jfri2/Purdue_MLEC/Hardware/KiCAD/MLEC_Doc/Images/MLEC_Front.PNG

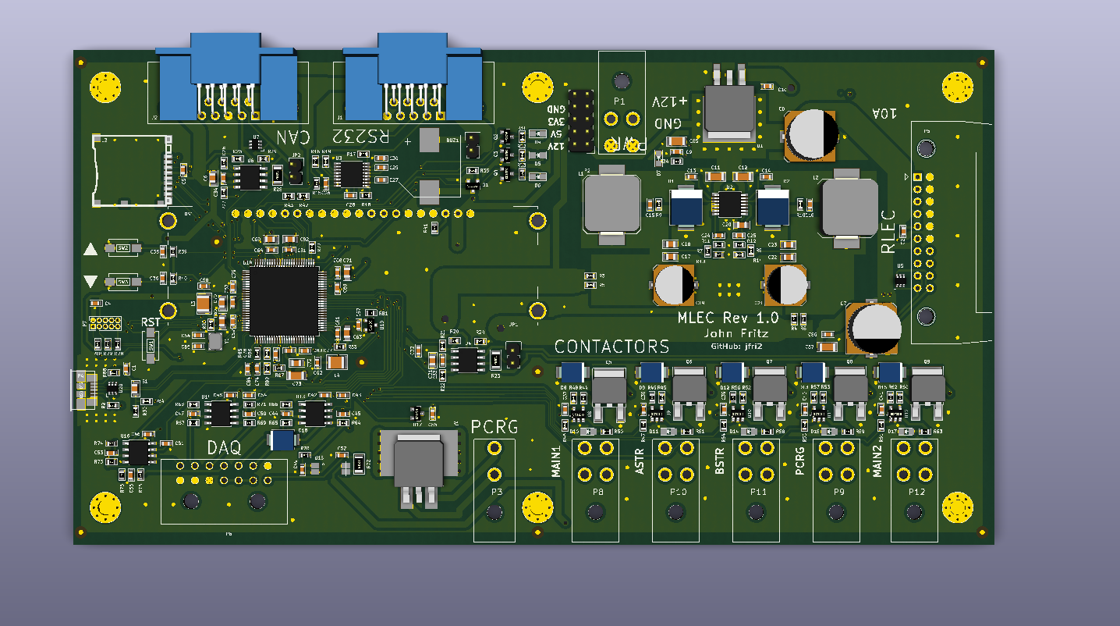
Hardware/KiCAD/MLEC_Doc/Images/MLEC_Front.PNG
