jfri2/Purdue_MLEC/Software/CANBusMonitor/CANBusMonitor/CANBusMonitor/Documentation/latex/md_README.tex

C\+A\+N\+Bus\+Monitor Ind. Study Project Purdue University

Author\+: John Fritz Created\+: 06 Mar 2016 Updated\+: 06 Mar 2016

Notes\+: S\+U\+T\+\_\+\+C\+K\+S\+EL fuse needs to be changed to E\+X\+T\+X\+O\+S\+C\+\_\+8\+M\+H\+Z\+\_\+\+X\+X\+\_\+16\+K\+C\+K\+\_\+14\+C\+K\+\_\+4\+M\+S1
