jfri2/Purdue_MLEC/Hardware/KiCAD/ATSAM_Based_Battery_Management_System.html

# MLEC BOM Rev 0.0

Date

# 2016-04-12

Company

# Purdue University

Comment 1

# John Fritz

Comment 2

Comment 3

Comment 4

Total Parts

# 272 (Unique 90)

Ref

Qty

Value

Footprint

Mfg#

Tolerance

Type

mfg#

[B] -

B1

1

Ferrite Bead

FritzLib:C_0805_OUTLINE

[BUZ] -

BUZ1

1

BUZZER

FritzLib:SMI-1324-TW-3V-R

[C] -

C2 C4 C5 C10 C9 C86 C26 C27 C29 C28 C30 C32 C34 C35 C36 C41 C40 C39 C37 C38 C48 C50 C54 C56 C42 C43 C44 C45 C55 C49 C46 C47 C51 C53 C52 C61 C57 C62 C66 C77 C78 C79 C80 C81 C67 C68 C59 C58 C83 C84

50

100nF

FritzLib:C_0603_OUTLINE

C1 C24

2

10nF

FritzLib:C_0603_OUTLINE

C6 C31

2

10uF

FritzLib:C_0805_OUTLINE

C8 C7

2

470uF

Capacitors_SMD:c_elec_10x10.5

C20 C63 C71 C60 C72 C82 C70 C69

8

4.7uF

FritzLib:C_0805_OUTLINE

C14 C13

2

33nF

FritzLib:C_0603_OUTLINE

C11 C12 C85 C87

4

10uF

FritzLib:C_1206_OUTLINE

C3216X5R1E106M

C22 C23 C18 C17

4

10uF

FritzLib:C_0805_OUTLINE

C2012X5R0J106M

C21 C19

2

100uF

Capacitors_SMD:c_elec_8x6.5

EEEFC1A101P

C25

1

6.8nF

FritzLib:C_0603_OUTLINE

C16 C15

2

470pF

FritzLib:C_0603_OUTLINE

C33

1

10uF

FritzLib:C_0603_OUTLINE

C73

1

22uF

FritzLib:C_1206_OUTLINE

Ceramic

C64 C65 C74

3

10pF

FritzLib:C_0603_OUTLINE

[D] -

D2 D1

2

MBRS320TR

Diodes_SMD:SMC_Standard

D7

1

Power

FritzLib:LED_0805_OUTLINE

D4

1

ULED1

FritzLib:LED_0805_OUTLINE

D5

1

ULED2

FritzLib:LED_0805_OUTLINE

D6

1

ULED3

FritzLib:LED_0805_OUTLINE

D16 D13 D12 D8 D9 D18

6

SS26

Diodes_SMD:SMB_Standard

D17

1

MAIN2

LEDs:LED_0805

D15

1

PCRG

LEDs:LED_0805

D14

1

BSTR

LEDs:LED_0805

D10

1

MAIN1

LEDs:LED_0805

D11

1

ASTR

LEDs:LED_0805

[DS] -

DS1

1

NHD-0216CW

FritzLib:NHD_OLED_2x16

[F] -

F1

1

10A

Fuse_Holders_and_Fuses:Fuseholder5x20_horiz_open_lateral_Type-II

[FI] -

FI1 FI2 FI3 FI4 FI5 FI6 FI7 FI8

8

Fiducal

Fiducials:Fiducial_1mm_Dia_2.54mm_Outer_CopperTop

[J] -

J1

1

RS232_0

FritzLib:Assmann_DB9_ADX09

J2

1

VEHICLE_CAN

FritzLib:Assmann_DB9_ADX09

J3

1

microSD_Card

FritzLib:microsd_socket

[JP] -

JP1 JP2 JP3

3

JUMPER

Pin_Headers:Pin_Header_Straight_1x02

[L] -

L2 L1

2

22uH

Inductors:SELF-WE-PD-XXL

MSS1278-153ML

L4 L3

2

10uH

FritzLib:C_1210_OUTLINE

[P] -

P8

1

MAIN_1_CONT

Connectors_Molex:Molex_Microfit3_Header_02x02_Angled_43045-040x

0039301042

P9

1

PCRG_CONT

Connectors_Molex:Molex_Microfit3_Header_02x02_Angled_43045-040x

0039301042

P10

1

ASTR_CONT

Connectors_Molex:Molex_Microfit3_Header_02x02_Angled_43045-040x

0039301042

P11

1

BSTR_CONT

Connectors_Molex:Molex_Microfit3_Header_02x02_Angled_43045-040x

0039301042

P12

1

MAIN_2_CONT

Connectors_Molex:Molex_Microfit3_Header_02x02_Angled_43045-040x

0039301042

P5

1

RLEC

FritzLib:3M_RightAngle_20pos_N3428-5202RB

N3428-5202RB

P7

1

JTAG

Pin_Headers:Pin_Header_Straight_2x05_Pitch1.27mm

P4

1

USB_OTG

FritzLib:conn_usb_B_micro_smd

P2

1

PWR_JP

Pin_Headers:Pin_Header_Straight_2x05

P3

1

PCRG

Connectors_Molex:Molex_Microfit3_Header_02x01_Angled_43045-020x

P6

1

MLEC_DAQ_CONN

Connectors_Molex:Molex_Microfit3_Header_02x07_Angled_43045-140x

0430451401

P1

1

12V_CONN

Connectors_Molex:Molex_Microfit3_Header_02x02_Angled_43045-040x

[Q] -

Q4 Q3 Q2 Q1

4

BSS214N

TO_SOT_Packages_SMD:SOT-23

Q9 Q8 Q7 Q5 Q6

5

AOD516

TO_SOT_Packages_SMD:TO-252-2Lead

[R] -

R1

1

100

FritzLib:D2PAK-2Lead-7106DG_Heatsink

R2 R6 R4 R5 R3 R18 R19 R16 R17 R21 R22 R26 R27 R41 R60 R53 R52 R44 R45

19

0R

FritzLib:R_0603_OUTLINE

R8 R7 R30

3

20k

FritzLib:R_0603_OUTLINE

R12

1

6.34k

FritzLib:R_0603_OUTLINE

R14

1

698

FritzLib:R_0603_OUTLINE

R10 R9

2

10

FritzLib:R_0603_OUTLINE

R11

1

3.83k

FritzLib:R_0603_OUTLINE

R13

1

422

FritzLib:R_0603_OUTLINE

R15 R20 R24 R25 R29 R35 R39 R40 R42 R43 R62 R57 R56 R48 R49 R84 R88

17

10k

FritzLib:R_0603_OUTLINE

R23 R28

2

120

FritzLib:R_1206_OUTLINE

R34 R61 R63 R55 R59 R54 R58 R46 R50 R47 R51 R71 R76 R66 R64 R87

16

1k

FritzLib:R_0603_OUTLINE

R31 R32 R33

3

470

FritzLib:R_0603_OUTLINE

R69 R75 R65

3

19k

FritzLib:R_0603_OUTLINE

R70

1

100

FritzLib:R_0603_OUTLINE

R72

1

360

FritzLib:R_1206_OUTLINE

R67 R73

2

3.3k

FritzLib:R_0603_OUTLINE

R68 R74

2

5k

FritzLib:R_0603_OUTLINE

R81

1

4.7k

FritzLib:R_0603_OUTLINE

R83 R82

2

1R

FritzLib:R_0603_OUTLINE

R79 R80 R78

3

100k

FritzLib:R_0603_OUTLINE

R89

1

6.8k

FritzLib:R_0603_OUTLINE

1%

R85 R86

2

39R

FritzLib:R_0603_OUTLINE

R77

1

39

FritzLib:R_0603_OUTLINE

[SW] -

SW1

1

SW_RST

Buttons_Switches_SMD:SW_SPST_EVQPE1

SW2

1

OLED_UP_BUTTON

Buttons_Switches_SMD:SW_SPST_EVQPE1

SW3

1

OLED_DOWN_BUTTON

Buttons_Switches_SMD:SW_SPST_EVQPE1

[TP] -

TP1 TP6 TP11 TP9 TP4 TP2 TP7 TP12 TP10 TP5 TP3 TP8

12

TEST_1P

[U] -

U2

1

TPS54383

FritzLib:HTSSOP-14_4.4x5mm_Pitch0.65mm

U1

1

RBO40-40G

FritzLib:TO-263-2Lead

U3

1

ICL3221E

Housings_SSOP:TSSOP-16_4.4x5mm_Pitch0.65mm

U4 U6

2

SN65HVD230

Housings_SOIC:SOIC-8_3.9x4.9mm_Pitch1.27mm

U5 U7 U20

3

NUP2202

TO_SOT_Packages_SMD:SC-70-6

U12 U11 U10 U8 U9

5

IRS44273L

TO_SOT_Packages_SMD:SOT-23-5

U14 U16 U13

3

MCP6002

Housings_SOIC:SOIC-8_3.9x4.9mm_Pitch1.27mm

U17

1

MCP9700-TT

TO_SOT_Packages_SMD:SOT-23

U15

1

PC3H71x

FritzLib:PC3H710

U18

1

SAM3X4/8C-100LQFP

Housings_QFP:LQFP-100_14x14mm_Pitch0.5mm

U19

1

LM4040

TO_SOT_Packages_SMD:SOT-23

[W] -

W1 W2 W3 W4 W5 W6

6

GND

Mounting_Holes:MountingHole_3.2mm_M3_Pad_Via

[Y] -

Y1

1

12MHz

Crystals:crystal_FA238-TSX3225

# BOM made with KICAD_BOM_WIZARD (https://github.com/HashDefineElectronics/KiCad_BOM_Wizard) (Generated 4/18/2016 9:53:42 PM)
