jfri2/Purdue_MLEC/Hardware/KiCAD/ATSAM_Based_Battery_Management_System_BOM.xlsx

Title | MLEC
Revision | 1
Date | 2016-04-12
Generated | 2016-04-18 21:56
Company | Purdue University
Designer | John Fritz
Total Parts | 246
Total Unique Parts | 71
 |  | Reference | Qty (1 board theory) | Qty (1 board actual) | Qty (2 board actual) | Value | Tolerance | Footprint | Mfg# | DigiKey# | Comments
 |  | B1 | 1 | 2 | 5 | 600R Ferrite Bead |  | 0805 | MI0805K601R-10 | 240-2390-1-ND
 |  | BUZ1 | 1 | 1 | 2 | BUZZER |  | Custom | SMI-1324-TW-3V-R | 668-1386-5-ND
 |  | C2 C4 C5 C10 C9 C86 C26 C27 C29 C28 C30 C32 C34 C35 C36 C41 C40 C39 C37 C38 C48 C50 C54 C56 C42 C43 C44 C45 C55 C49 C46 C47 C51 C53 C52 C61 C57 C62 C66 C77 C78 C79 C80 C81 C67 C68 C59 C58 C83 C84 C33 | 51 | 100 | 150 | 100nF | 20% | 0603 | C0603C104M5RACTU | 399-7845-1-ND
 |  | C1 C24 | 2 | 4 | 10 | 10nF | 1% | 0603 | C0603C102F5GACTU | 399-7826-1-ND
 |  | C6 C31 C22 C23 C18 C17 | 6 | 8 | 20 | 10uF | 20% | 0805 | C0805C106K8RACTU | 490-1718-1-ND
 |  | C8 C7 | 2 | 3 | 5 | 470uF | 20% | SMD 10mm Dia | UCL1V471MNL1GS | 493-3961-1-ND
 |  | C20 C63 C71 C60 C72 C82 C70 C69 | 8 | 10 | 20 | 4.7uF | 10% | 0805 | C1206C475K3RACTU | 399-8204-1-ND
 |  | C14 C13 | 2 | 4 | 10 | 33nF | 10% | 0603 | C0603C333K3RACTU | 399-7904-1-ND
 |  | C11 C12 C85 C87 | 4 | 6 | 10 | 10uF | 10% | 1206 | C1206C106K3RACTU | 399-7442-1-ND
 |  | C21 C19 | 2 | 3 | 4 | 100uF | 20% | SMD 8mm Dia | EEEFC1A101P | PCE3989CT-ND
 |  | C25 | 1 | 3 | 10 | 6.8nF | 1% | 0603 | C0603C682F3GACTU | 399-11154-1-ND
 |  | C16 C15 | 2 | 4 | 10 | 470pF | 1% | 0603 | C1608C0G1H471F080AA | 445-5370-1-ND
 |  | C73 | 1 | 2 | 10 | 22uF |  | 1206 | C1206C226M8RACTU | 399-7444-1-ND
 |  | C64 C65 | 2 | 4 | 10 | 22pF | 1% | 0603 | C0603C220F1GACTU | 399-11145-1-ND
 |  | C74 | 1 | 2 | 10 | 10pF | 1% | 0603 | C0603C100F5GAC7867 | 399-9958-1-ND
 |  | D2 D1 | 2 | 3 | 4 | MBRS320TR |  | SMC | MBRS320 | MBRS320CT-ND
 |  | D7 | 1 | 2 | 10 | Power | Green | 0805 | HSMG-C170 | 516-1434-1-ND
 |  | D16 D13 D12 D8 D9 D18 | 6 | 8 | 20 | SS26 |  | SMB | SS26 | SS26FSCT-ND
 |  | D4 D5 D6 D10 D11 D14 D15 D17 | 8 | 10 | 20 | General LED | Amber | 0805 | HSMA-C170 | 516-1431-1-ND
 |  | DS1 | 1 | 1 | 2 | NHD-0216CW |  | Custom | NHD-0216CW-AB3 | NHD-0216CW-AB3-ND | If OLED is unused, DS1 can be left unpopulated
 |  | J1 | 1 | 1 | 2 | RS232_0 |  | DB9 Female | A-DF 09 A/KG-T4S | AE10924-ND | Alternate part: ADS09A-KG-TAXB5
 |  | J2 | 1 | 1 | 2 | VEHICLE_CAN |  | DB9 Male | A-DS 09 A/KG-T4S | AE10970-ND | Alternate part: ADF09A-KG-TASB5
 |  | J3 | 1 | 1 | 2 | microSD_Card |  | Custom microSD | 5027740891 | WM24066CT-ND
 |  | JPX | 1 | 1 | 2 | Breakaway Pin headers |  | Pin Header | PEC36SAAN | S1012E-36-ND
 |  | SHX | 3 | 3 | 10 | Jumper Shunts |  |  | 969102-0000-DA | 3M9580-ND
 |  | L2 L1 | 2 | 2 | 5 | 22uH |  | 12.5mm x 12.5mm | DRA127-220-R | 283-3590-1-ND
 |  | L4 L3 | 2 | 2 | 5 | 10uH |  | 1210 | CBC3225T100MR | 587-1625-1-ND
 |  | P8 P9 P10 P11 P12 P1 | 6 | 6 | 14 | 2x2 Connectors |  | Molex MiniFit jr 2x2 | 39301042 | WM21364-ND
 |  | P5 | 1 | 1 | 2 | RLEC |  | 20pos 3M Shrouded | N3428-5202RB | MHR20S-ND
 |  | P7 | 1 | 1 | 3 | JTAG |  | 10pos 1.27mm | 62201021121 | 732-5374-ND
 |  | P4 | 1 | 1 | 3 | USB_OTG |  | USB Micro-B | 10118192-0001LF | 609-4613-1-ND
 |  | P3 | 1 | 1 | 2 | PCRG |  | Molex MiniFit jr 1x2 | 39301022 | WM21363-ND
 |  | P6 | 1 | 1 | 2 | MLEC_DAQ_CONN |  | Molex MicroFit 2x7 | 430451401 | WM12758-ND
 |  | Q4 Q3 Q2 Q1 | 4 | 6 | 15 | BSS214N |  | SOT-23 | BSS214N H6327 | BSS214N H6327TR-ND | If Buzzer is unused Q1 can be left unpopulated
 |  | Q9 Q8 Q7 Q5 Q6 | 5 | 5 | 14 | AOD516 |  | DPAK | AOD516 | 785-1358-1-ND
 |  | HS1 | 1 | 1 | 3 | Heatsink |  | D2PAK | 7106DG | HS412-ND
 |  | R1 | 1 | 1 | 3 | 100 |  | D2PAK | PFS35-100RF1 | 696-1277-1-ND
 |  | R2 R6 R4 R5 R3 R18 R19 R16 R17 R21 R22 R26 R27 R41 R60 R53 R52 R44 R45 | 19 | 50 | 100 | 0R |  | 0603 | ERJ-3GEY0R00V | P0.0GCT-ND | If OLED is unused, R41 can be left unpopulated
 |  | R8 R7 R30 | 3 | 5 | 10 | 20k | 1% | 0603 | ERJ-3EKF2002V | P20.0KHCT-ND
 |  | R12 | 1 | 3 | 10 | 6.34k | 1% | 0603 | ERJ-3EKF6341V | P6.34KHCT-ND
 |  | R14 | 1 | 3 | 10 | 698 | 1% | 0603 | ERJ-3EKF6980V | P698HCT-ND
 |  | R10 R9 | 2 | 4 | 10 | 10 | 5% | 0603 | ERJ-PA3F10R0V | P10.00BYCT-ND
 |  | R11 | 1 | 3 | 10 | 3.83k | 1% | 0603 | ERJ-3EKF3831V | P3.83KHCT-ND
 |  | R13 | 1 | 3 | 10 | 422 | 1% | 0603 | ERJ-3EKF4220V | P422HCT-ND
 |  | R15 R20 R24 R25 R29 R35 R39 R40 R42 R43 R62 R57 R56 R48 R49 R84 R88 | 17 | 50 | 50 | 10k | 1% | 0603 | ERJ-3EKF1002V | P10.0KHCT-ND | If Buzzer is unused R35 can be left unpopulated. If OLED is unused, R42 and R43 can be left unpopulated
 |  | R23 R28 | 2 | 4 | 10 | 120 | 1% 1/8 Watt | 1206 | ERJ-8ENF1200V | P120FCT-ND
 |  | R34 R61 R63 R55 R59 R54 R58 R46 R50 R47 R51 R71 R76 R66 R64 R87 | 16 | 25 | 50 | 1k | 1% | 0603 | ERJ-3EKF1001V | P1.00KHCT-ND
 |  | R31 R32 R33 | 3 | 5 | 10 | 470 | 1/4 Watt | 0603 | ERJ-3EKF4700V | P470HCT-ND
 |  | R69 R75 R65 | 3 | 5 | 10 | 19k | 1% | 0603 | ERJ-3EKF1912V | P19.1KHCT-ND
 |  | R70 | 1 | 3 | 10 | 100 | 1/8 Watt | 0603 | ERJ-PA3F1000V | P100BYCT-ND
 |  | R72 | 1 | 3 | 10 | 360 | 1/2 Watt | 1206 | CRCW1206360RFKEAHP | 541-360UCT-ND
 |  | R67 R73 | 2 | 4 | 10 | 3.3k | 1% | 0603 | ERJ-3EKF3301V | P3.30KHCT-ND
 |  | R68 R74 | 2 | 4 | 10 | 5k | 1% | 0603 | ERJ-3EKF4991V | P4.99KHCT-ND
 |  | R81 | 1 | 3 | 10 | 4.7k |  | 0603 | ERJ-3EKF4701V | P4.70KHCT-ND
 |  | R83 R82 | 2 | 4 | 10 | 1 |  | 0603 | ERJ-3BQF1R0V | P17371CT-ND
 |  | R79 R80 R78 | 3 | 5 | 10 | 100k |  | 0603 | ERJ-3EKF1003V | P100KHCT-ND
 |  | R89 | 1 | 3 | 10 | 6.8k | 1% | 0603 | ERJ-3EKF6801V | P6.80KHCT-ND
 |  | R77 R85 R86 | 3 | 5 | 10 | 39 |  | 0603 | ERJ-6ENF39R0V | P39.0CCT-ND | If OLED is unused, R77 can be left unpopulated
 |  | SW1 SW2 SW3 | 3 | 5 | 10 | Pushbutton |  |  | EVQ-PE105K | P13594SCT-ND
 |  | U2 | 1 | 2 | 4 | TPS54383 |  | 14-HTSSOP | TPS54383PWP | 296-26995-5-ND
 |  | U1 | 1 | 2 | 4 | RBO40-40G |  | D2PAK | RBO40-40G-TR | 497-3714-1-ND
 |  | U3 | 1 | 2 | 4 | ICL3221E |  | 16-TSSOP | ICL3221EIVZ-T | ICL3221EIVZ-TCT-ND
 |  | U4 U6 | 2 | 3 | 6 | SN65HVD230 |  | 8-SOIC | SN65HVD230DR | 296-11654-1-ND
 |  | U5 U7 U20 | 3 | 5 | 10 | NUP2202 |  | 6-TSSOP | NUP2202W1T2G | NUP2202W1T2GOSCT-ND
 |  | U12 U11 U10 U8 U9 | 5 | 5 | 12 | IRS44273L |  | SOT-23-5 | IRS44273LTRPBF | IRS44273LTRPBFCT-ND
 |  | U14 U16 U13 | 3 | 5 | 8 | MCP6002 |  | 8-SOIC | MCP6002T-I/SN | MCP6002T-I/SNCT-ND
 |  | U17 | 1 | 3 | 5 | MCP9700-TT |  | SOT-23 | MCP9700T-E/TT | MCP9700T-E/TTCT-ND
 |  | U15 | 1 | 2 | 4 | PC3H71x |  | 4-SOIC | PC3H710NIP0F | 425-2108-1-ND
 |  | U18 | 1 | 2 | 3 | SAM3X4/8C-100LQFP |  | 100-LQFP | ATSAM3X8CA-AU | ATSAM3X8CA-AU-ND
 |  | U19 | 1 | 2 | 5 | LM4040 |  | SOT-23 | LM4040C30IDBZR | 296-20887-1-ND
 |  | Y1 | 1 | 2 | 4 | 12MHz |  | 4-SMD | FA-238V 12.0000MB-K3 | SER3682CT-ND
 |  | BOM made with KICAD_BOM_WIZARD (https://github.com/HashDefineElectronics/KiCad_BOM_Wizard.git)
 |  | Generated 4/18/2016 9:56:17 PM
