jfri2/Purdue_MLEC/Hardware/KiCAD/PDFs/ATSAM_Based_Battery_Management_System_Schematic.pdf

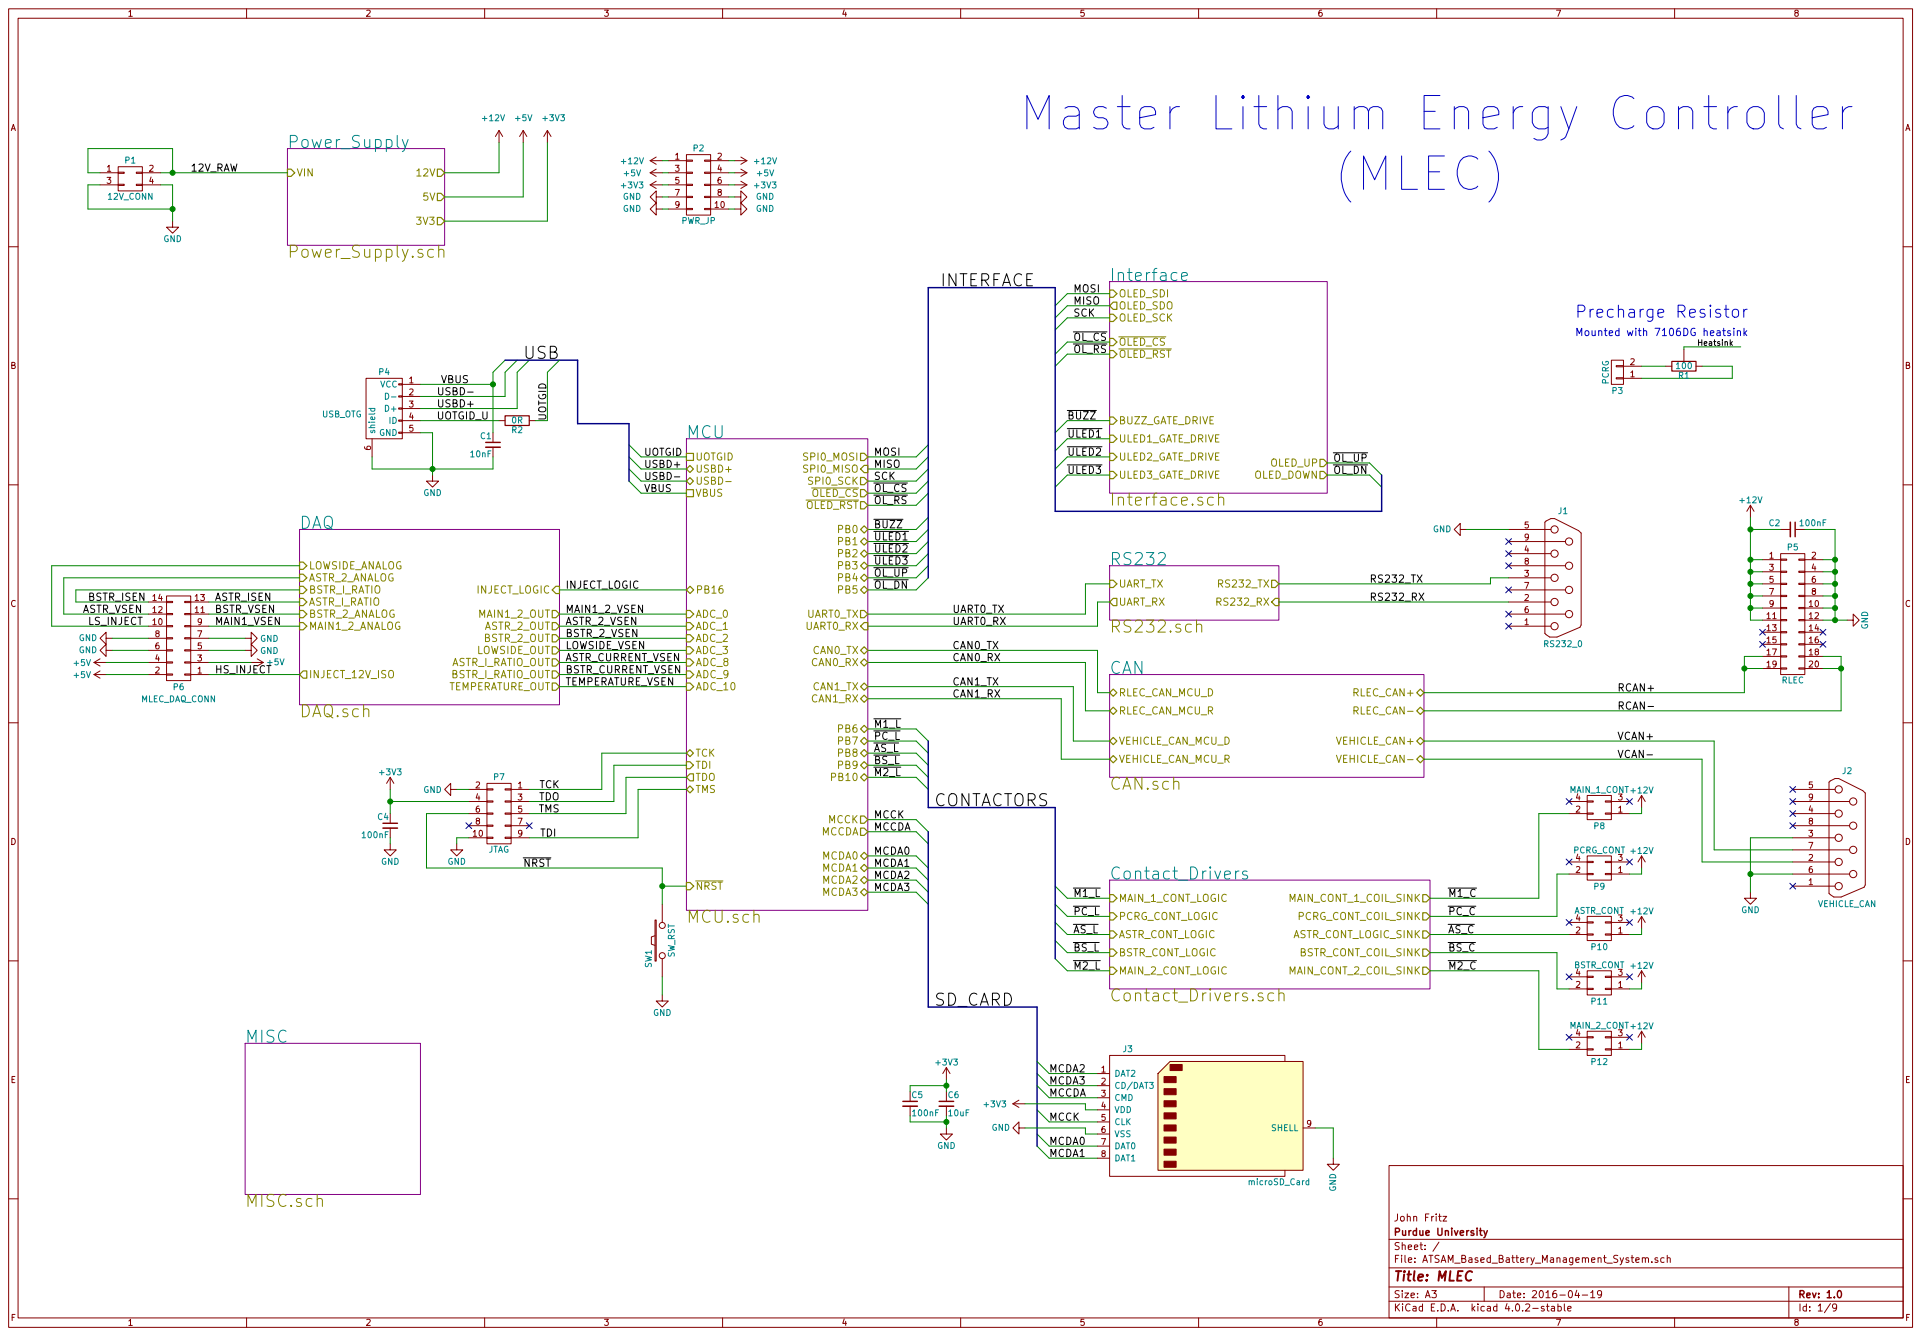
[picture p3: page 1]

Master Lithium Energy Controller

100 Heatsink MCU
TMS UOTGID
ADC_10 UOTGID
USBD+ VBUS USBD- TCK

LS_INJECT | | 10 | 9 MAIN1_VSEN | | ASTR_2_VSEN | UART0_RX

BSTR_2_VSEN
LOWSIDE_VSEN
ASTR_CURRENT_VSEN | | | | CAN0_RX
BSTR_CURRENT_VSEN | | | | CAN1_TX
TEMPERATURE_VSEN

File: ATSAM_Based_Battery_Management_System.sch Sheet: / Purdue University

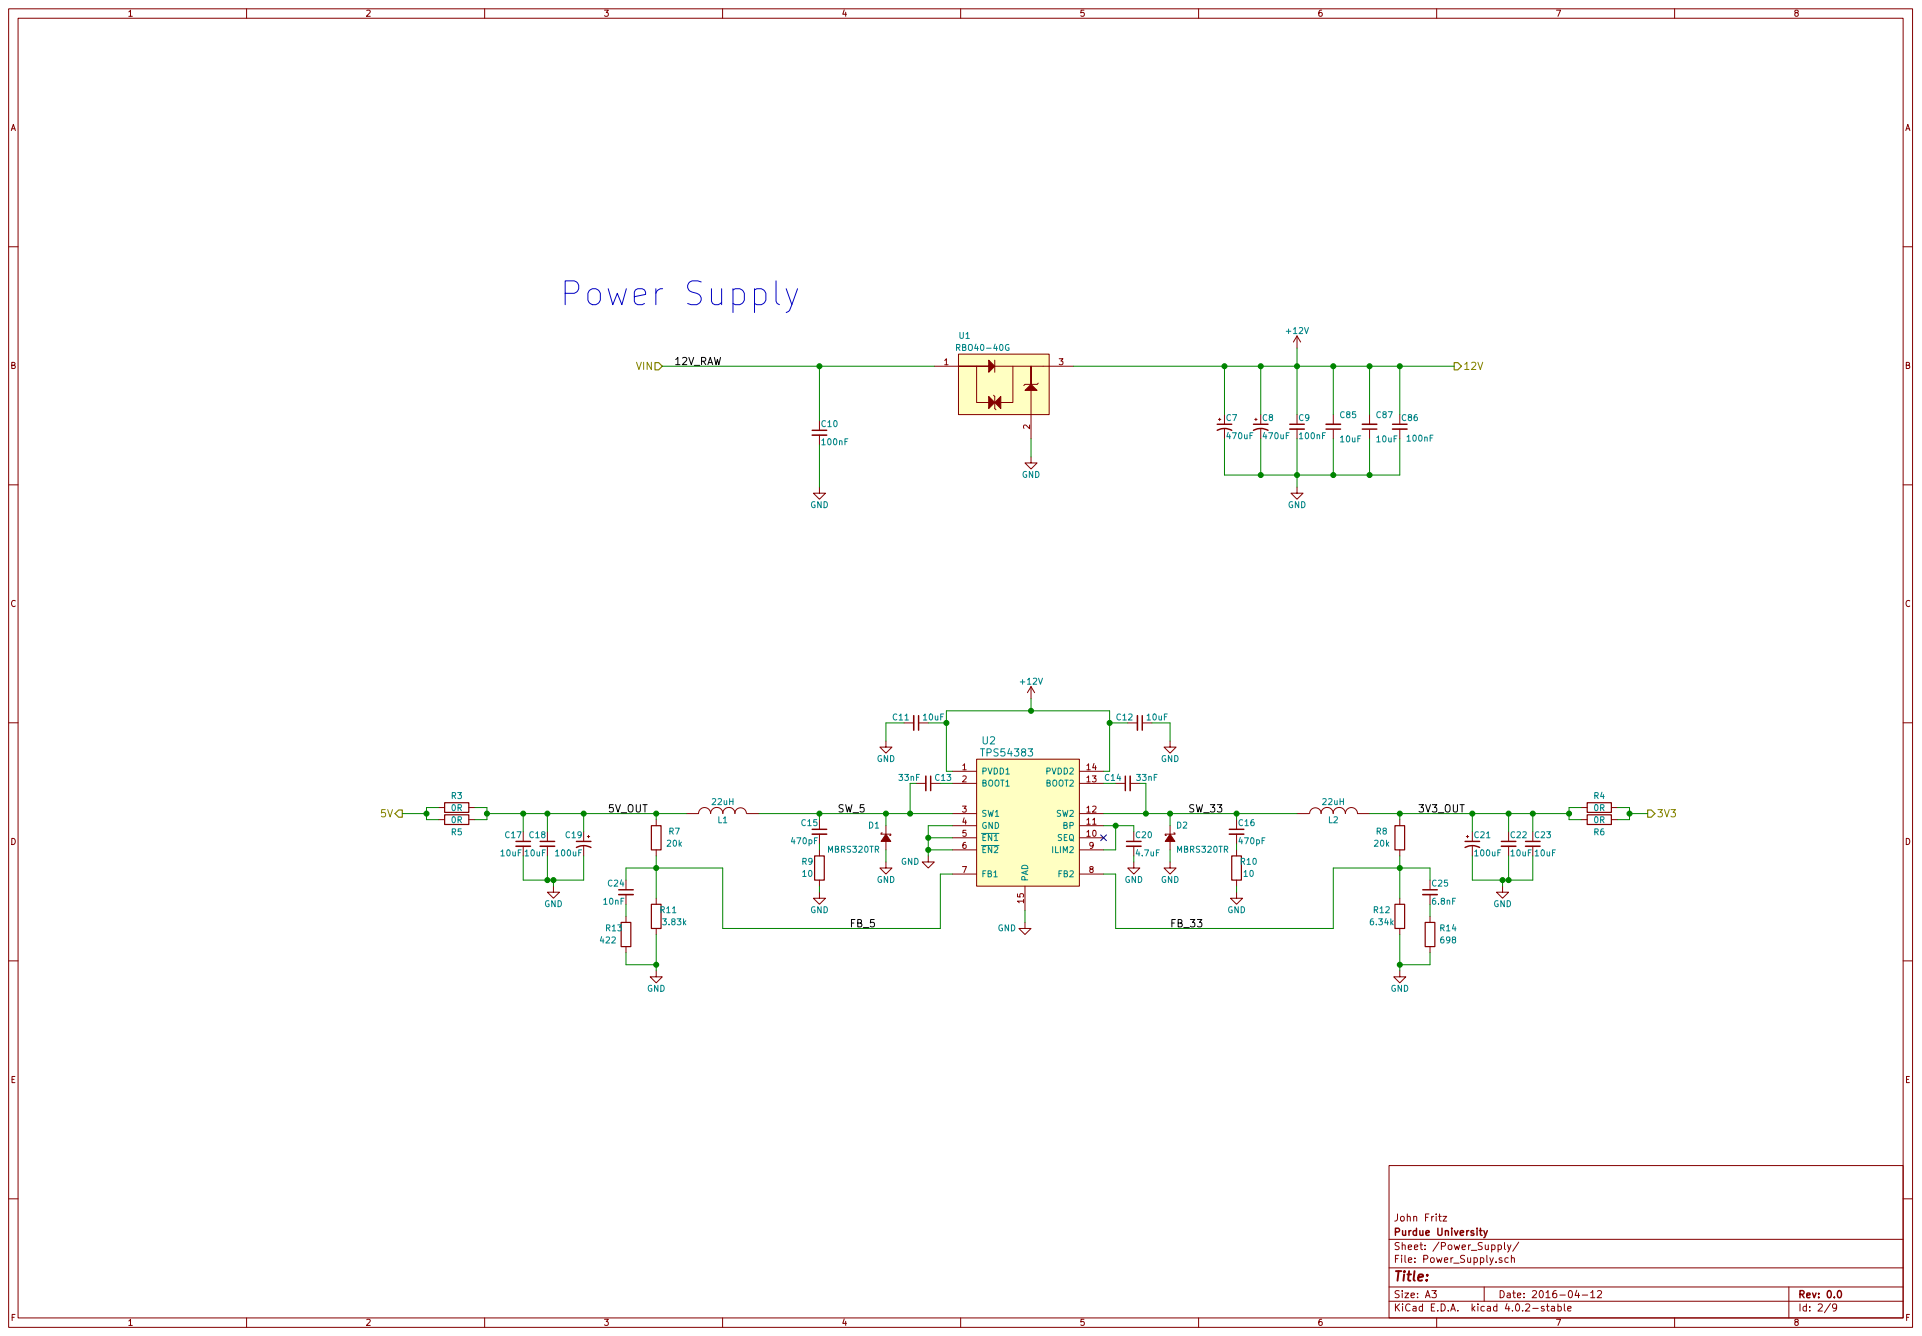
[picture p4: page 2]

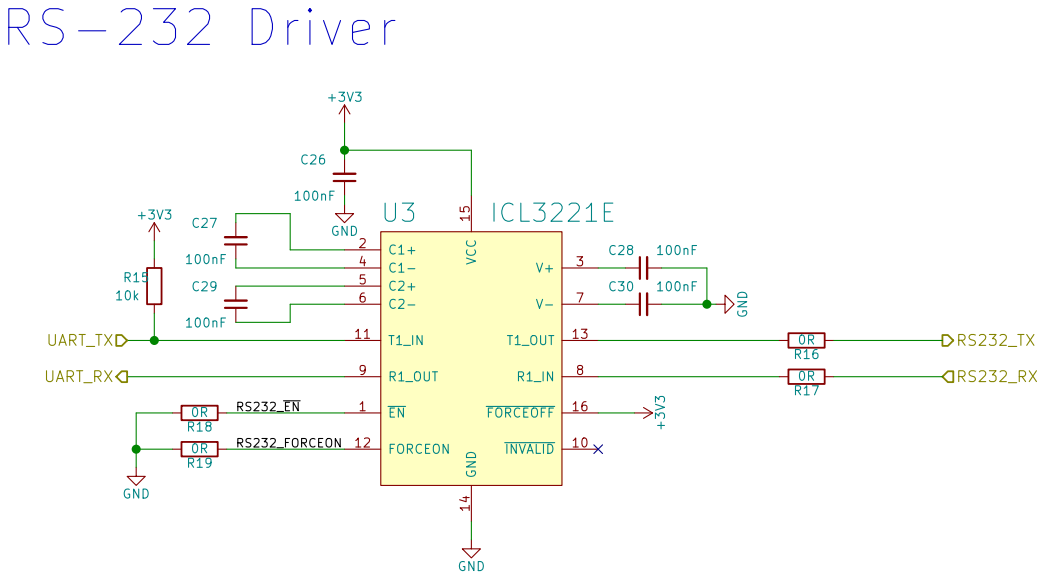
[picture p5: page 3]

John Fritz
Id: 3/9 Title: File: RS232.sch Sheet: /RS232/ Purdue University

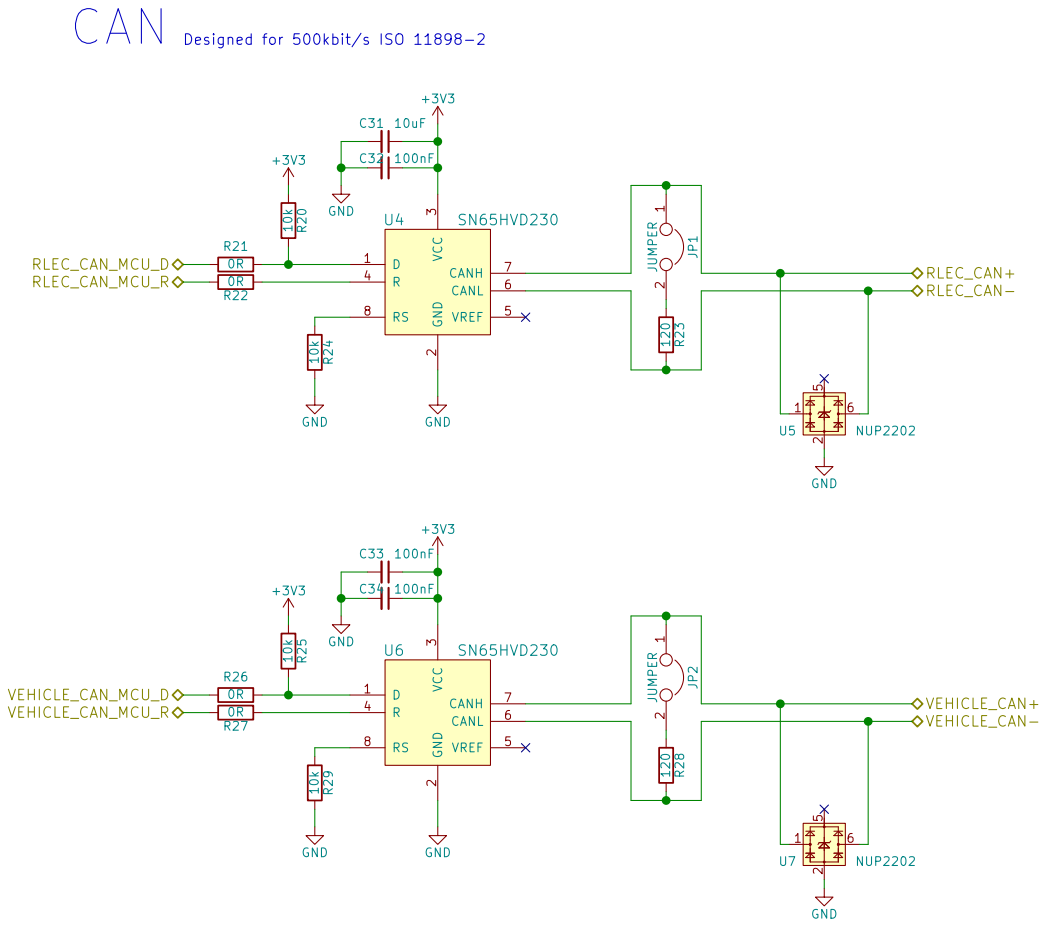
[picture p6: page 4]

John Fritz
Id: 4/9 Title: File: CAN.sch Sheet: /CAN/ Purdue University

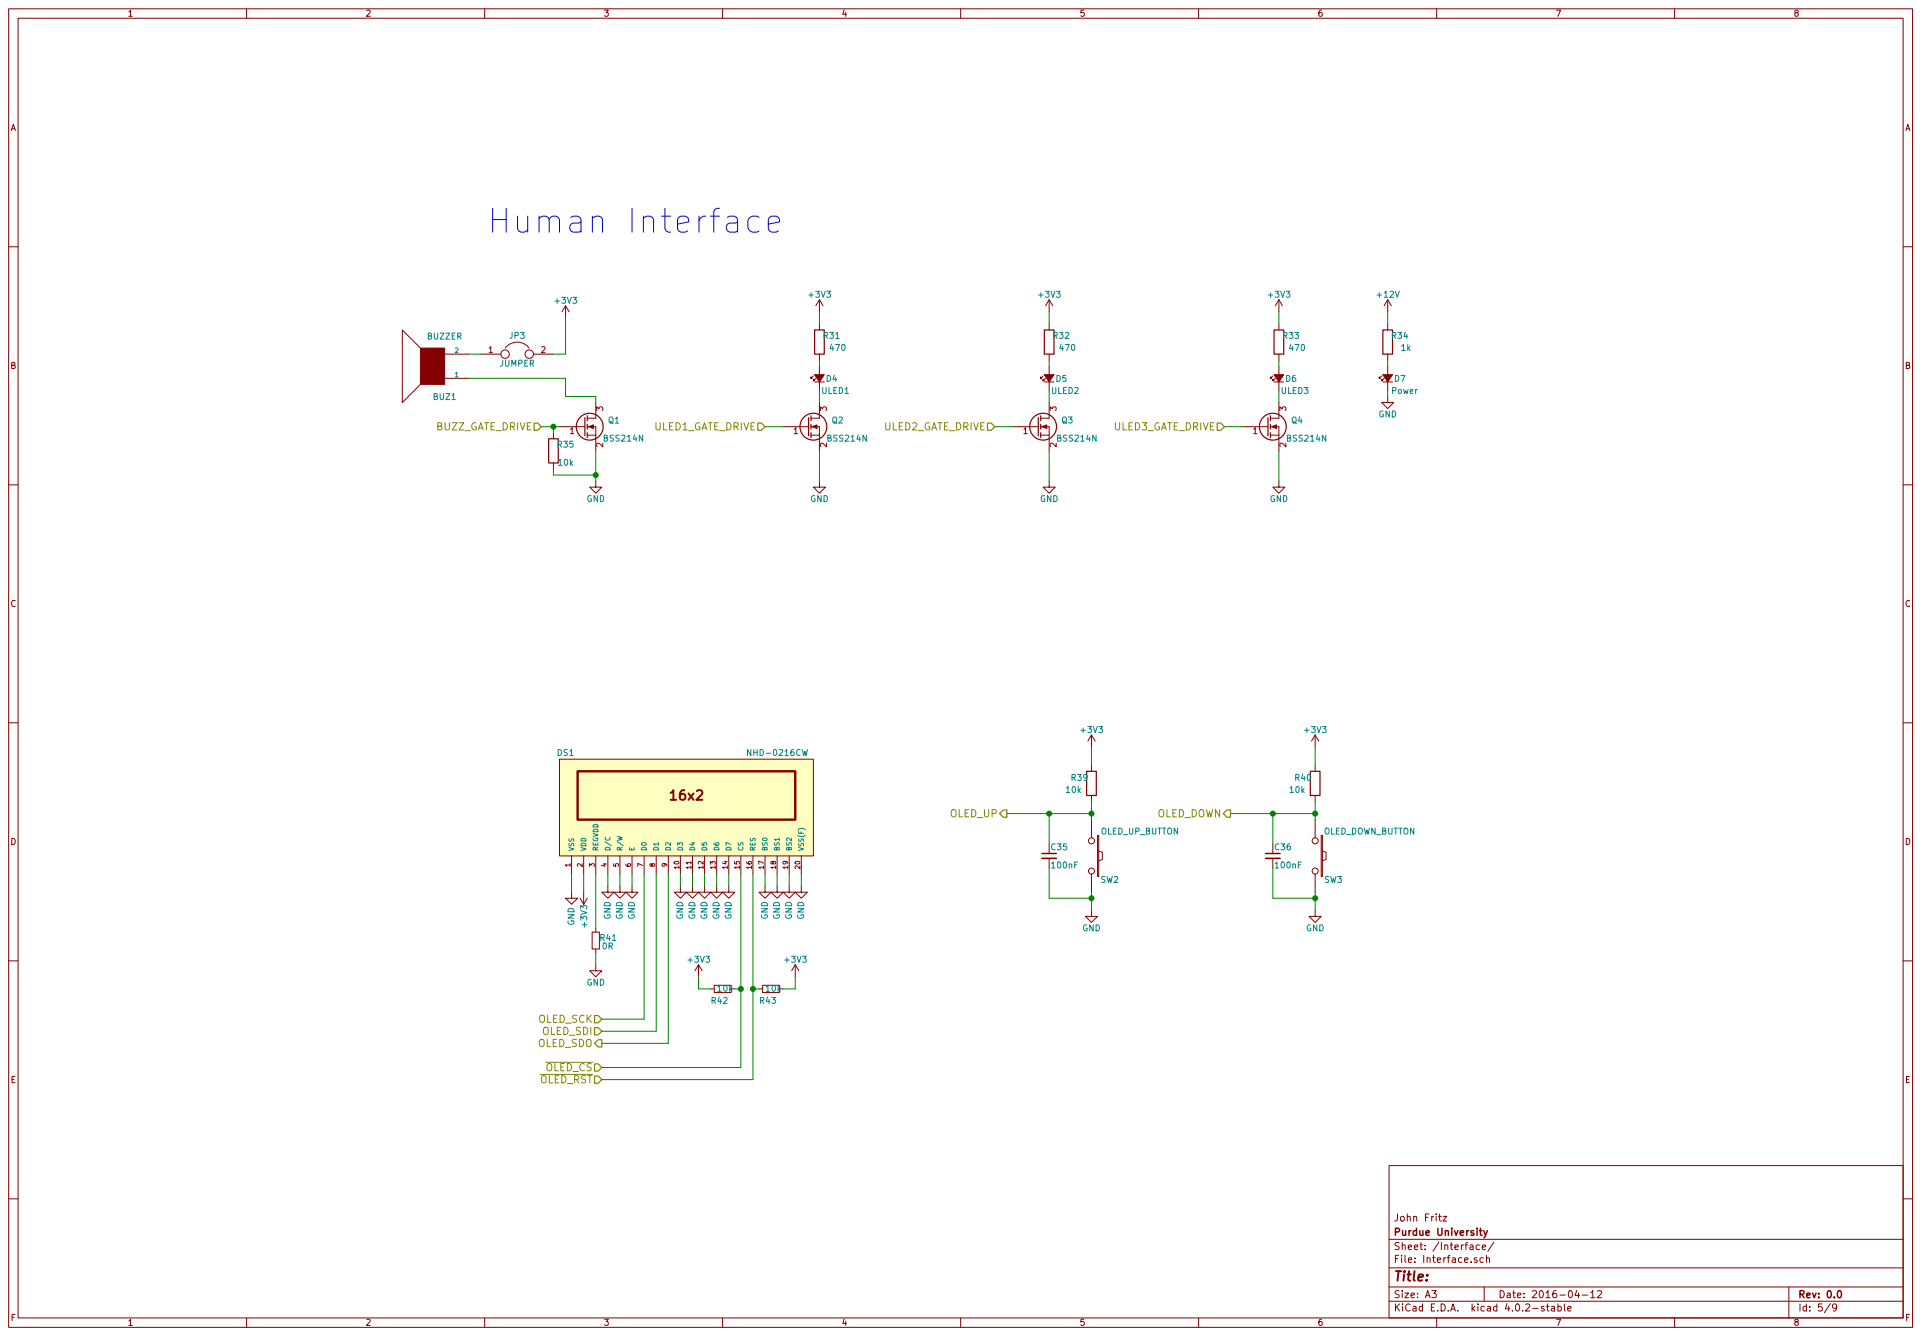
[picture p7: page 5]

9 D3 10 VSS(F) 20 D4 11 D5 12 D6 13 D7 14 CS 15 RES 16 BS0 17 BS1 18 BS2 19 DS1 NHD-0216CW GND +3V3 GND

John Fritz
Id: 5/9 Title: File: Interface.sch Sheet: /Interface/ Purdue University

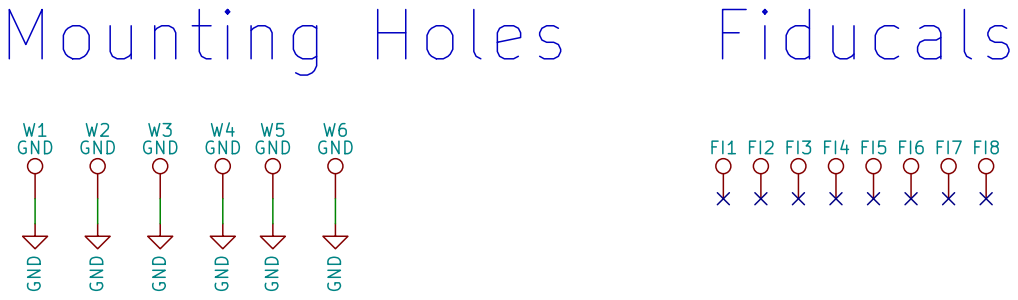
[picture p8: page 6]

John Fritz Mounting Holes

Id: 6/9 Title: File: MISC.sch Sheet: /MISC/ Purdue University

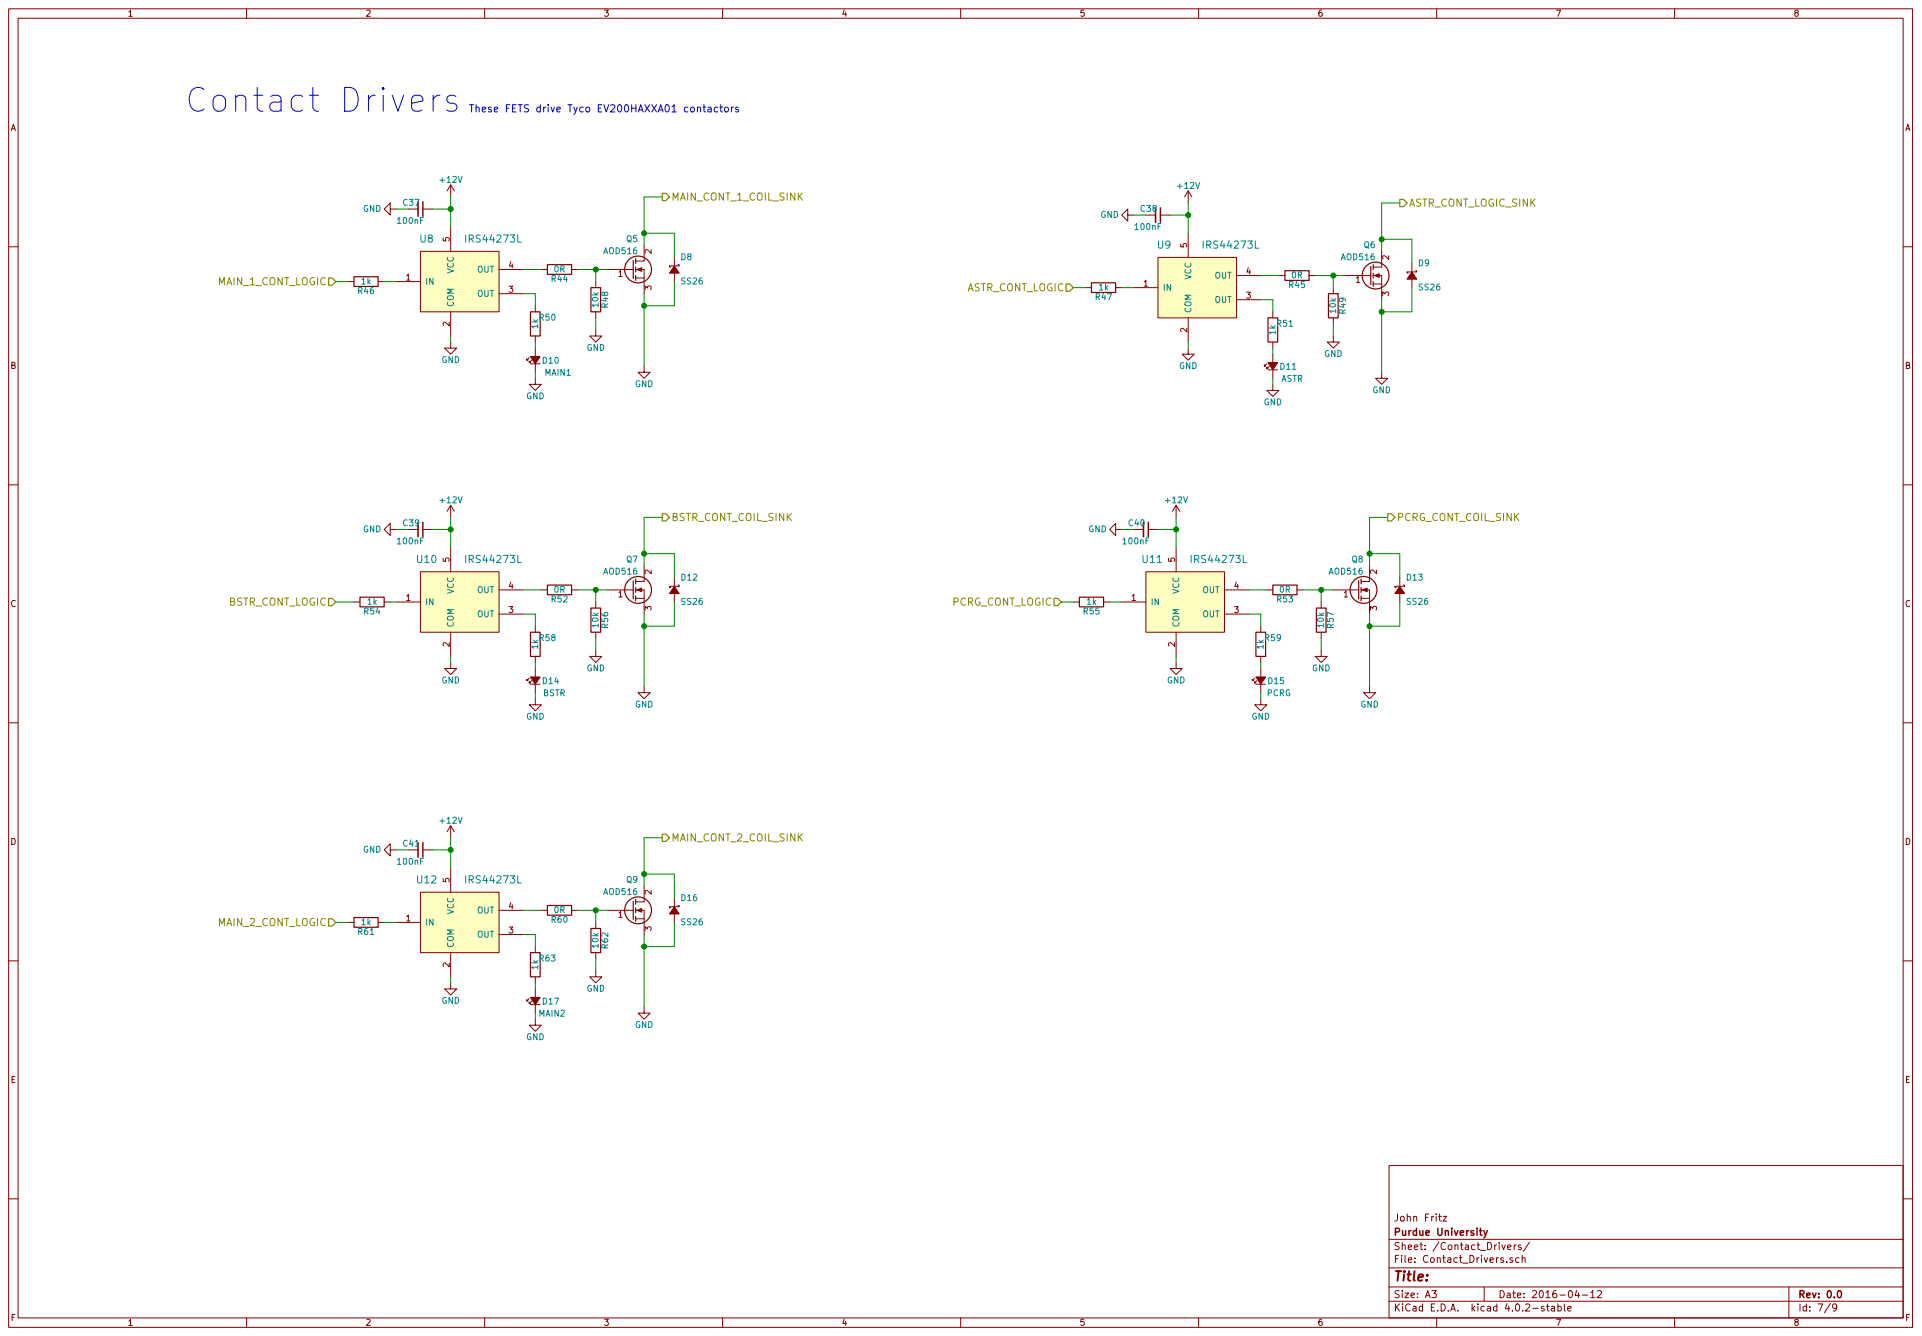
[picture p9: page 7]

R51 1k D11 ASTR GND Contact Drivers

These FETS drive Tyco EV200HAXXA01 contactors

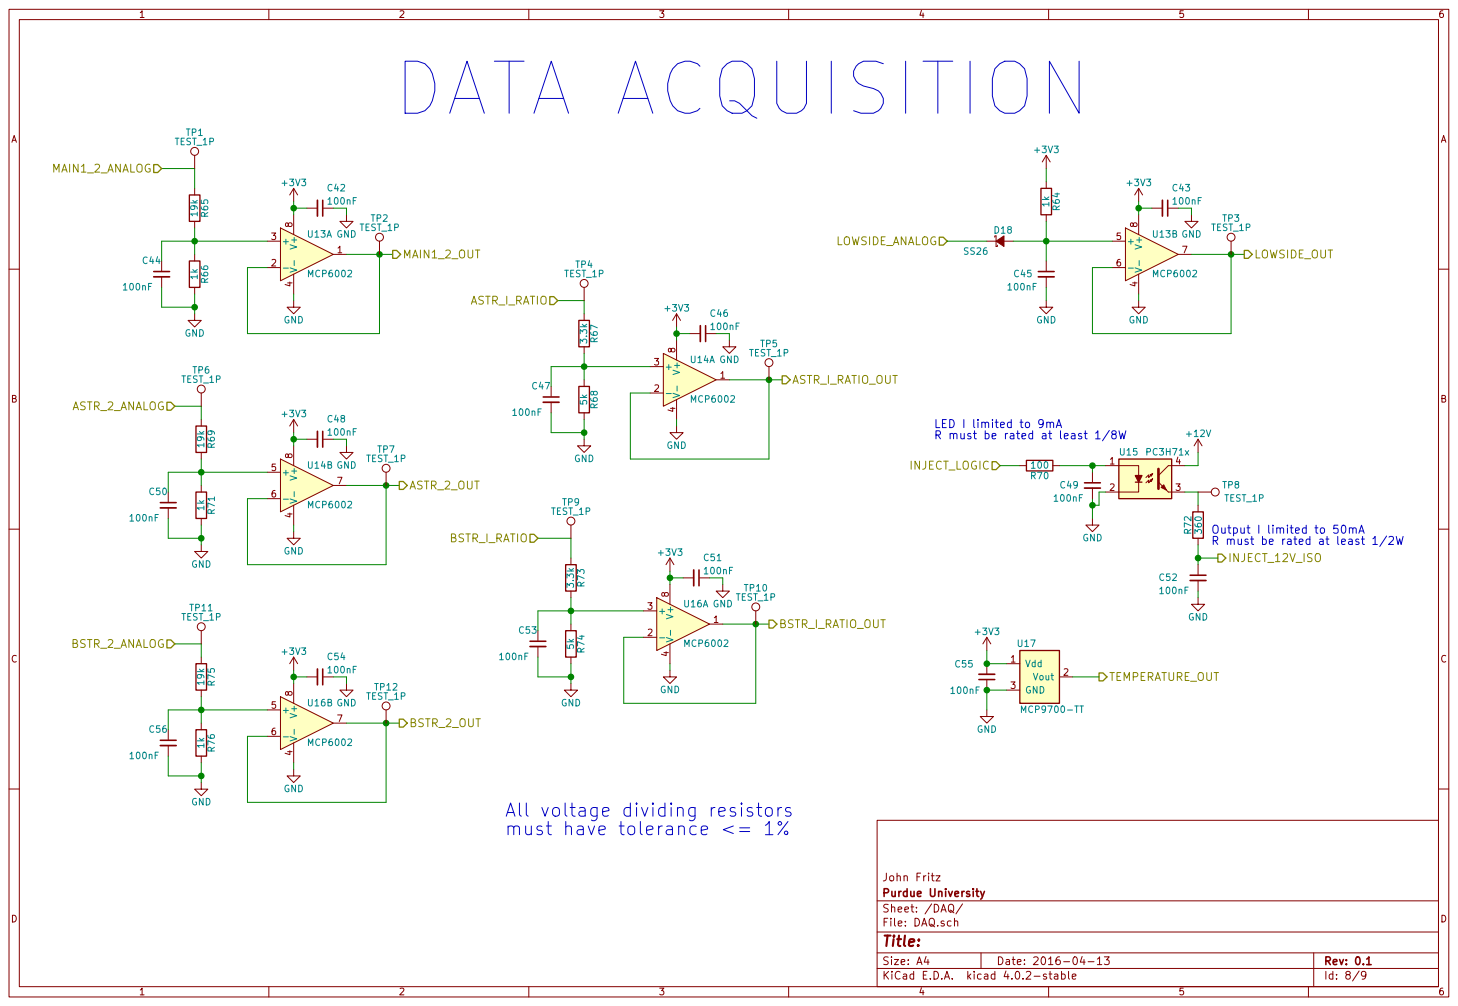
[picture p10: page 8]

LED I limited to 9mA
R must be rated at least 1/8W

Output I limited to 50mA
R must be rated at least 1/2W
INJECT_12V_ISO

All voltage dividing resistors

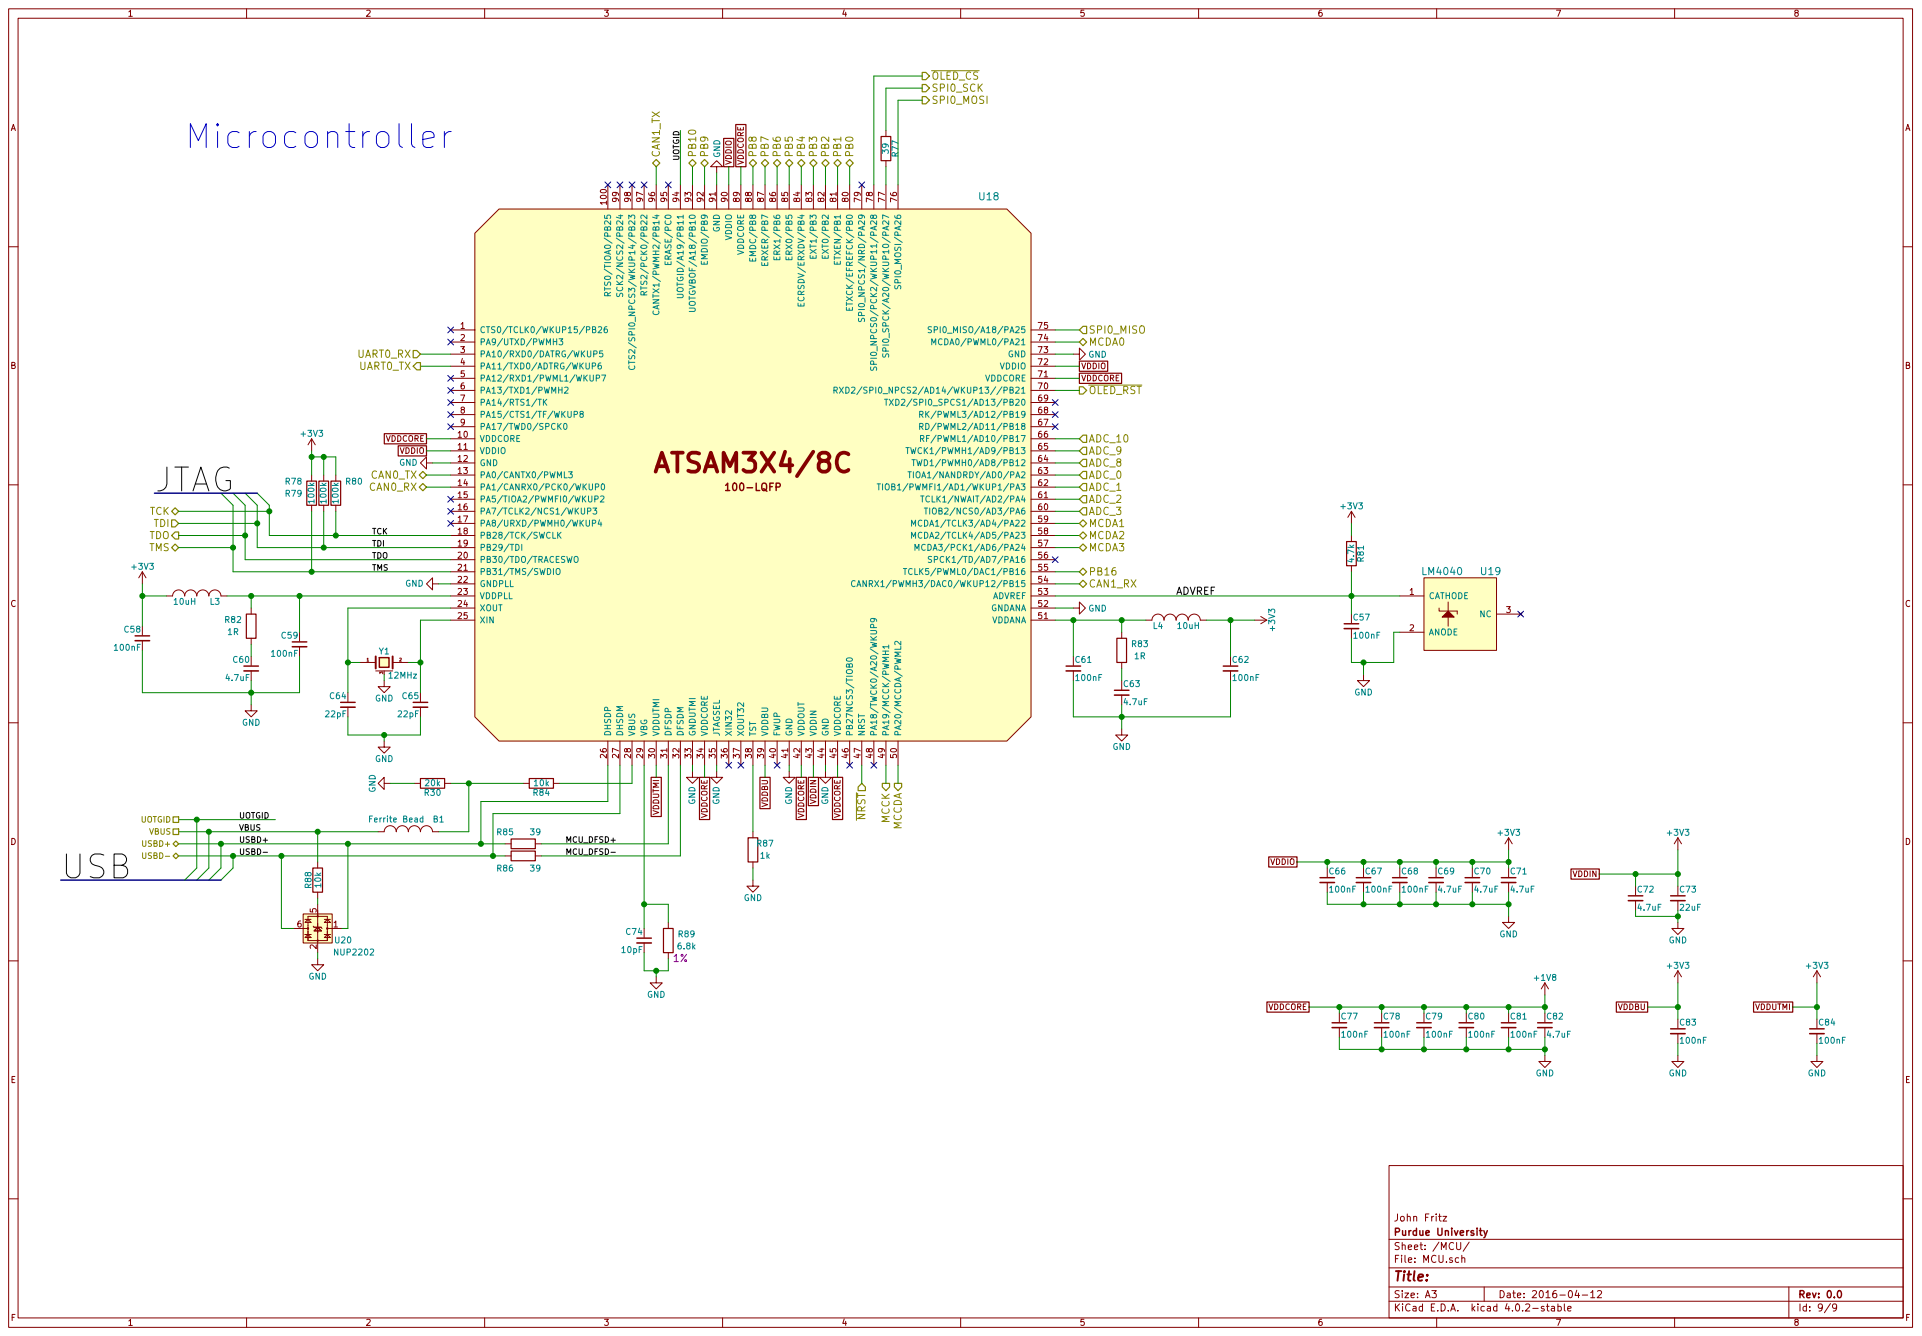
[picture p11: page 9]

USBD+ VBUS USBD- USB

John Fritz
Id: 9/9 Title: File: MCU.sch Sheet: /MCU/ Purdue University
