jfri2/Purdue_MLEC/Hardware/KiCAD/PDFs/BMS_High_Level_Block_Diagram.pdf

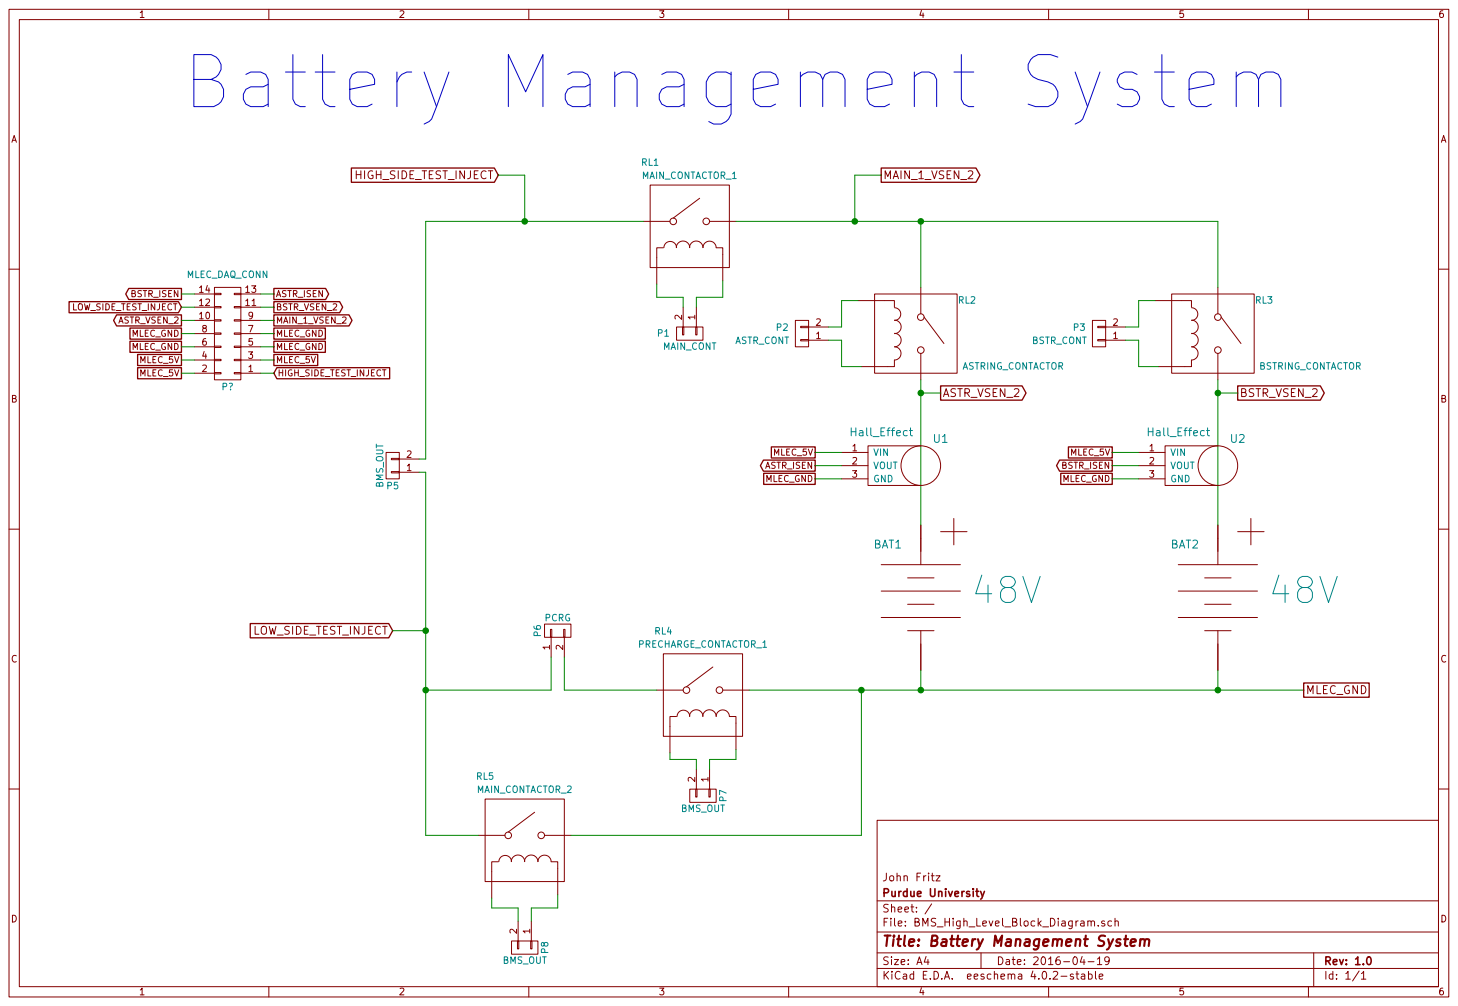
[picture p12: page 1]

John Fritz
File: BMS_High_Level_Block_Diagram.sch Sheet: / Purdue University

Id: 1/1 Title: Battery Management System
