jfri2/Purdue_MLEC/Hardware/KiCAD/PDFs/FAB_PDFs/DualMLEC/ATSAM_Based_Battery_Management_System-B.Cu.pdf

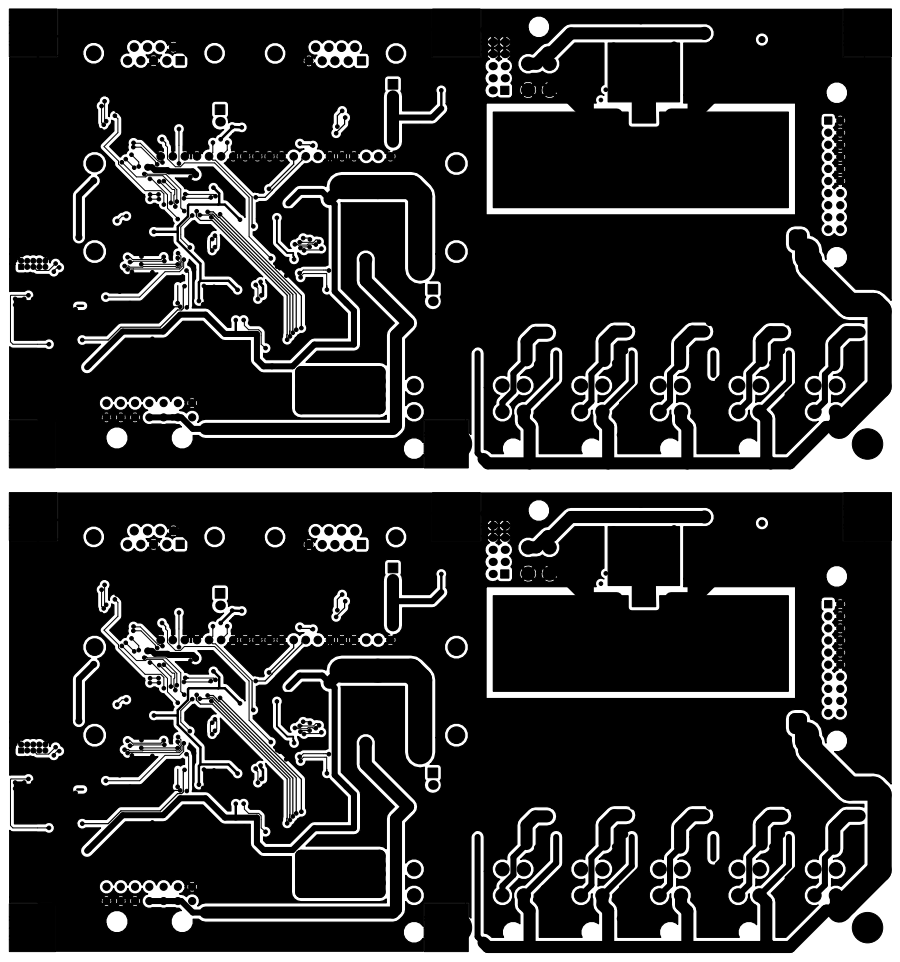
[picture p13: page 1]
