jfri2/Purdue_MLEC/Hardware/KiCAD/PDFs/FAB_PDFs/DualMLEC/ATSAM_Based_Battery_Management_System-B.Mask.pdf

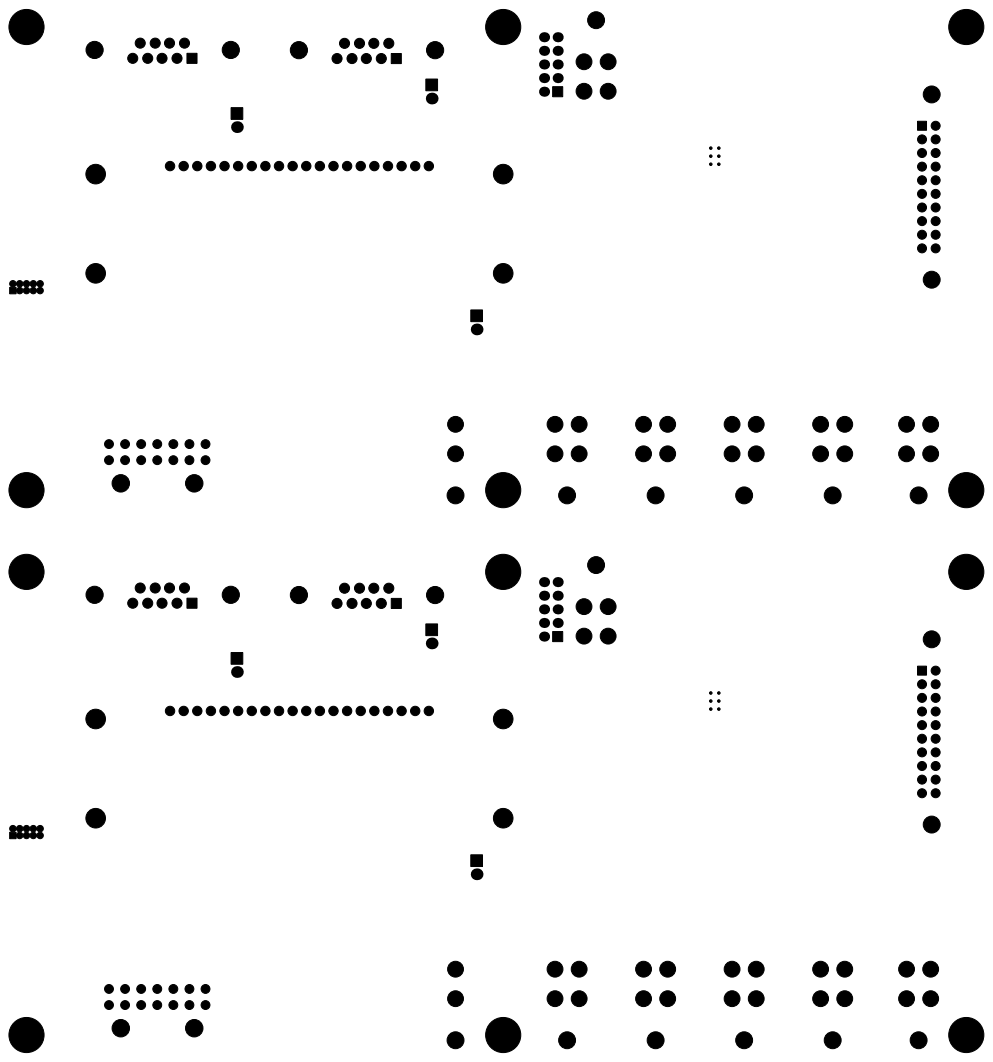
[picture p14: page 1]
