jfri2/Purdue_MLEC/Hardware/KiCAD/PDFs/FAB_PDFs/DualMLEC/ATSAM_Based_Battery_Management_System-F.Cu.pdf

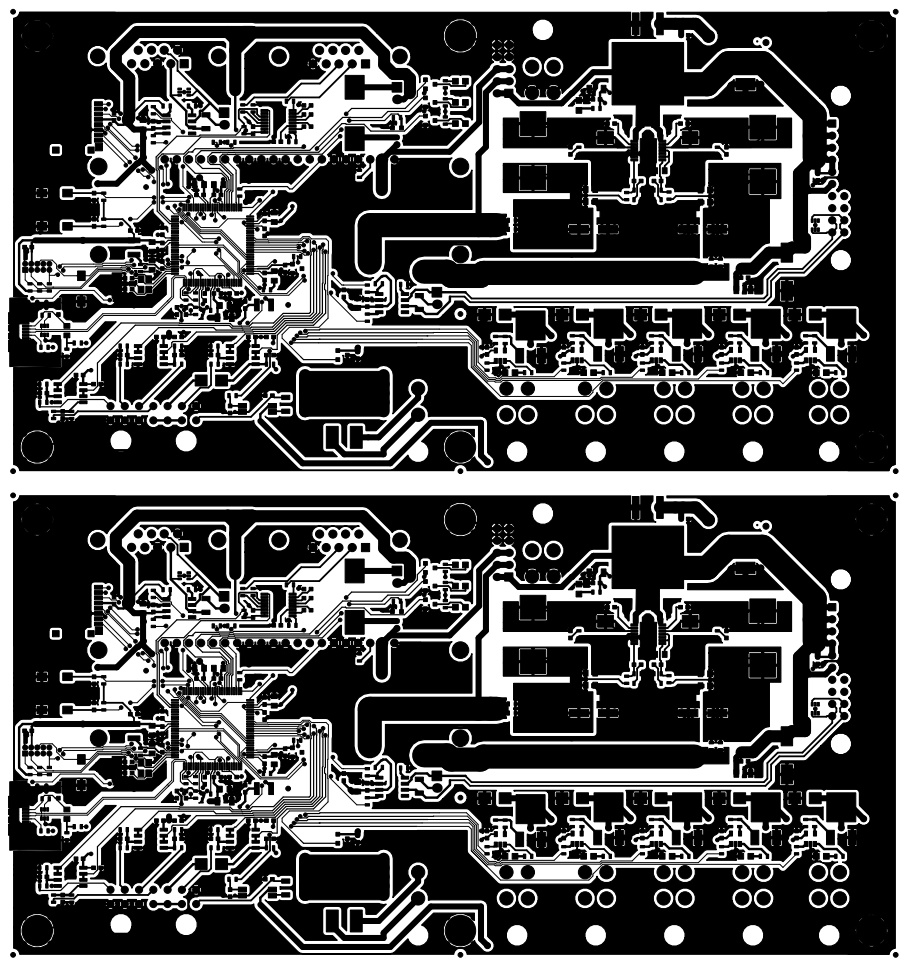
[picture p15: page 1]
