jfri2/Purdue_MLEC/Hardware/KiCAD/PDFs/FAB_PDFs/DualMLEC/ATSAM_Based_Battery_Management_System-F.SilkS.pdf

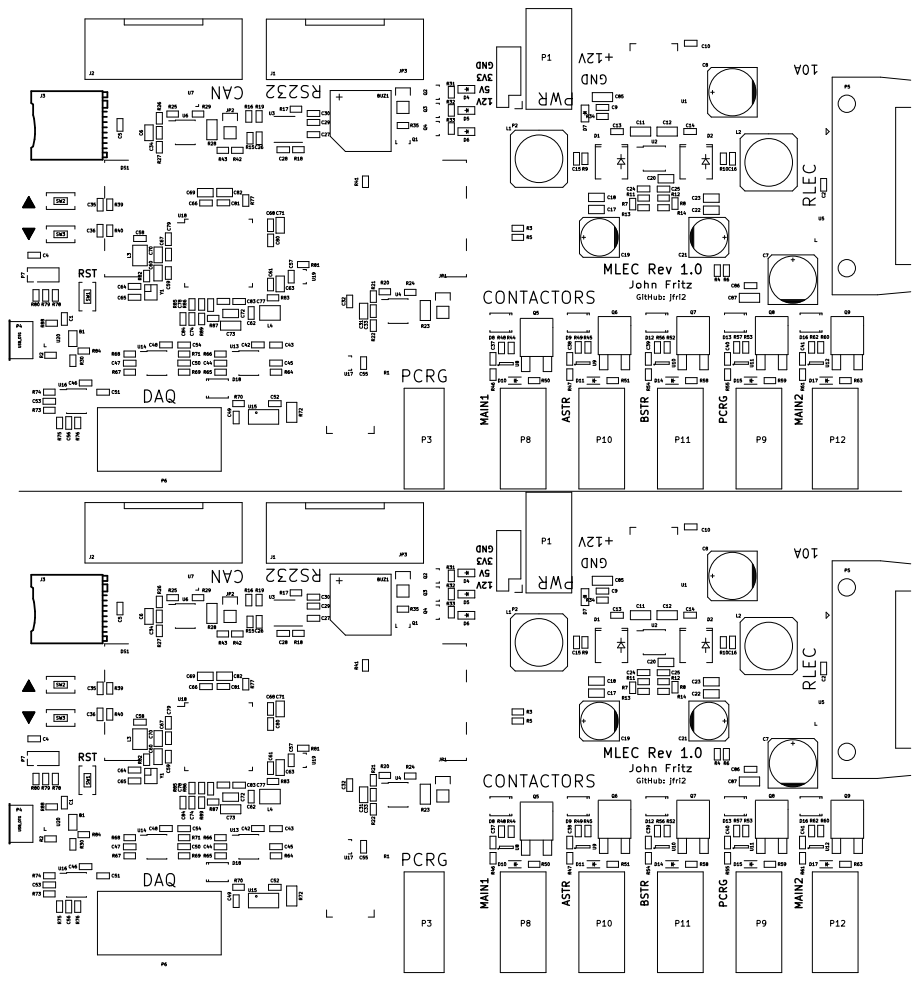
[picture p17: page 1]
