jfri2/Purdue_MLEC/Hardware/KiCAD/PDFs/FAB_PDFs/MLEC/ATSAM_Based_Battery_Management_System-B.Cu.pdf

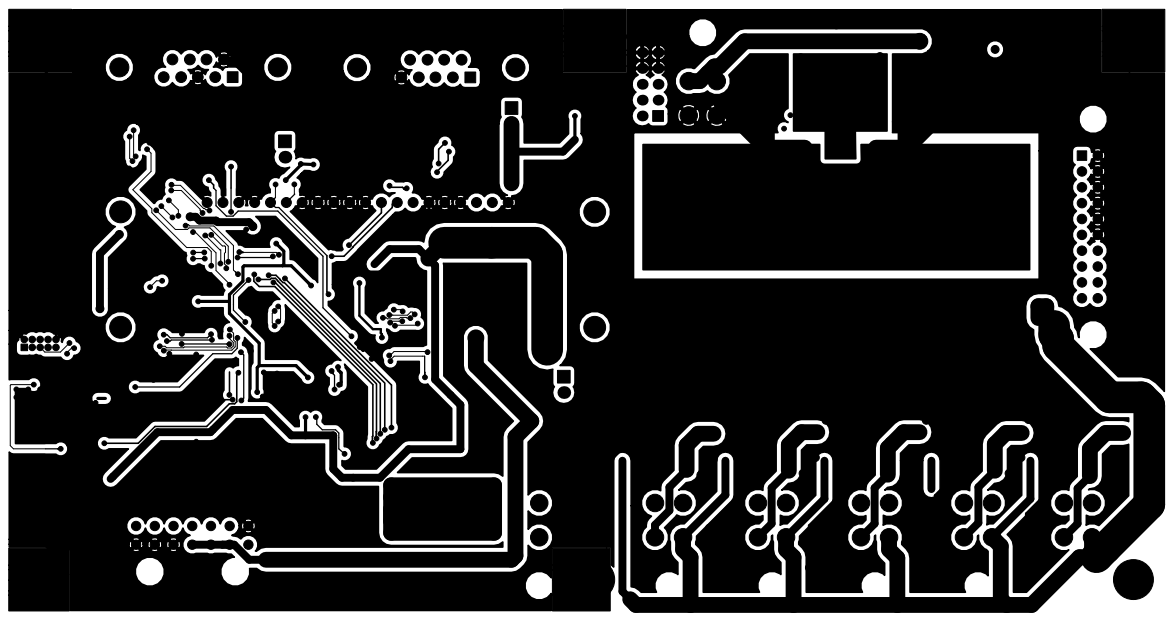
[picture p18: page 1]
