jfri2/Purdue_MLEC/Hardware/KiCAD/PDFs/FAB_PDFs/MLEC/ATSAM_Based_Battery_Management_System-B.Mask.pdf

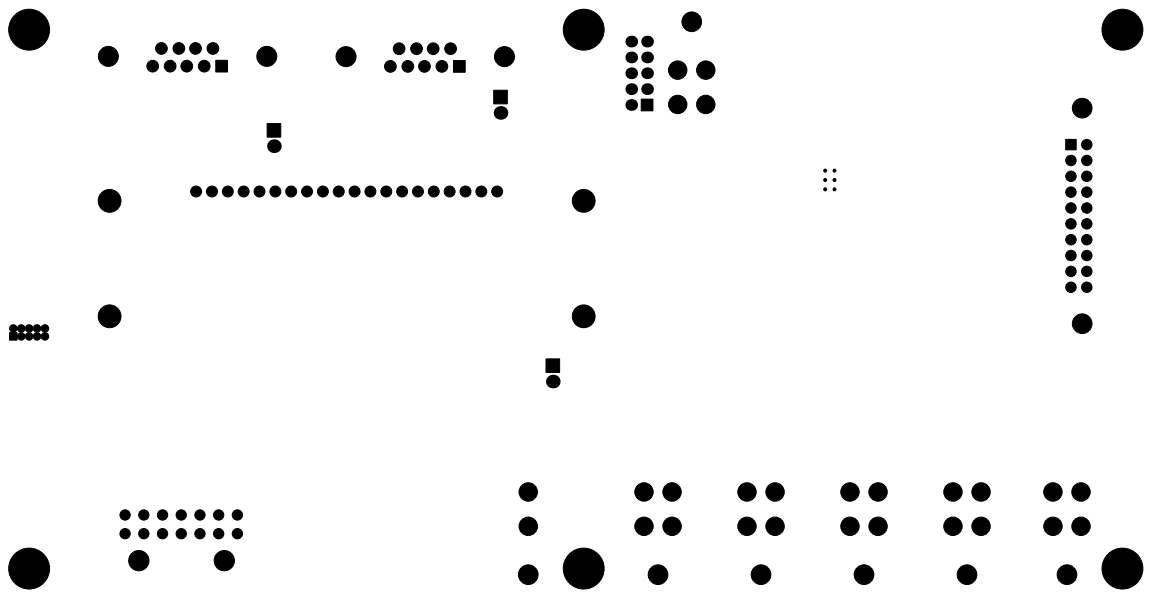
[picture p19: page 1]
