jfri2/Purdue_MLEC/Hardware/KiCAD/PDFs/FAB_PDFs/MLEC/ATSAM_Based_Battery_Management_System-F.Mask.pdf

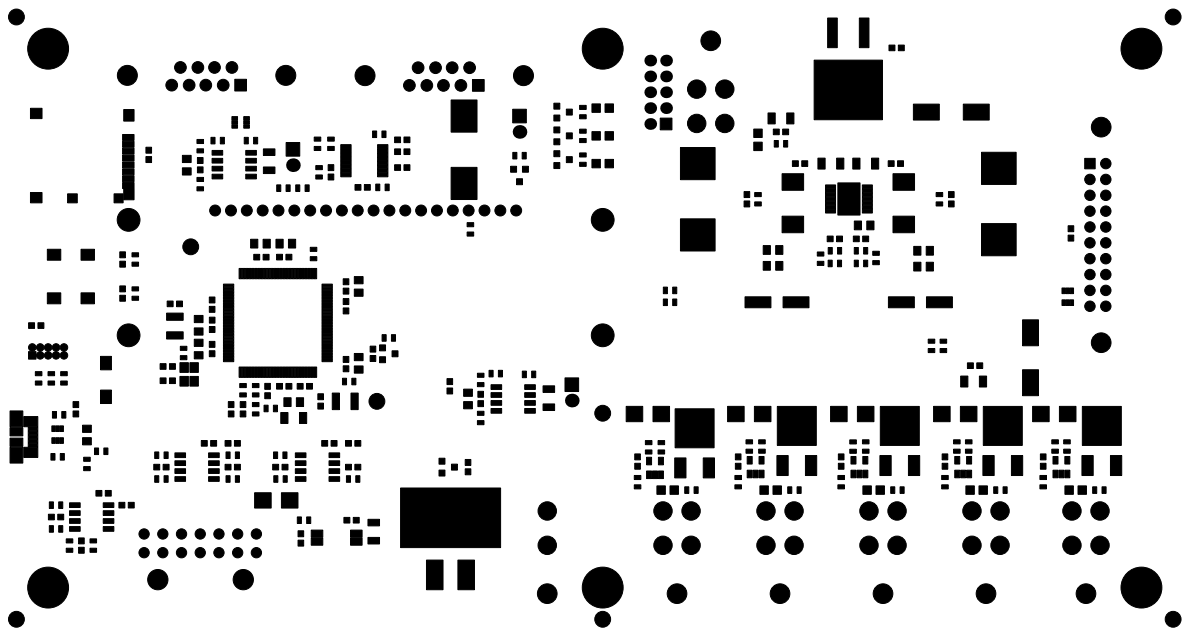
[picture p21: page 1]
