jfri2/Purdue_MLEC/Hardware/KiCAD/PDFs/FAB_PDFs/MLEC/ATSAM_Based_Battery_Management_System-F.SilkS.pdf

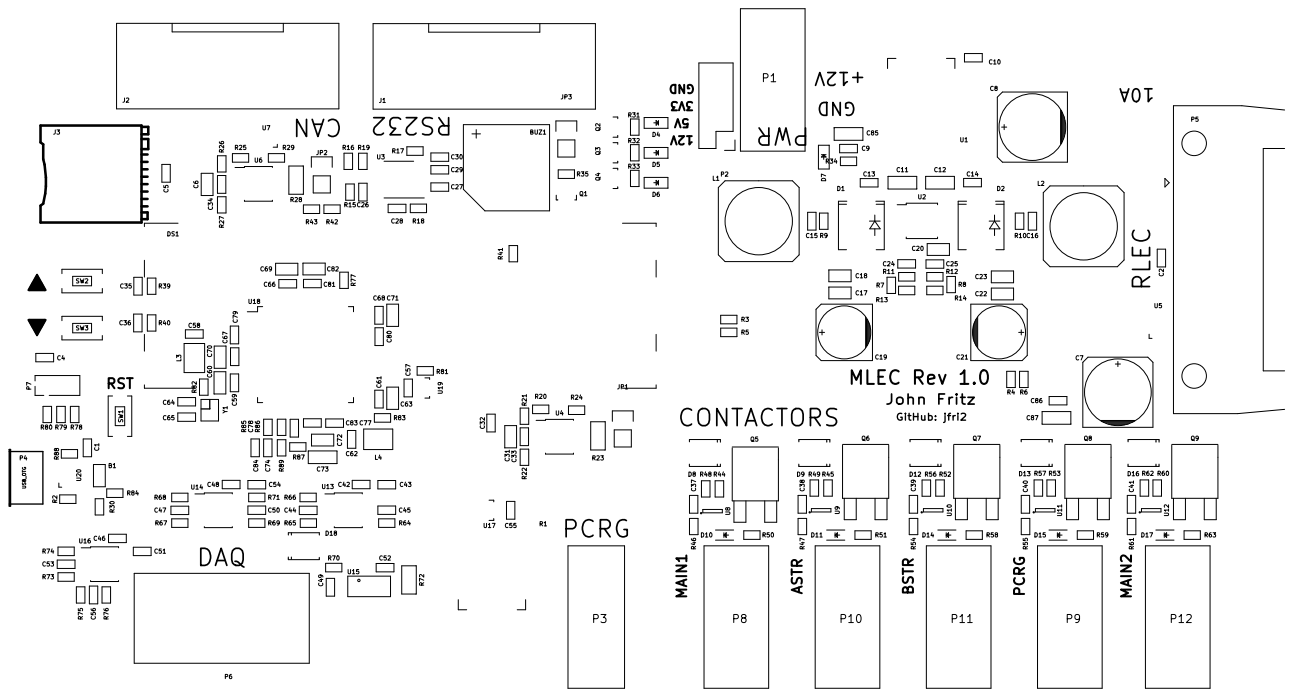
[picture p22: page 1]
