jfri2/Purdue_MLEC/Hardware/KiCAD/ATSAM_Based_Battery_Management_System.kicad_pcb

## KiCad design Hardware/KiCAD/ATSAM_Based_Battery_Management_System.kicad_pcb (2016-05-09)

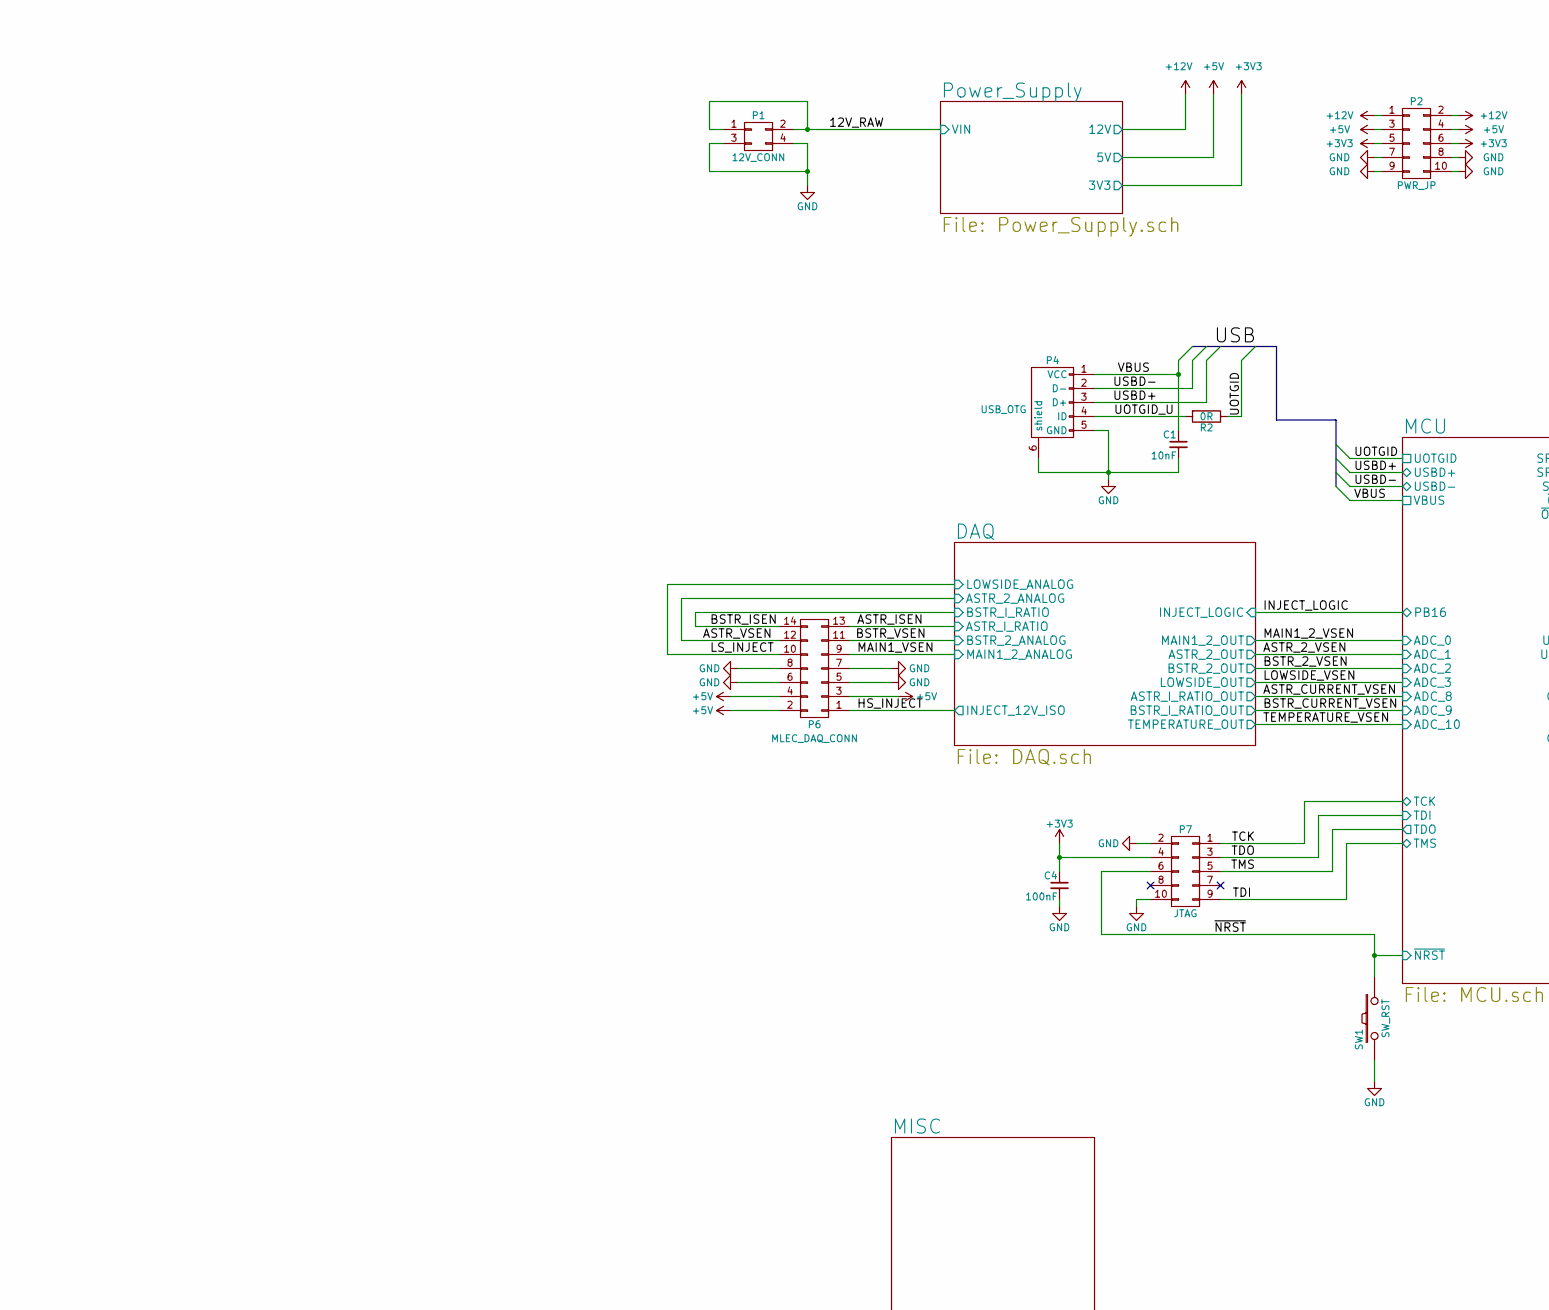
[picture p23: schematic ATSAM_Based_Battery_Management_System.sch, MLEC, part in row 1, column 1]

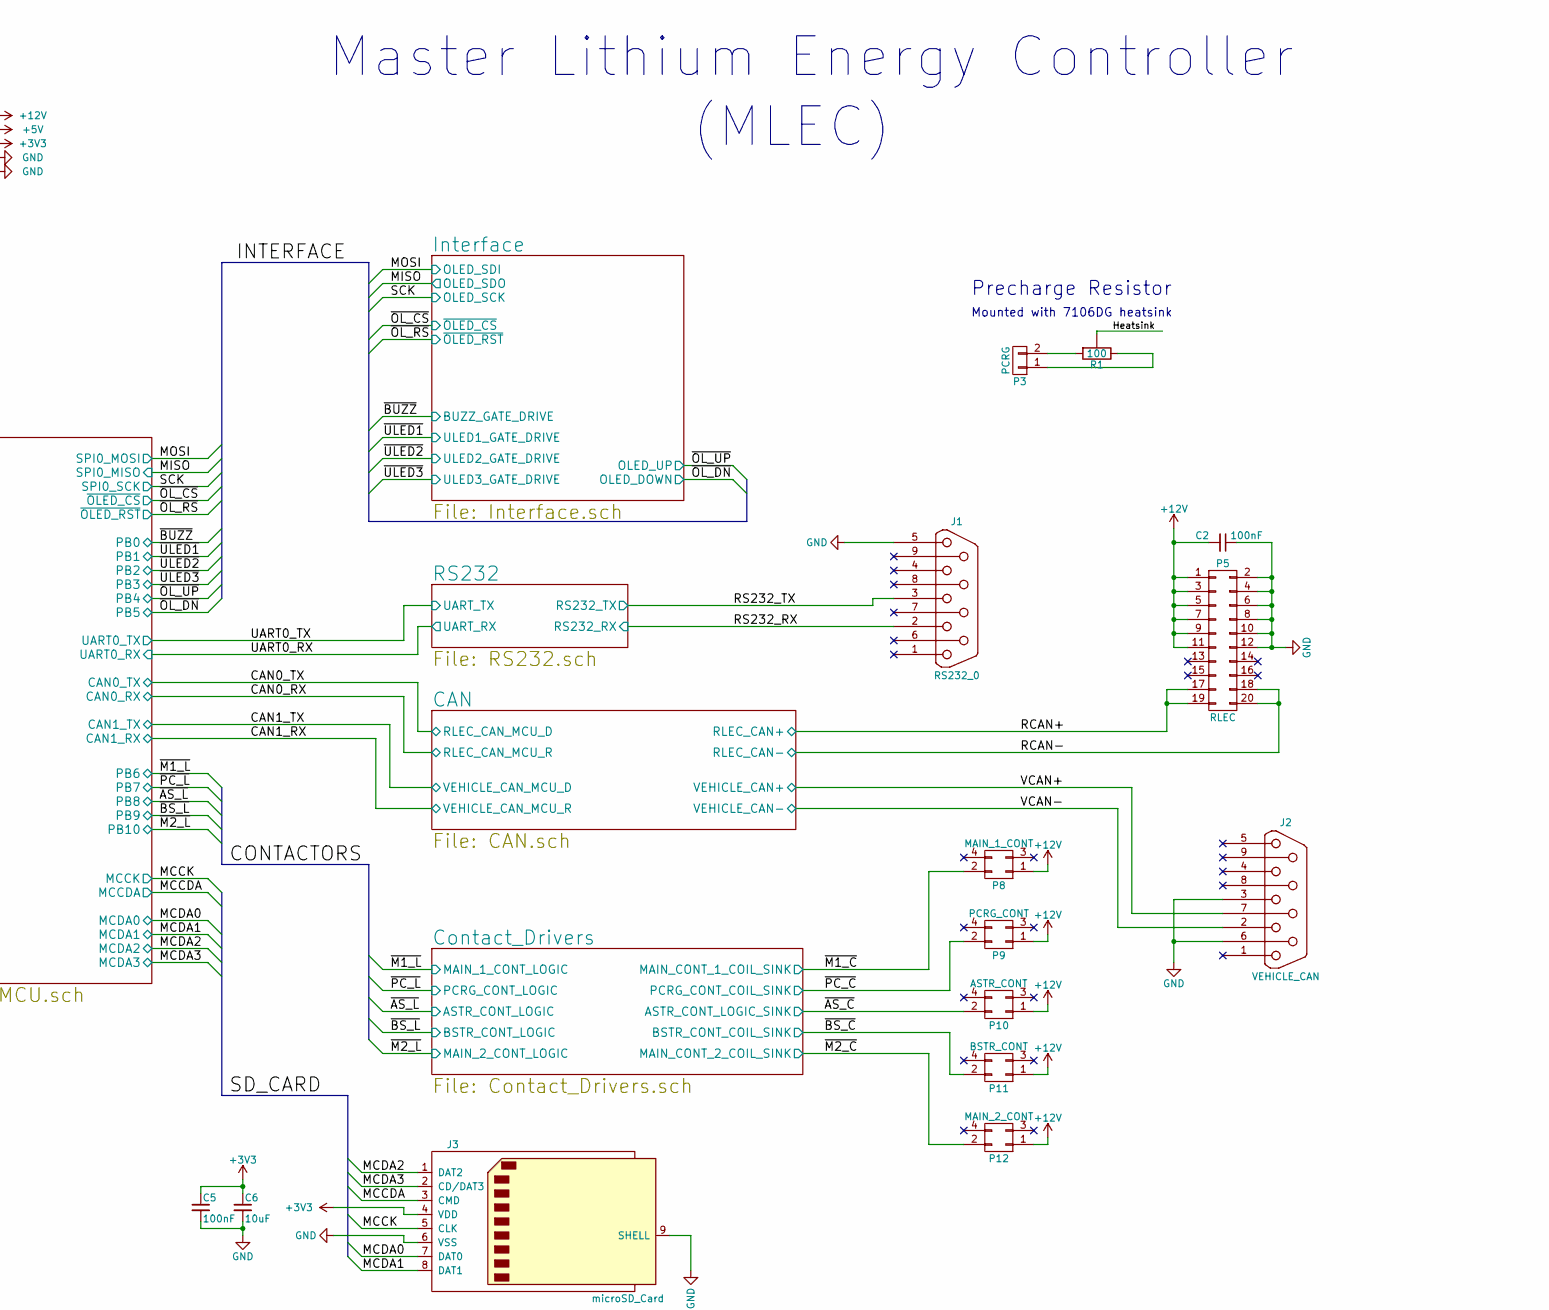
[picture p24: schematic ATSAM_Based_Battery_Management_System.sch, MLEC, part in row 1, column 2]

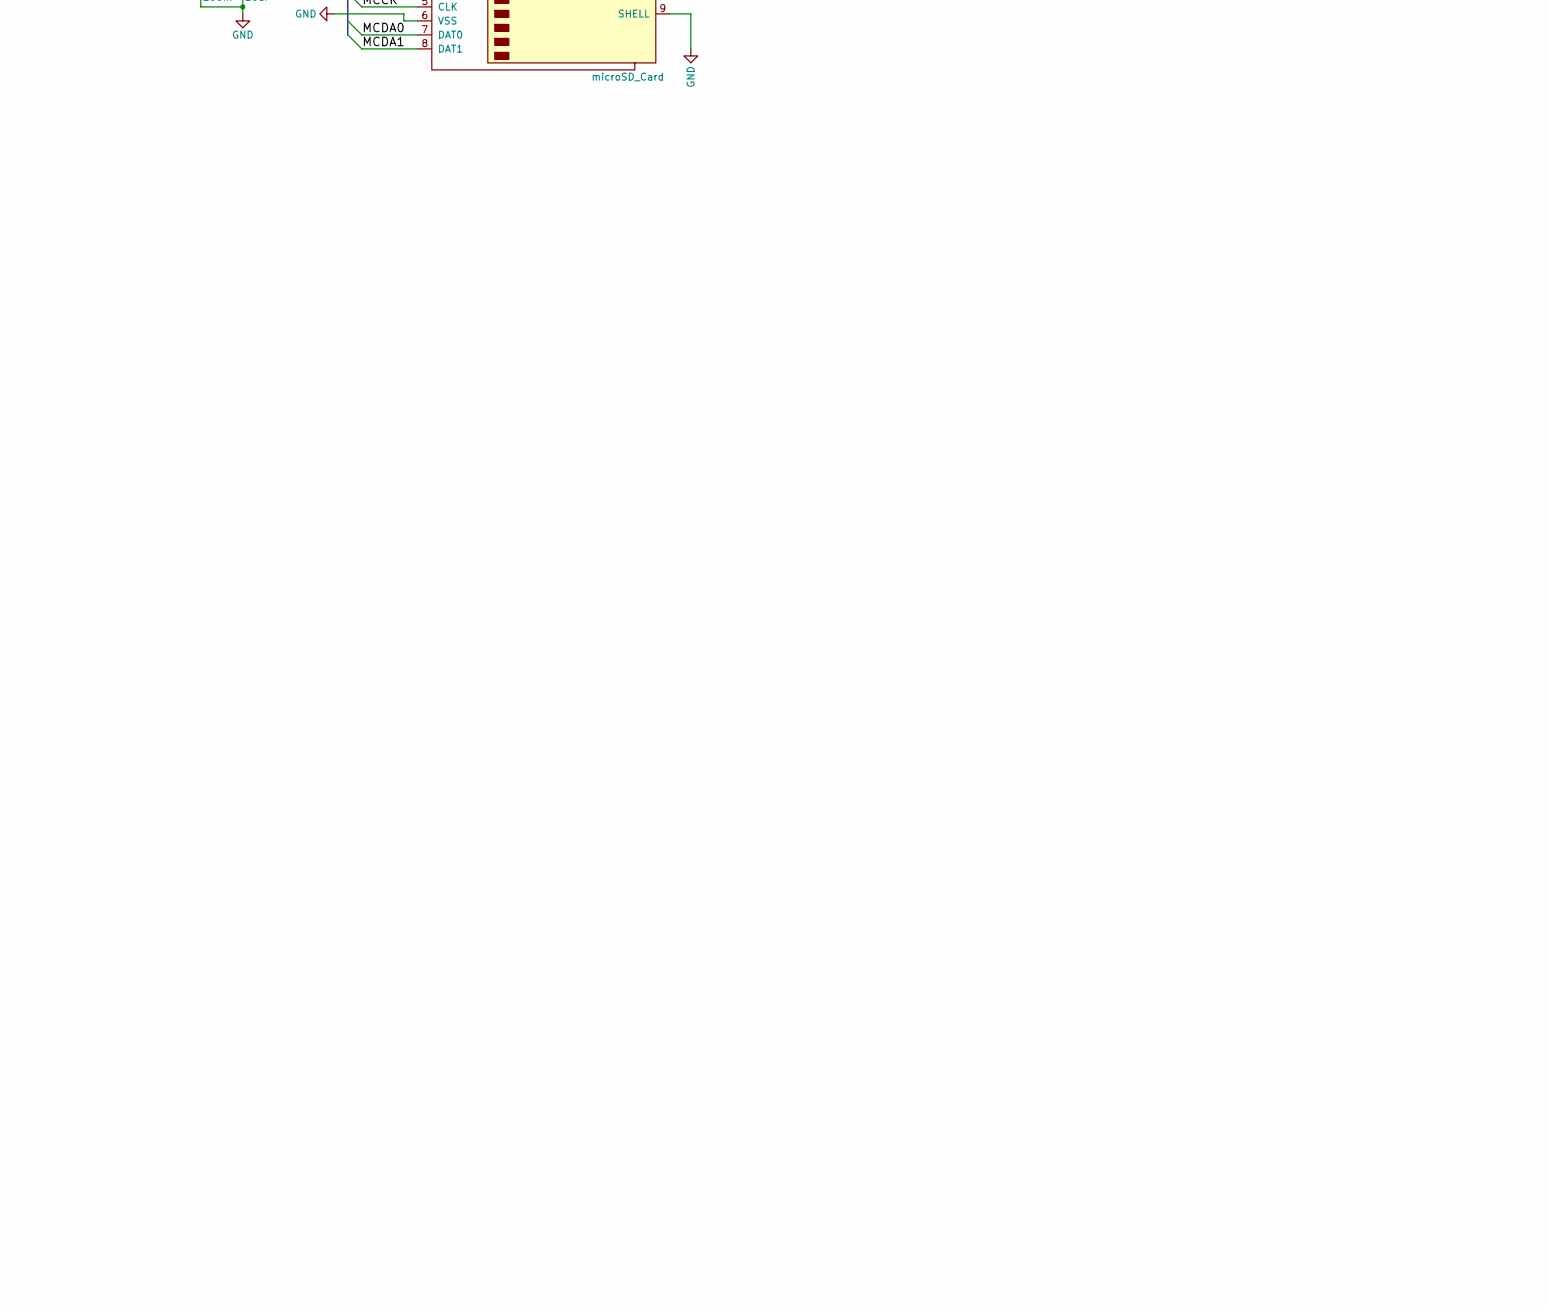
[picture p25: schematic ATSAM_Based_Battery_Management_System.sch, MLEC, part in row 2, column 2]

Parts:
C1: 10nF; C_0603_OUTLINE
C2, C4, C5: 100nF; C_0603_OUTLINE
C6: 10uF; C_0805_OUTLINE
J1: RS232_0; Assmann_DB9_ADX09
J2: VEHICLE_CAN; Assmann_DB9_ADX09
J3: microSD_Card; microsd_socket
P1: 12V_CONN; MiniFit_Angled-4
P2: PWR_JP; Pin_Header_Straight_2x05
P3: PCRG; MiniFit_Angled-2
P4: USB_OTG; conn_usb_B_micro_smd
P5: RLEC; 3M_RightAngle_20pos_N3428-5202RB; mfg# N3428-5202RB
P6: MLEC_DAQ_CONN; Molex_Microfit3_Header_02x07_Angled_43045-140x; Mfg# 0430451401
P7: JTAG; Pin_Header_Straight_2x05_Pitch1.27mm
P8: MAIN_1_CONT; MiniFit_Angled-4; Mfg# 0039301042
P9: PCRG_CONT; MiniFit_Angled-4; Mfg# 0039301042
P10: ASTR_CONT; MiniFit_Angled-4; Mfg# 0039301042
P11: BSTR_CONT; MiniFit_Angled-4; Mfg# 0039301042
P12: MAIN_2_CONT; MiniFit_Angled-4; Mfg# 0039301042
R1: 100; D2PAK-2Lead-7106DG_Heatsink
R2: 0R; R_0603_OUTLINE
SW1: SW_RST; SW_SPST_EVQPE1

Connections:
+5V: P2.3, P2.4, P6.2, P6.3, P6.4; also elsewhere on the board
+12V: C2.2, P2.1, P2.2, P5.1, P5.3, P5.5, P5.7, P5.9, P5.11, P8.1, P9.1, P10.1, P11.1, P12.1; also elsewhere on the board
/CAN/RLEC_CAN+: P5.17, P5.19; also elsewhere on the board
/CAN/RLEC_CAN-: P5.18, P5.20; also elsewhere on the board
/CAN/VEHICLE_CAN+: J2.7; also elsewhere on the board
/CAN/VEHICLE_CAN-: J2.2; also elsewhere on the board
/Contact_Drivers/ASTR_CONT_LOGIC_SINK: P10.2; also elsewhere on the board
/Contact_Drivers/BSTR_CONT_COIL_SINK: P11.2; also elsewhere on the board
/Contact_Drivers/MAIN_CONT_1_COIL_SINK: P8.2; also elsewhere on the board
/Contact_Drivers/MAIN_CONT_2_COIL_SINK: P12.2; also elsewhere on the board
/Contact_Drivers/PCRG_CONT_COIL_SINK: P9.2; also elsewhere on the board
/DAQ/ASTR_2_ANALOG: P6.12; also elsewhere on the board
/DAQ/ASTR_I_RATIO: P6.13; also elsewhere on the board
/DAQ/BSTR_2_ANALOG: P6.11; also elsewhere on the board
/DAQ/BSTR_I_RATIO: P6.14; also elsewhere on the board
/DAQ/INJECT_12V_ISO: P6.1; also elsewhere on the board
/DAQ/LOWSIDE_ANALOG: P6.10; also elsewhere on the board
/DAQ/MAIN1_2_ANALOG: P6.9; also elsewhere on the board
/Heatsink: R1.3
/MCU/MCCDA: J3.3 (CMD); also elsewhere on the board
/MCU/MCCK: J3.5 (CLK); also elsewhere on the board
/MCU/MCDA0: J3.7 (DAT0); also elsewhere on the board
/MCU/MCDA1: J3.8 (DAT1); also elsewhere on the board
/MCU/MCDA2: J3.1 (DAT2); also elsewhere on the board
/MCU/MCDA3: J3.2 (CD/DAT3); also elsewhere on the board
/MCU/TCK: P7.1; also elsewhere on the board
/MCU/TDI: P7.3; also elsewhere on the board
/MCU/TDO: P7.5; also elsewhere on the board
/MCU/TMS: P7.9; also elsewhere on the board
/MCU/UOTGID: R2.1; also elsewhere on the board
/MCU/USBD+: P4.3 (D+); also elsewhere on the board
/MCU/USBD-: P4.2 (D-); also elsewhere on the board
/MCU/VBUS: C1.1, P4.1 (VCC); also elsewhere on the board
/MCU/~NRST: P7.6, SW1.1; also elsewhere on the board
/Power_Supply/VIN: P1.1, P1.2; also elsewhere on the board
/RS232/RS232_RX: J1.2; also elsewhere on the board
/RS232/RS232_TX: J1.3; also elsewhere on the board
/UOTGID_U: P4.4 (ID), R2.2
GND: C1.2, C2.1, C4.2, C5.2, C6.2, J1.5, J2.3, J2.6, J3.6 (VSS), J3.9 (SHELL), P1.3, P1.4, P2.7, P2.8, P2.9, P2.10, P4.5 (GND), P4.6 (shield), P5.2, P5.4, P5.6, P5.8, P5.10, P5.12, P6.5, P6.6, P6.7, P6.8, P7.2, P7.10, SW1.2; also elsewhere on the board
unnamed: P3.1, R1.1
unnamed: P3.2, R1.2
VDDBU: C4.1, C5.1, C6.1, J3.4 (VDD), P2.5, P2.6, P7.4; also elsewhere on the board

Notes on the sheet:
TODO:: - Finished MCU connections - Connect Buzzer & LEDs to micro - Breakout useful unused pins - Allow user to configure different things with simple jumpers - Lookup how to use current sensors & implement them - Implement voltage readings on multiple areas throughout PCB - Implement SD card stor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
Master Lithium Energy Controller
(MLEC)
Precharge Resistor
Mounted with 7106DG heatsink

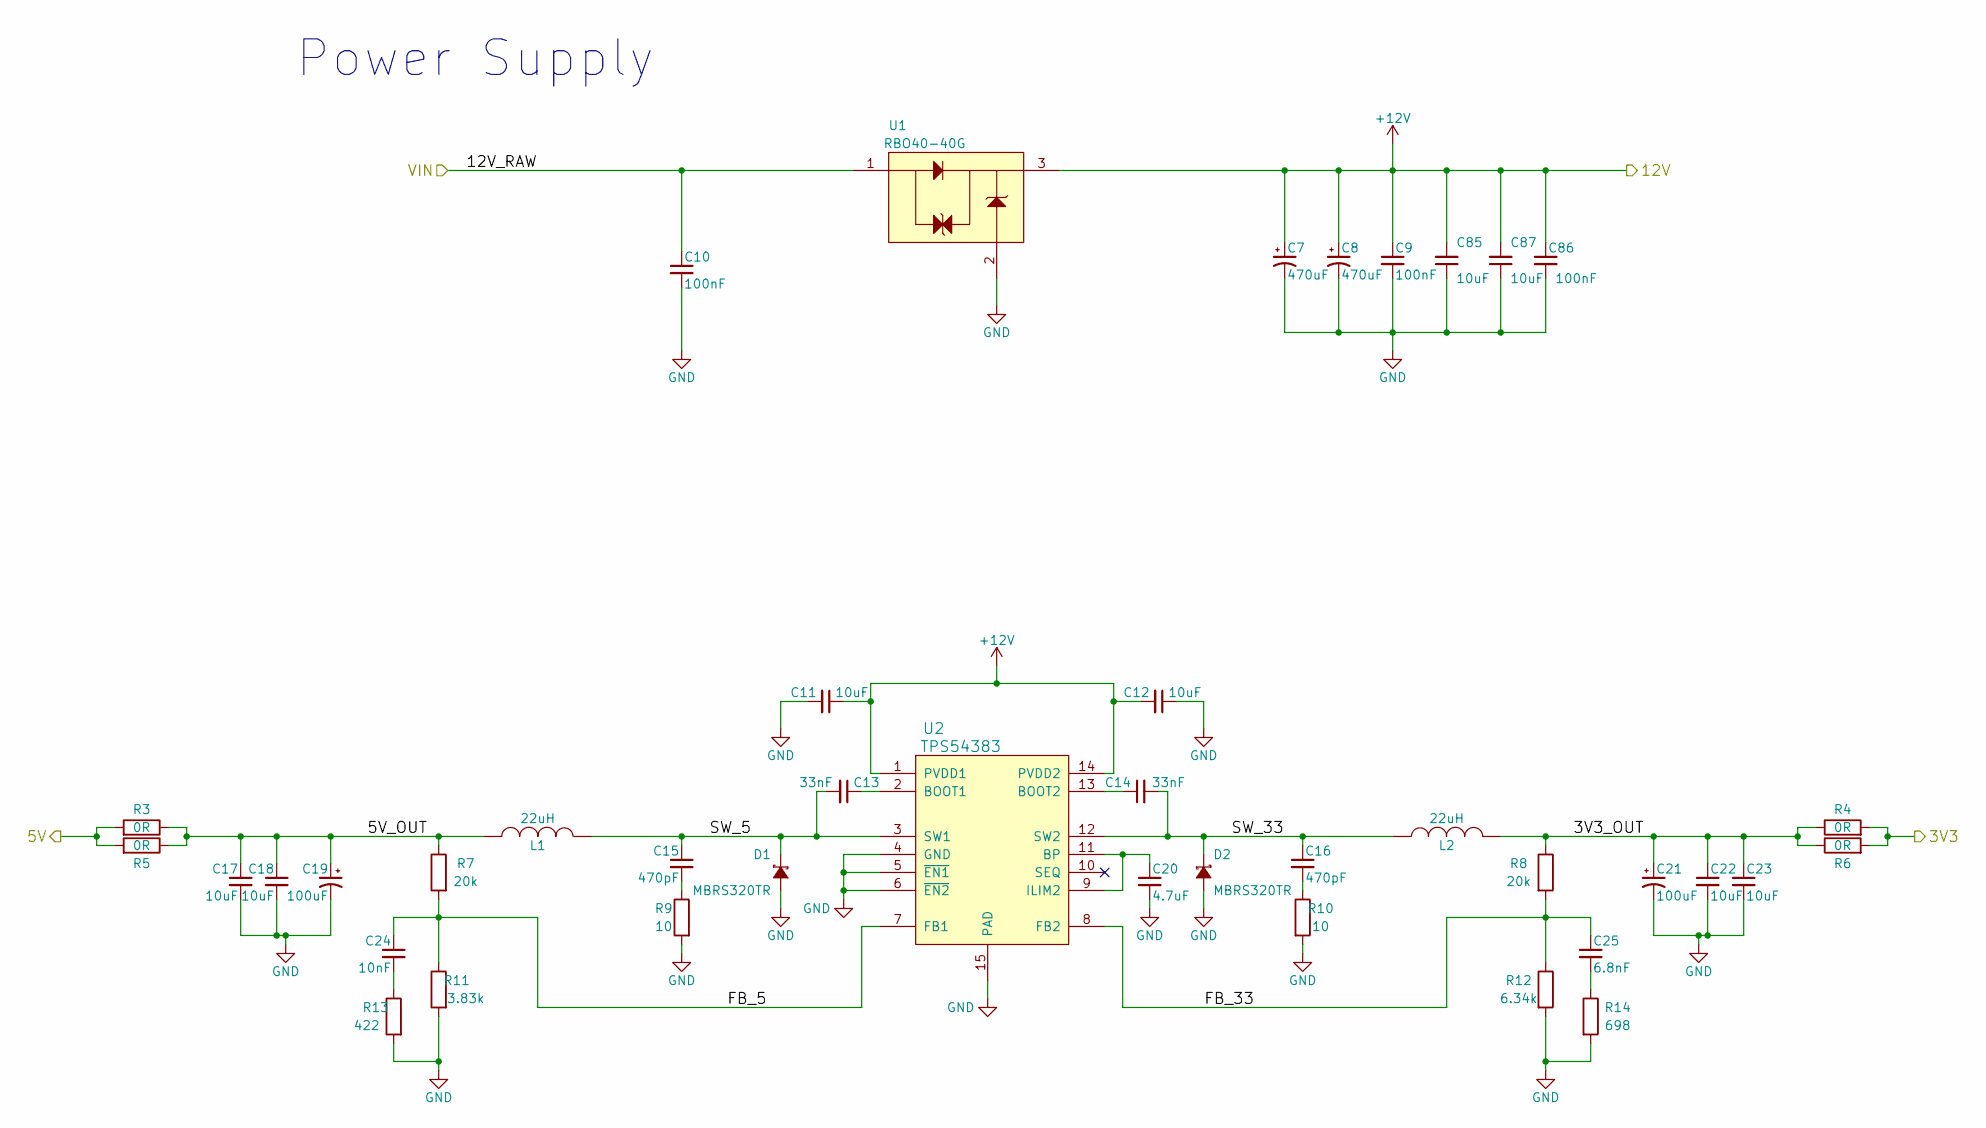
[picture p26: schematic Power_Supply.sch]

Parts:
C7, C8: 470uF; c_elec_10x10.5
C9, C10, C86: 100nF; C_0603_OUTLINE
C11, C12, C85, C87: 10uF; C_1206_OUTLINE; Mfg# C3216X5R1E106M
C13, C14: 33nF; C_0603_OUTLINE
C15, C16: 470pF; C_0603_OUTLINE
C17, C18, C22, C23: 10uF; C_0805_OUTLINE; Mfg# C2012X5R0J106M
C19, C21: 100uF; c_elec_8x6.5; Mfg# EEEFC1A101P
C20: 4.7uF; C_0805_OUTLINE
C24: 10nF; C_0603_OUTLINE
C25: 6.8nF; C_0603_OUTLINE
D1, D2: MBRS320TR; SMC_Standard
L1, L2: 22uH; SELF-WE-PD-XXL; Mfg# MSS1278-153ML
R3, R4, R5, R6: 0R; R_0603_OUTLINE
R7, R8: 20k; R_0603_OUTLINE
R9, R10: 10; R_0603_OUTLINE
R11: 3.83k; R_0603_OUTLINE
R12: 6.34k; R_0603_OUTLINE
R13: 422; R_0603_OUTLINE
R14: 698; R_0603_OUTLINE
U1: RBO40-40G; TO-263-2Lead
U2: TPS54383; HTSSOP-14_4.4x5mm_Pitch0.65mm

Connections:
+5V: R3.2, R5.2; also elsewhere on the board
+12V: C7.1, C8.1, C9.1, C11.1, C12.2, C85.2, C86.1, C87.2, U1.3, U2.1 (PVDD1), U2.14 (PVDD2); also elsewhere on the board
/Power_Supply/3V3_OUT: C21.1, C22.1, C23.1, L2.2, R4.1, R6.1, R8.1
/Power_Supply/5V_OUT: C17.1, C18.1, C19.1, L1.2, R3.1, R5.1, R7.1
/Power_Supply/FB_5: C24.1, R7.2, R11.1, U2.7 (FB1)
/Power_Supply/FB_33: C25.1, R8.2, R12.1, U2.8 (FB2)
/Power_Supply/SW_5: C13.2, C15.1, D1.1 (K), L1.1, U2.3 (SW1)
/Power_Supply/SW_33: C14.2, C16.1, D2.1 (K), L2.1, U2.12 (SW2)
/Power_Supply/VIN: C10.1, U1.1; also elsewhere on the board
GND: C7.2, C8.2, C9.2, C10.2, C11.2, C12.1, C17.2, C18.2, C19.2, C20.2, C21.2, C22.2, C23.2, C85.1, C86.2, C87.1, D1.2 (A), D2.2 (A), R9.2, R10.2, R11.2, R12.2, R13.2, R14.2, U1.2, U2.4 (GND), U2.5 (~EN1), U2.6 (~EN2), U2.15 (PAD); also elsewhere on the board
unnamed: C13.1, U2.2 (BOOT1)
unnamed: C14.1, U2.13 (BOOT2)
unnamed: C15.2, R9.1
unnamed: C16.2, R10.1
unnamed: C20.1, U2.9 (ILIM2), U2.11 (BP)
unnamed: C24.2, R13.1
unnamed: C25.2, R14.1
VDDBU: R4.2, R6.2; also elsewhere on the board

Notes on the sheet:
Power Supply

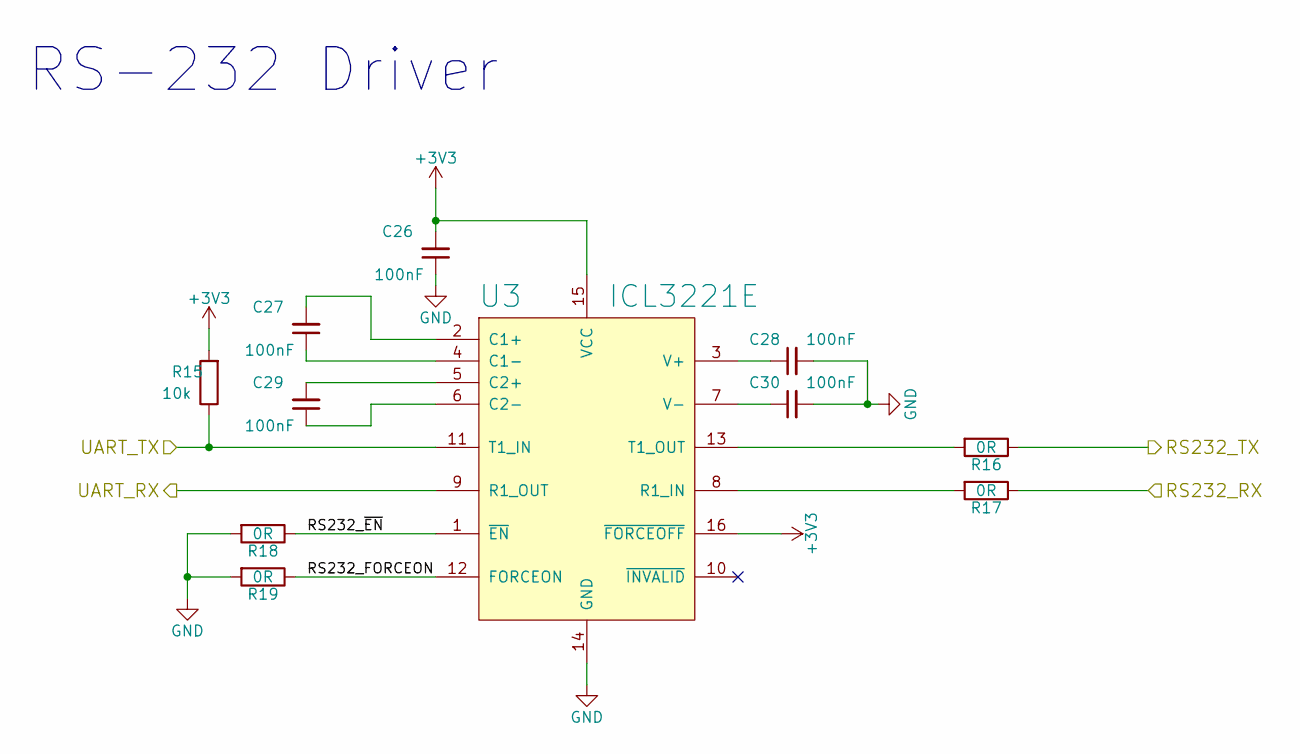
[picture p27: schematic RS232.sch]

Parts:
C26, C27, C28, C29, C30: 100nF; C_0603_OUTLINE
R15: 10k; R_0603_OUTLINE
R16, R17, R18, R19: 0R; R_0603_OUTLINE
U3: ICL3221E; TSSOP-16_4.4x5mm_Pitch0.65mm

Connections:
/MCU/UART0_RX: U3.9 (R1_OUT); also elsewhere on the board
/MCU/UART0_TX: R15.1, U3.11 (T1_IN); also elsewhere on the board
/RS232/RS232_FORCEON: R19.1, U3.12 (FORCEON)
/RS232/RS232_RX: R17.1; also elsewhere on the board
/RS232/RS232_TX: R16.1; also elsewhere on the board
/RS232/RS232_~EN: R18.1, U3.1 (~EN)
GND: C26.1, C28.2, C30.2, R18.2, R19.2, U3.14 (GND); also elsewhere on the board
unnamed: C27.1, U3.4 (C1-)
unnamed: C27.2, U3.2 (C1+)
unnamed: C28.1, U3.3 (V+)
unnamed: C29.1, U3.6 (C2-)
unnamed: C29.2, U3.5 (C2+)
unnamed: C30.1, U3.7 (V-)
unnamed: R16.2, U3.13 (T1_OUT)
unnamed: R17.2, U3.8 (R1_IN)
VDDBU: C26.2, R15.2, U3.15 (VCC), U3.16 (~FORCEOFF); also elsewhere on the board

Notes on the sheet:
RS-232 Driver

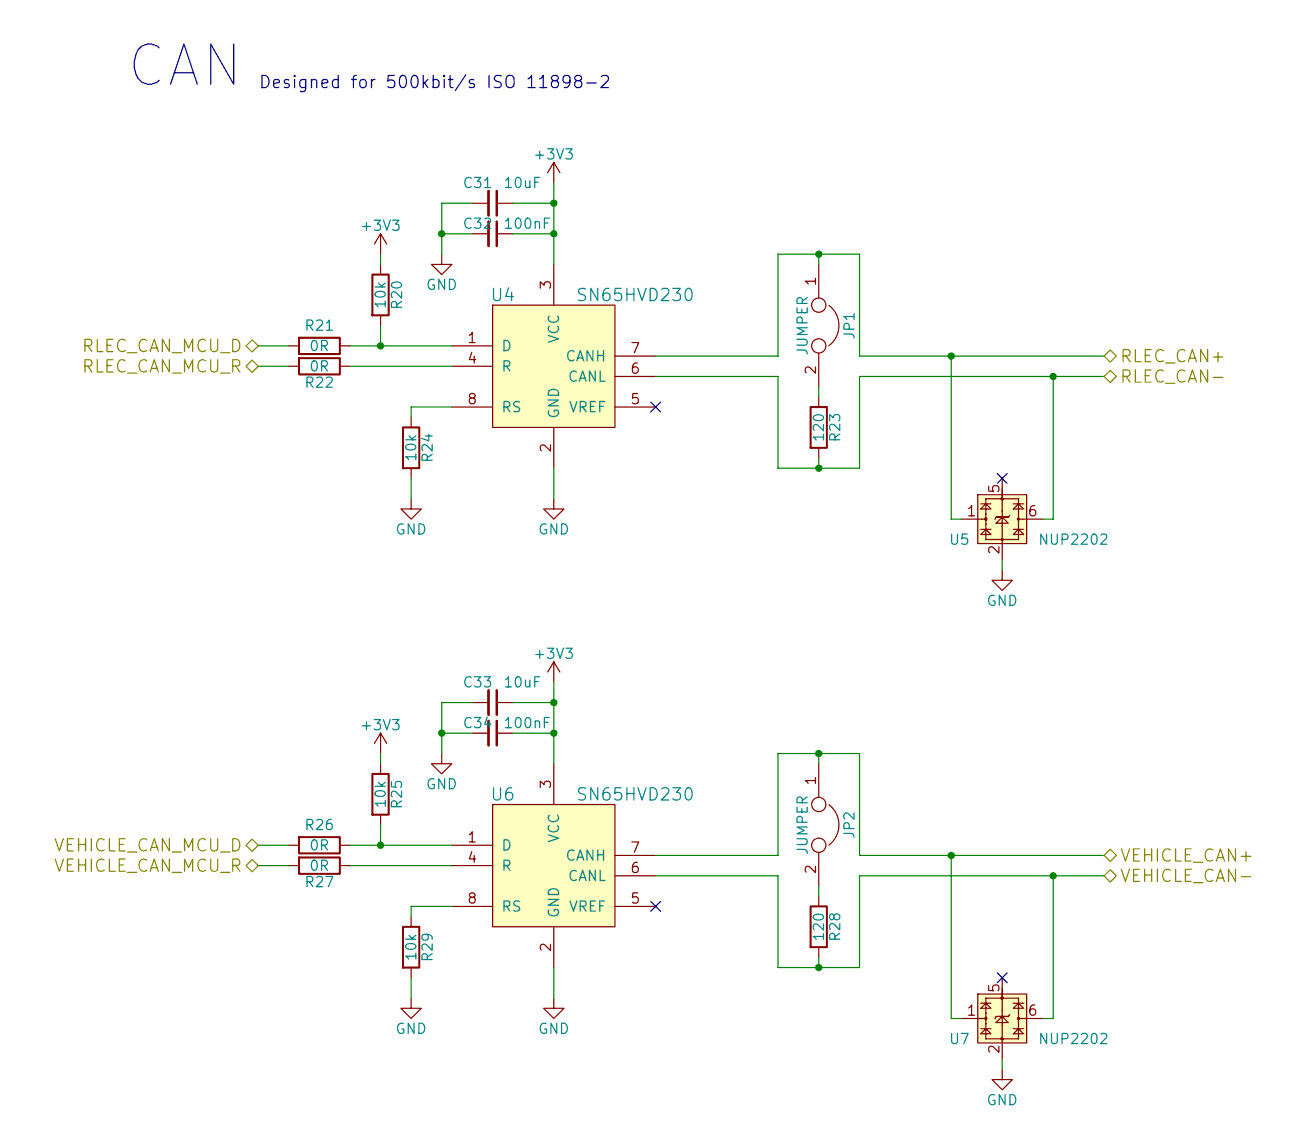
[picture p28: schematic CAN.sch]

Parts:
C31: 10uF; C_0805_OUTLINE
C32, C34: 100nF; C_0603_OUTLINE
C33: 10uF; C_0603_OUTLINE
JP1, JP2: JUMPER; Pin_Header_Straight_1x02
R20, R24, R25, R29: 10k; R_0603_OUTLINE
R21, R22, R26, R27: 0R; R_0603_OUTLINE
R23, R28: 120; R_1206_OUTLINE
U4, U6: SN65HVD230; SOIC-8_3.9x4.9mm_Pitch1.27mm
U5, U7: NUP2202; SC-70-6

Connections:
/CAN/RLEC_CAN+: JP1.1, U4.7 (CANH), U5.1; also elsewhere on the board
/CAN/RLEC_CAN-: R23.2, U4.6 (CANL), U5.6; also elsewhere on the board
/CAN/VEHICLE_CAN+: JP2.1, U6.7 (CANH), U7.1; also elsewhere on the board
/CAN/VEHICLE_CAN-: R28.2, U6.6 (CANL), U7.6; also elsewhere on the board
/MCU/CAN0_RX: R22.2; also elsewhere on the board
/MCU/CAN0_TX: R21.2; also elsewhere on the board
/MCU/CAN1_RX: R27.2; also elsewhere on the board
/MCU/CAN1_TX: R26.2; also elsewhere on the board
GND: C31.2, C32.2, C33.2, C34.2, R24.2, R29.2, U4.2 (GND), U5.2, U6.2 (GND), U7.2; also elsewhere on the board
unnamed: JP1.2, R23.1
unnamed: JP2.2, R28.1
unnamed: R20.2, R21.1, U4.1 (D)
unnamed: R22.1, U4.4 (R)
unnamed: R24.1, U4.8 (RS)
unnamed: R25.2, R26.1, U6.1 (D)
unnamed: R27.1, U6.4 (R)
unnamed: R29.1, U6.8 (RS)
VDDBU: C31.1, C32.1, C33.1, C34.1, R20.1, R25.1, U4.3 (VCC), U6.3 (VCC); also elsewhere on the board

Notes on the sheet:
CAN
Designed for 500kbit/s ISO 11898−2

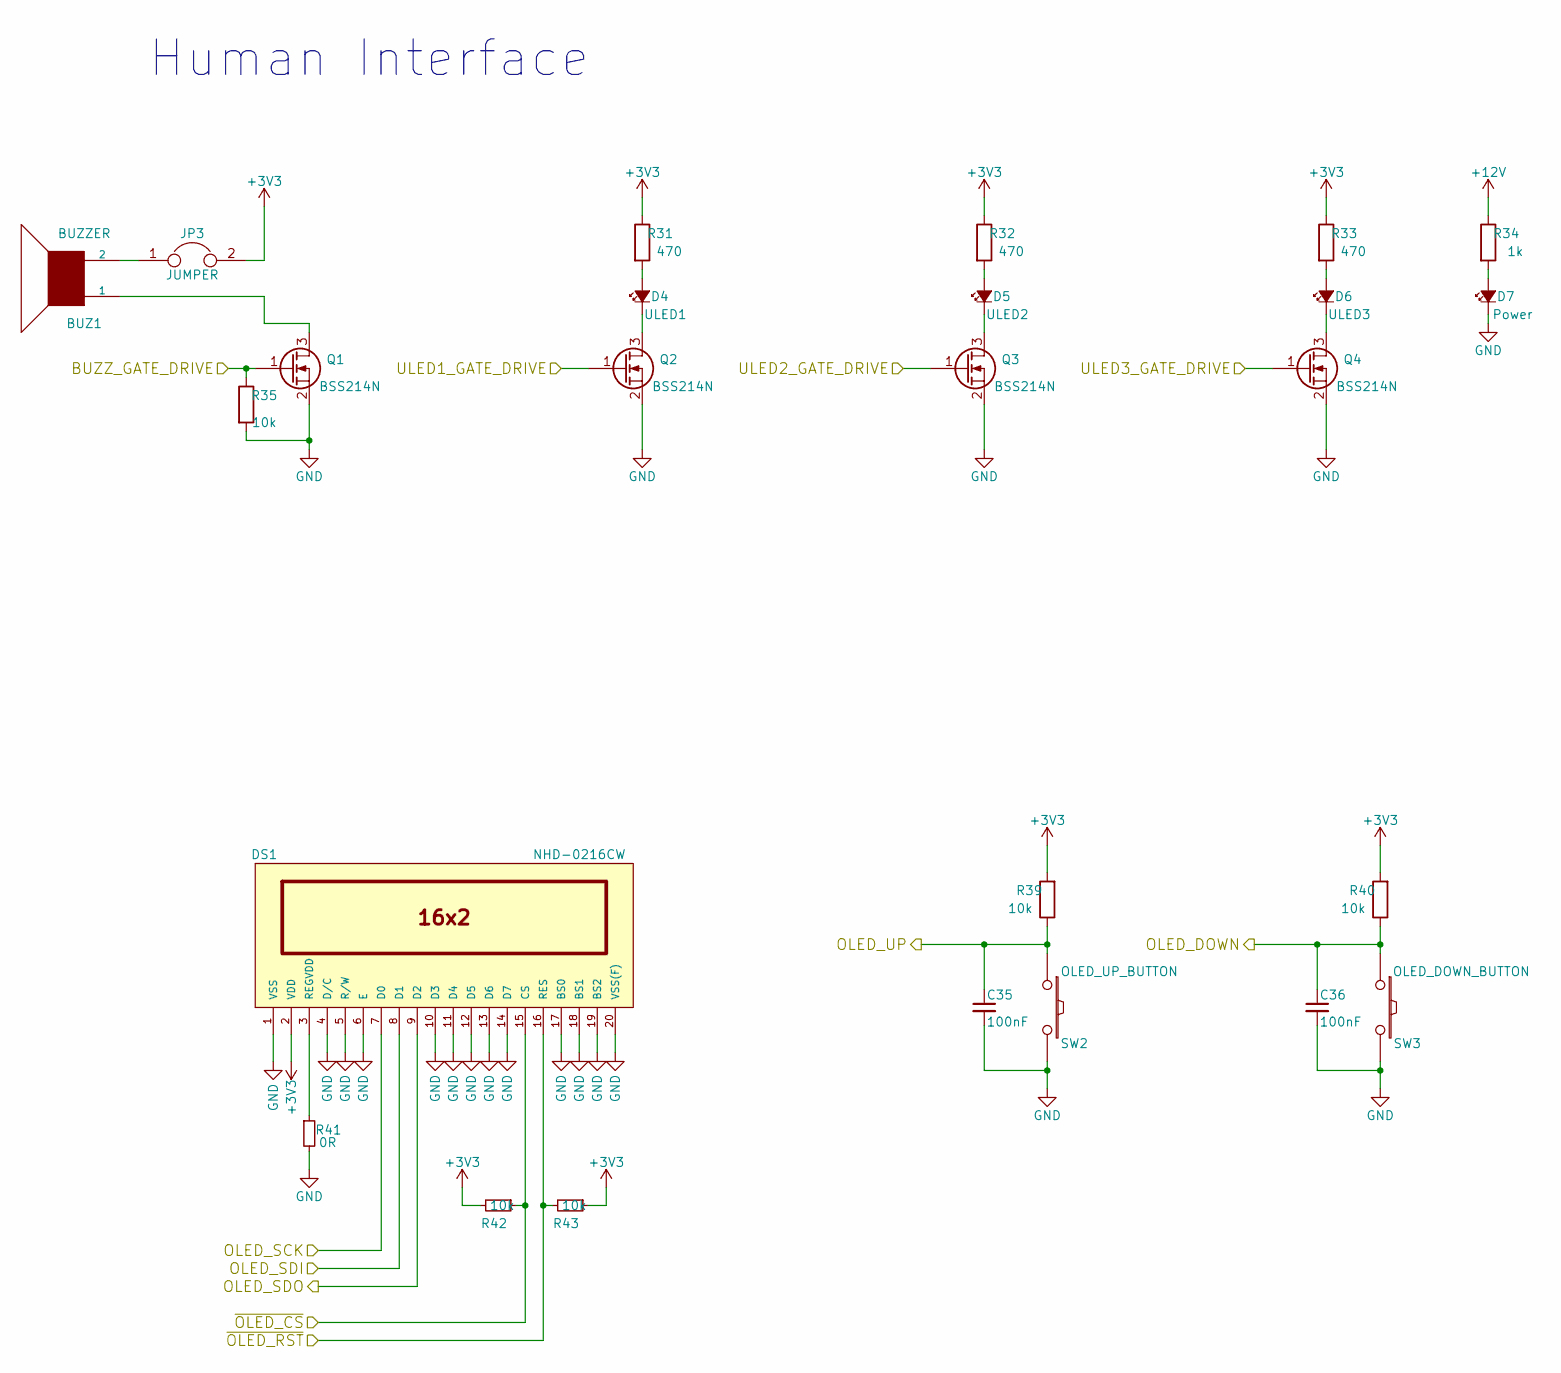
[picture p29: schematic Interface.sch]

Parts:
BUZ1: BUZZER; SMI-1324-TW-3V-R
C35, C36: 100nF; C_0603_OUTLINE
D4: ULED1; LED_0805_OUTLINE
D5: ULED2; LED_0805_OUTLINE
D6: ULED3; LED_0805_OUTLINE
D7: Power; LED_0805_OUTLINE
DS1: NHD-0216CW; NHD_OLED_2x16
JP3: JUMPER; Pin_Header_Straight_1x02
Q1, Q2, Q3, Q4: BSS214N; SOT-23
R31, R32, R33: 470; R_0603_OUTLINE
R34: 1k; R_0603_OUTLINE
R35, R39, R40, R42, R43: 10k; R_0603_OUTLINE
R41: 0R; R_0603_OUTLINE
SW2: OLED_UP_BUTTON; SW_SPST_EVQPE1
SW3: OLED_DOWN_BUTTON; SW_SPST_EVQPE1

Connections:
+12V: R34.1; also elsewhere on the board
/Interface/BUZZ_GATE_DRIVE: Q1.1 (G), R35.1; also elsewhere on the board
/Interface/OLED_DOWN: C36.1, R40.1, SW3.1; also elsewhere on the board
/Interface/OLED_SCK: DS1.7 (D0); also elsewhere on the board
/Interface/OLED_SDI: DS1.8 (D1); also elsewhere on the board
/Interface/OLED_SDO: DS1.9 (D2); also elsewhere on the board
/Interface/OLED_UP: C35.1, R39.1, SW2.1; also elsewhere on the board
/Interface/~OLED_CS: DS1.15 (CS), R42.1; also elsewhere on the board
/Interface/~OLED_RST: DS1.16 (RES), R43.2; also elsewhere on the board
/MCU/PB1: Q2.1 (G); also elsewhere on the board
/MCU/PB2: Q3.1 (G); also elsewhere on the board
/MCU/PB3: Q4.1 (G); also elsewhere on the board
GND: C35.2, C36.2, D7.1 (K), DS1.1 (VSS), DS1.4 (D/C), DS1.5 (R/W), DS1.6 (E), DS1.10 (D3), DS1.11 (D4), DS1.12 (D5), DS1.13 (D6), DS1.14 (D7), DS1.17 (BS0), DS1.18 (BS1), DS1.19 (BS2), DS1.20 (VSS(F)), Q1.2 (S), Q2.2 (S), Q3.2 (S), Q4.2 (S), R35.2, R41.2, SW2.2, SW3.2; also elsewhere on the board
unnamed: BUZ1.1, Q1.3 (D)
unnamed: BUZ1.2, JP3.1
unnamed: D4.1 (K), Q2.3 (D)
unnamed: D4.2 (A), R31.2
unnamed: D5.1 (K), Q3.3 (D)
unnamed: D5.2 (A), R32.2
unnamed: D6.1 (K), Q4.3 (D)
unnamed: D6.2 (A), R33.2
unnamed: D7.2 (A), R34.2
unnamed: DS1.3 (REGVDD), R41.1
VDDBU: DS1.2 (VDD), JP3.2, R31.1, R32.1, R33.1, R39.2, R40.2, R42.2, R43.1; also elsewhere on the board

Notes on the sheet:
Human Interface

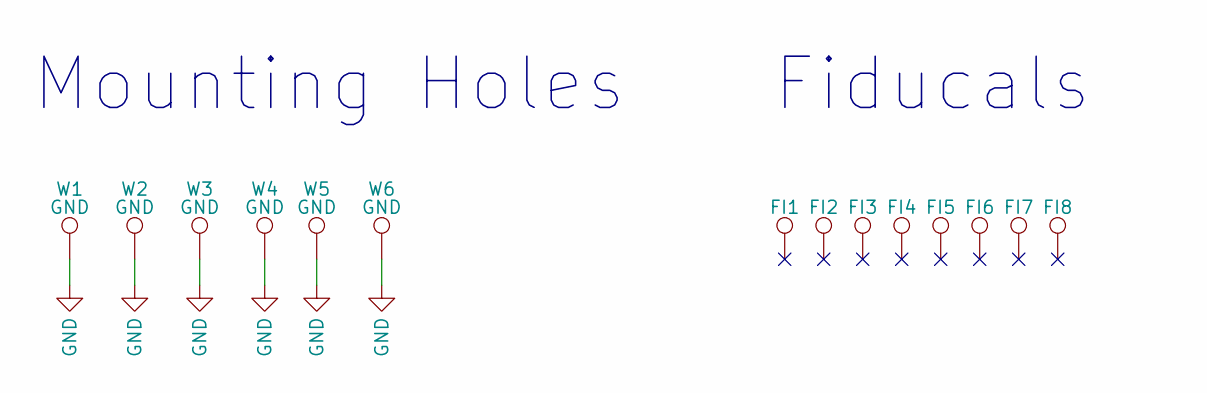
[picture p30: schematic MISC.sch]

Parts:
FI1, FI2, FI3, FI4, FI5, FI6, FI7, FI8: Fiducal; Fiducial_1mm_Dia_2.54mm_Outer_CopperTop
W1, W2, W3, W4, W5, W6: GND; MountingHole_3.2mm_M3_Pad_Via

Connections:
GND: W1.1, W2.1, W3.1, W4.1, W5.1, W6.1; also elsewhere on the board

Notes on the sheet:
Mounting Holes
Fiducals
