jfri2/Purdue_MLEC/Hardware/KiCAD/ATSAM_Based_Battery_Management_System.kicad_pcb

## KiCad design Hardware/KiCAD/ATSAM_Based_Battery_Management_System.kicad_pcb (continued)

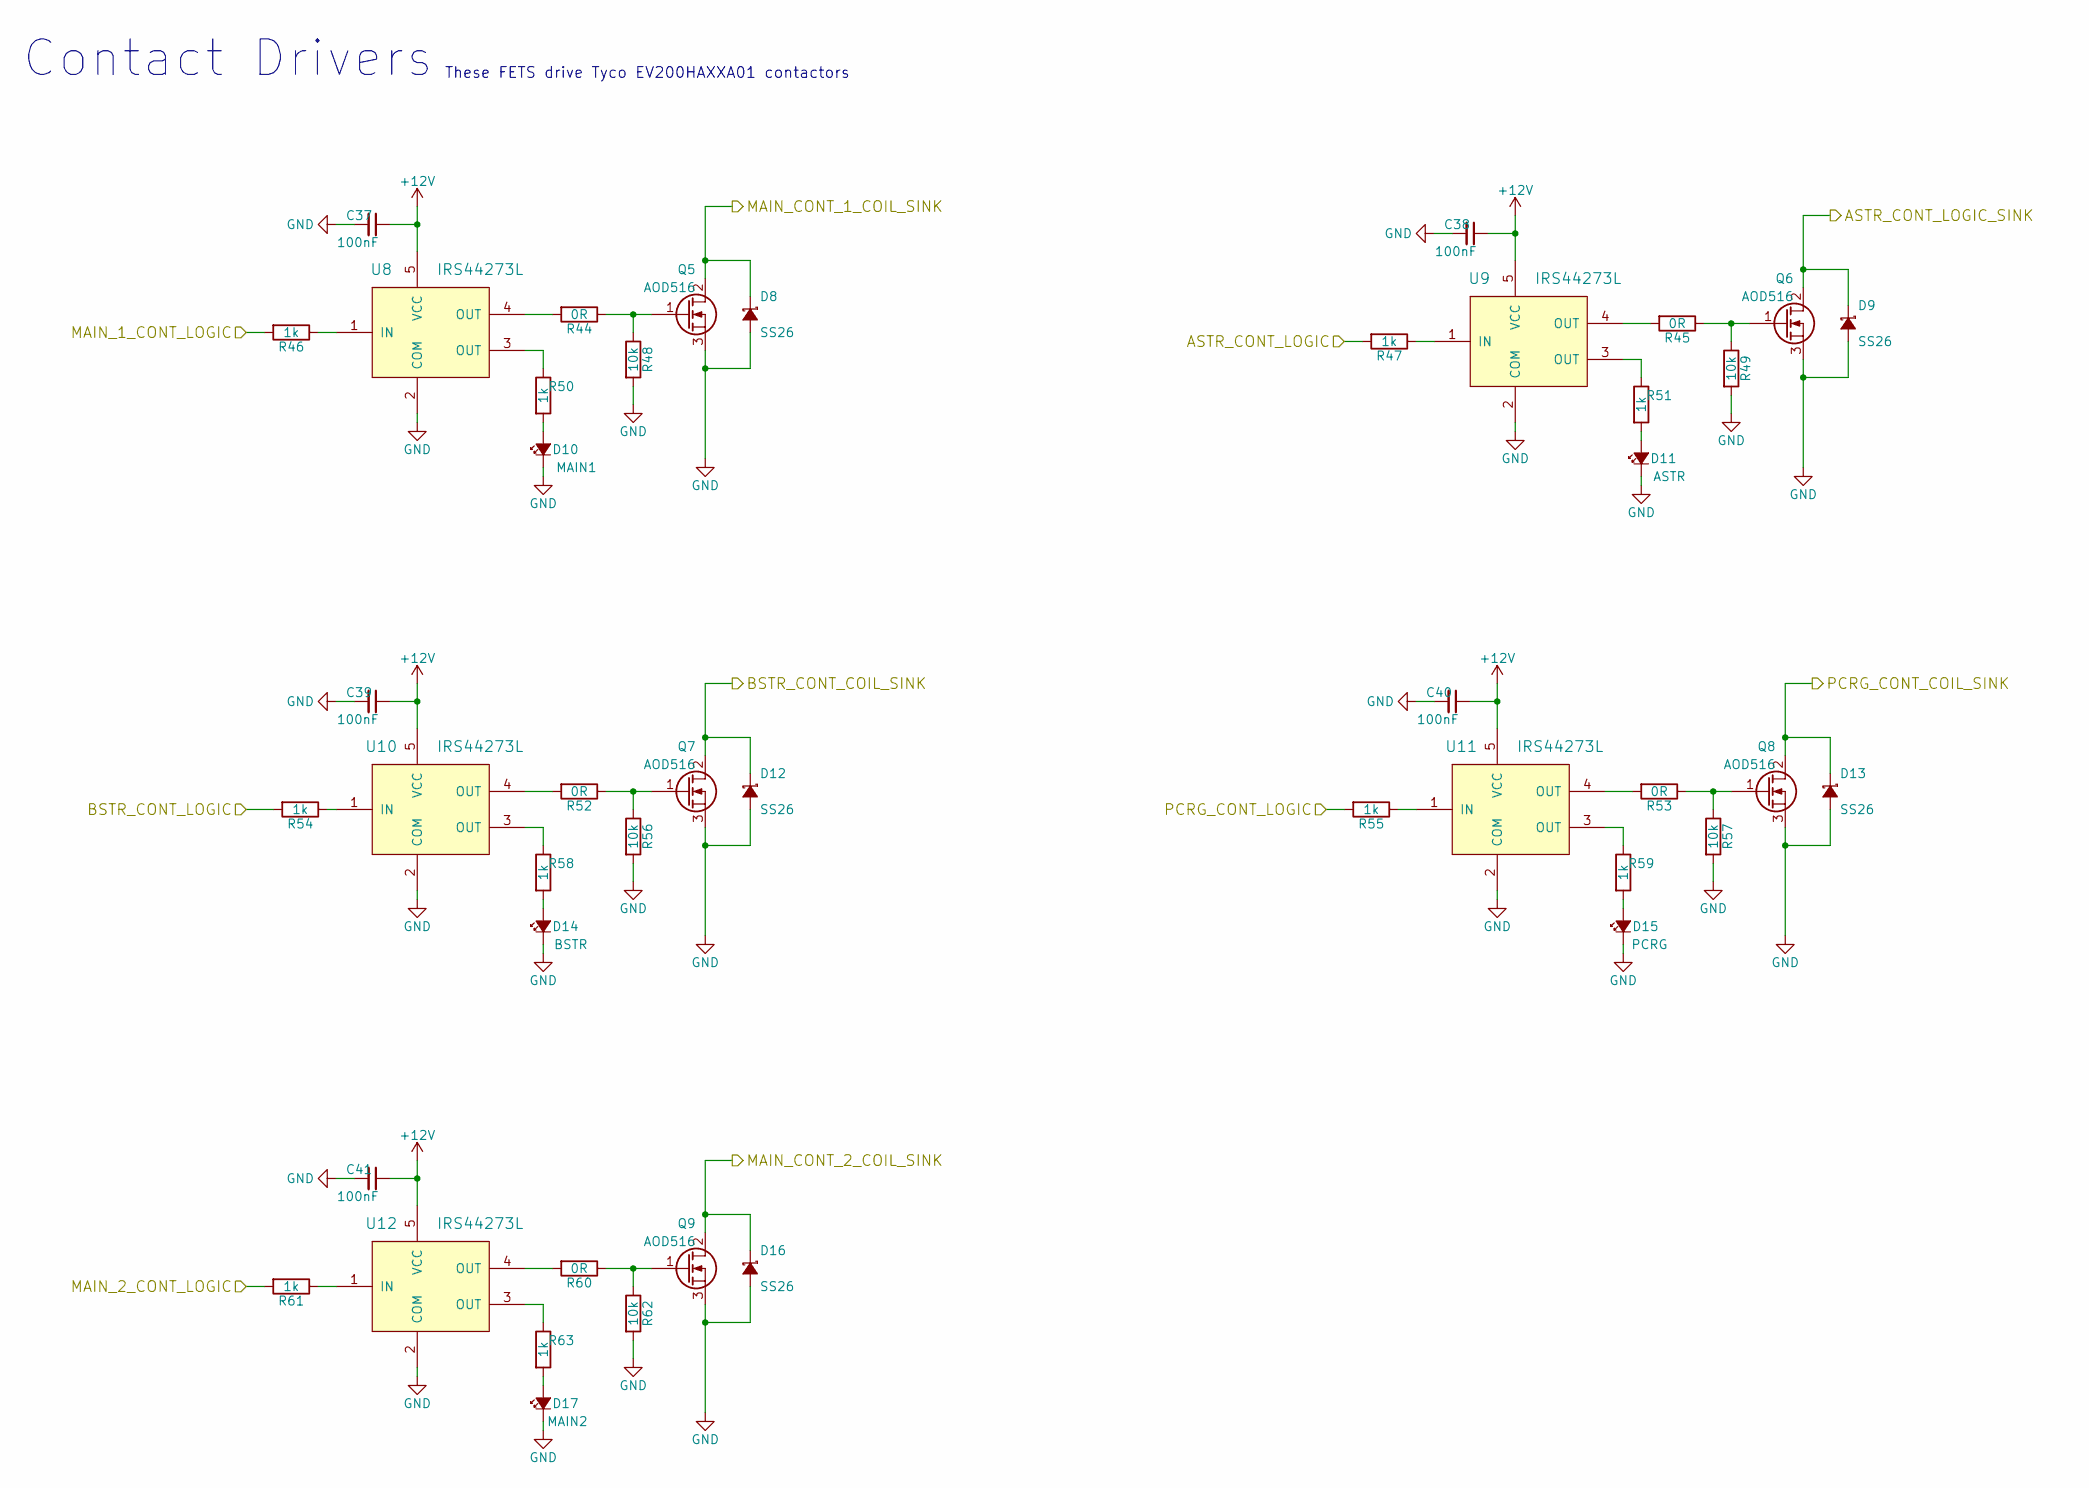
[picture p31: schematic Contact_Drivers.sch]

Parts:
C37, C38, C39, C40, C41: 100nF; C_0603_OUTLINE
D8, D9, D12, D13, D16: SS26; SMB_Standard
D10: MAIN1; LED_0805
D11: ASTR; LED_0805
D14: BSTR; LED_0805
D15: PCRG; LED_0805
D17: MAIN2; LED_0805
Q5, Q6, Q7, Q8, Q9: AOD516; TO-252-2Lead
R44, R45, R52, R53, R60: 0R; R_0603_OUTLINE
R46, R47, R50, R51, R54, R55, R58, R59, R61, R63: 1k; R_0603_OUTLINE
R48, R49, R56, R57, R62: 10k; R_0603_OUTLINE
U8, U9, U10, U11, U12: IRS44273L; SOT-23-5

Connections:
+12V: C37.1, C38.1, C39.1, C40.1, C41.1, U8.5 (VCC), U9.5 (VCC), U10.5 (VCC), U11.5 (VCC), U12.5 (VCC); also elsewhere on the board
/Contact_Drivers/ASTR_CONT_LOGIC: R47.2; also elsewhere on the board
/Contact_Drivers/ASTR_CONT_LOGIC_SINK: D9.1 (K), Q6.2 (D); also elsewhere on the board
/Contact_Drivers/BSTR_CONT_COIL_SINK: D12.1 (K), Q7.2 (D); also elsewhere on the board
/Contact_Drivers/BSTR_CONT_LOGIC: R54.2; also elsewhere on the board
/Contact_Drivers/MAIN_1_CONT_LOGIC: R46.2; also elsewhere on the board
/Contact_Drivers/MAIN_2_CONT_LOGIC: R61.2; also elsewhere on the board
/Contact_Drivers/MAIN_CONT_1_COIL_SINK: D8.1 (K), Q5.2 (D); also elsewhere on the board
/Contact_Drivers/MAIN_CONT_2_COIL_SINK: D16.1 (K), Q9.2 (D); also elsewhere on the board
/Contact_Drivers/PCRG_CONT_COIL_SINK: D13.1 (K), Q8.2 (D); also elsewhere on the board
/MCU/PB7: R55.2; also elsewhere on the board
GND: C37.2, C38.2, C39.2, C40.2, C41.2, D8.2 (A), D9.2 (A), D10.1 (K), D11.1 (K), D12.2 (A), D13.2 (A), D14.1 (K), D15.1 (K), D16.2 (A), D17.1 (K), Q5.3 (S), Q6.3 (S), Q7.3 (S), Q8.3 (S), Q9.3 (S), R48.2, R49.2, R56.2, R57.2, R62.2, U8.2 (COM), U9.2 (COM), U10.2 (COM), U11.2 (COM), U12.2 (COM); also elsewhere on the board
unnamed: D10.2 (A), R50.2
unnamed: D11.2 (A), R51.2
unnamed: D14.2 (A), R58.2
unnamed: D15.2 (A), R59.2
unnamed: D17.2 (A), R63.2
unnamed: Q5.1 (G), R44.1, R48.1
unnamed: Q6.1 (G), R45.1, R49.1
unnamed: Q7.1 (G), R52.1, R56.1
unnamed: Q8.1 (G), R53.1, R57.1
unnamed: Q9.1 (G), R60.1, R62.1
unnamed: R44.2, U8.4 (OUT)
unnamed: R45.2, U9.4 (OUT)
unnamed: R46.1, U8.1 (IN)
unnamed: R47.1, U9.1 (IN)
unnamed: R50.1, U8.3 (OUT)
unnamed: R51.1, U9.3 (OUT)
unnamed: R52.2, U10.4 (OUT)
unnamed: R53.2, U11.4 (OUT)
unnamed: R54.1, U10.1 (IN)
unnamed: R55.1, U11.1 (IN)
unnamed: R58.1, U10.3 (OUT)
unnamed: R59.1, U11.3 (OUT)
unnamed: R60.2, U12.4 (OUT)
unnamed: R61.1, U12.1 (IN)
unnamed: R63.1, U12.3 (OUT)

Notes on the sheet:
These FETS drive Tyco EV200HAXXA01 contactors
Contact Drivers

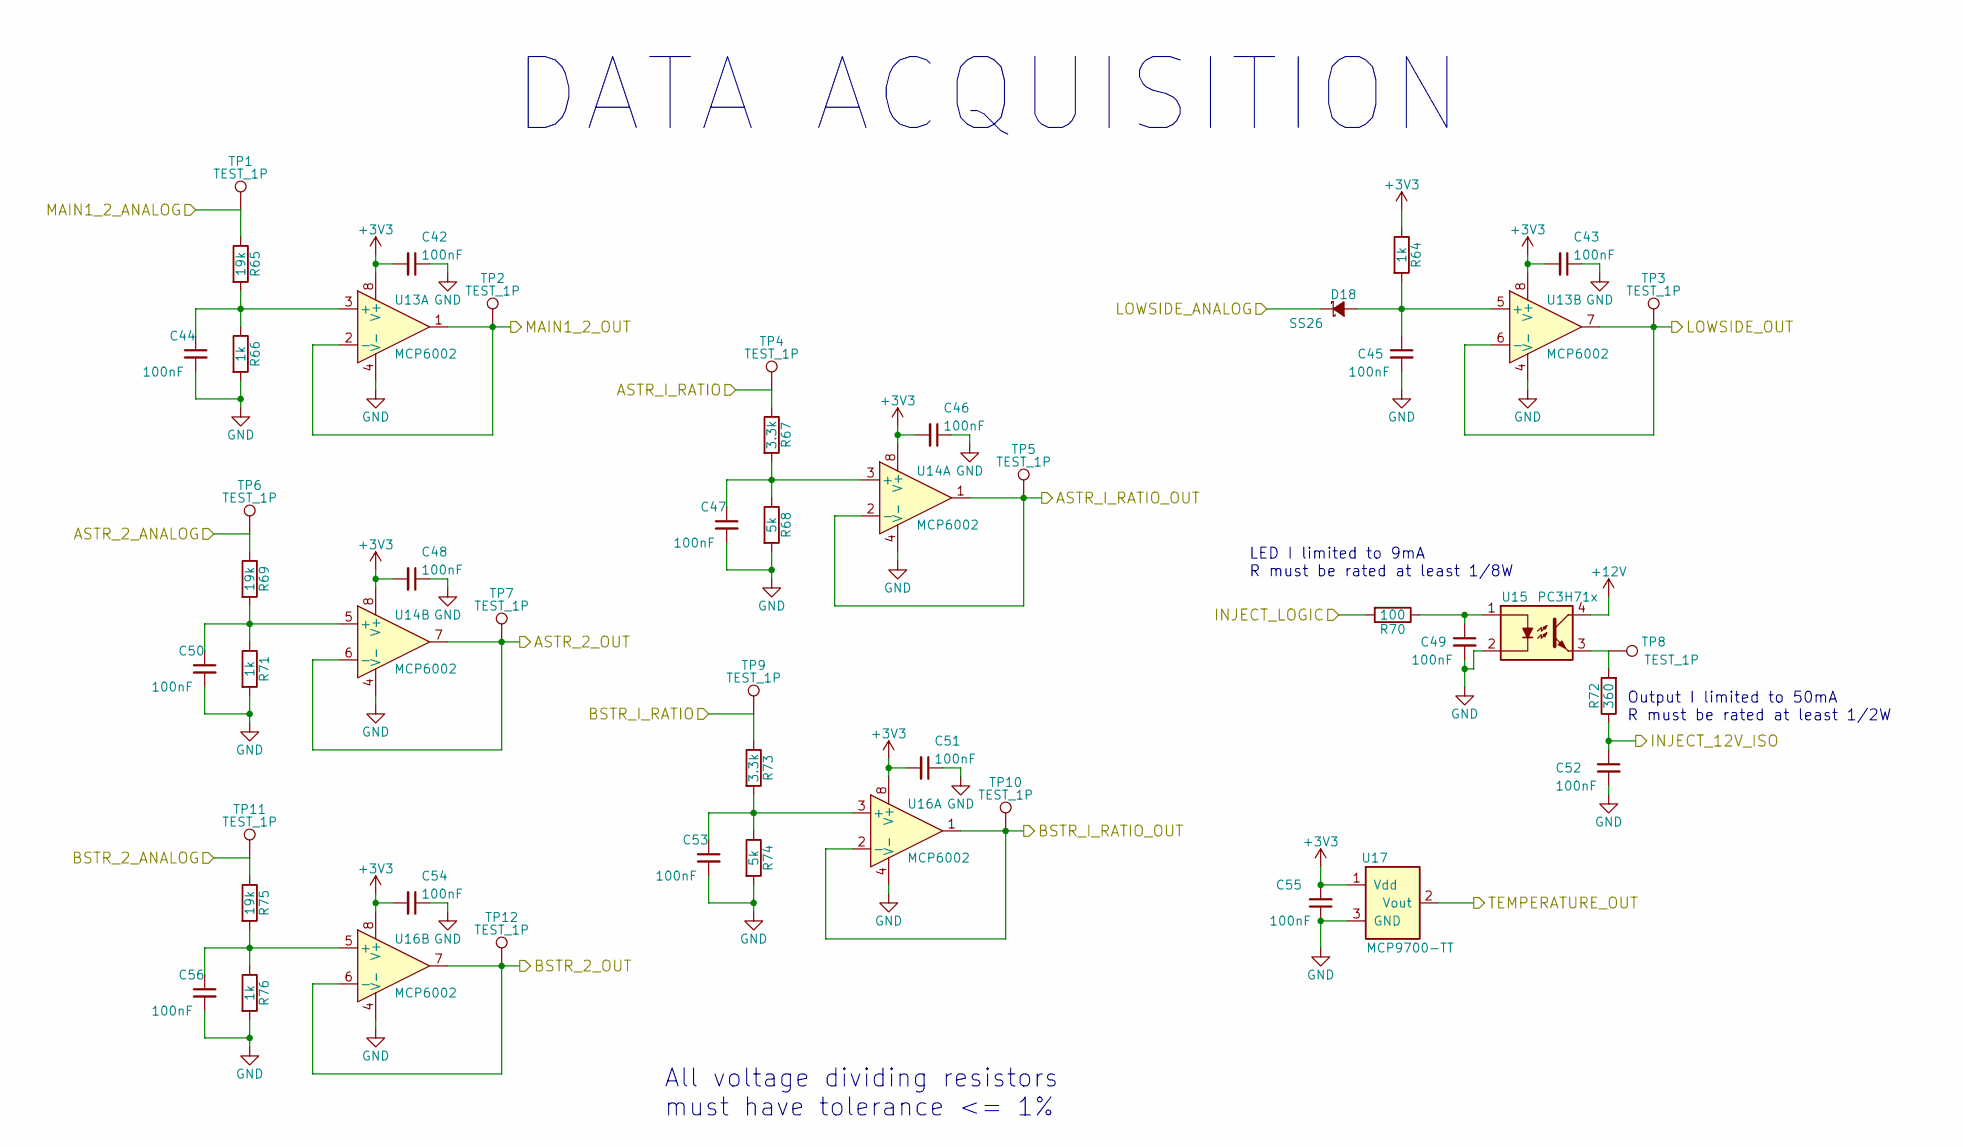
[picture p32: schematic DAQ.sch]

Parts:
C42, C43, C44, C45, C46, C47, C48, C49, C50, C51, C52, C53, C54, C55, C56: 100nF; C_0603_OUTLINE
D18: SS26; SMB_Standard
R64, R66, R71, R76: 1k; R_0603_OUTLINE
R65, R69, R75: 19k; R_0603_OUTLINE
R67, R73: 3.3k; R_0603_OUTLINE
R68, R74: 5k; R_0603_OUTLINE
R70: 100; R_0603_OUTLINE
R72: 360; R_1206_OUTLINE
TP1, TP2, TP3, TP4, TP5, TP6, TP7, TP8, TP9, TP10, TP11, TP12: TEST_1P
U13, U14, U16: MCP6002; SOIC-8_3.9x4.9mm_Pitch1.27mm
U15: PC3H71x; PC3H710
U17: MCP9700-TT; SOT-23

Connections:
+12V: U15.4; also elsewhere on the board
/DAQ/ASTR_2_ANALOG: R69.1, TP6.1; also elsewhere on the board
/DAQ/ASTR_I_RATIO: R67.1, TP4.1; also elsewhere on the board
/DAQ/BSTR_2_ANALOG: R75.1, TP11.1; also elsewhere on the board
/DAQ/BSTR_I_RATIO: R73.1, TP9.1; also elsewhere on the board
/DAQ/INJECT_12V_ISO: C52.1, R72.1; also elsewhere on the board
/DAQ/INJECT_LOGIC: R70.2; also elsewhere on the board
/DAQ/LOWSIDE_ANALOG: D18.1 (K); also elsewhere on the board
/DAQ/MAIN1_2_ANALOG: R65.1, TP1.1; also elsewhere on the board
/MCU/ADC_0: TP2.1, U13.1, U13.2 (-); also elsewhere on the board
/MCU/ADC_1: TP7.1, U14.6 (-), U14.7; also elsewhere on the board
/MCU/ADC_2: TP12.1, U16.6 (-), U16.7; also elsewhere on the board
/MCU/ADC_3: TP3.1, U13.6 (-), U13.7; also elsewhere on the board
/MCU/ADC_8: TP5.1, U14.1, U14.2 (-); also elsewhere on the board
/MCU/ADC_9: TP10.1, U16.1, U16.2 (-); also elsewhere on the board
/MCU/ADC_10: U17.2 (Vout); also elsewhere on the board
GND: C42.1, C43.1, C44.2, C45.2, C46.1, C47.2, C48.1, C49.2, C50.2, C51.1, C52.2, C53.2, C54.1, C55.1, C56.2, R66.2, R68.2, R71.2, R74.2, R76.2, U13.4 (V-), U14.4 (V-), U15.2, U16.4 (V-), U17.3 (GND); also elsewhere on the board
unnamed: C44.1, R65.2, R66.1, U13.3 (+)
unnamed: C45.1, D18.2 (A), R64.2, U13.5 (+)
unnamed: C47.1, R67.2, R68.1, U14.3 (+)
unnamed: C49.1, R70.1, U15.1
unnamed: C50.1, R69.2, R71.1, U14.5 (+)
unnamed: C53.1, R73.2, R74.1, U16.3 (+)
unnamed: C56.1, R75.2, R76.1, U16.5 (+)
unnamed: R72.2, TP8.1, U15.3
VDDBU: C42.2, C43.2, C46.2, C48.2, C51.2, C54.2, C55.2, R64.1, U13.8 (V+), U14.8 (V+), U16.8 (V+), U17.1 (Vdd); also elsewhere on the board

Notes on the sheet:
LED I limited to 9mA R must be rated at least 1/8W
Output I limited to 50mA R must be rated at least 1/2W
All voltage dividing resistors must have tolerance <= 1%
DATA ACQUISITION

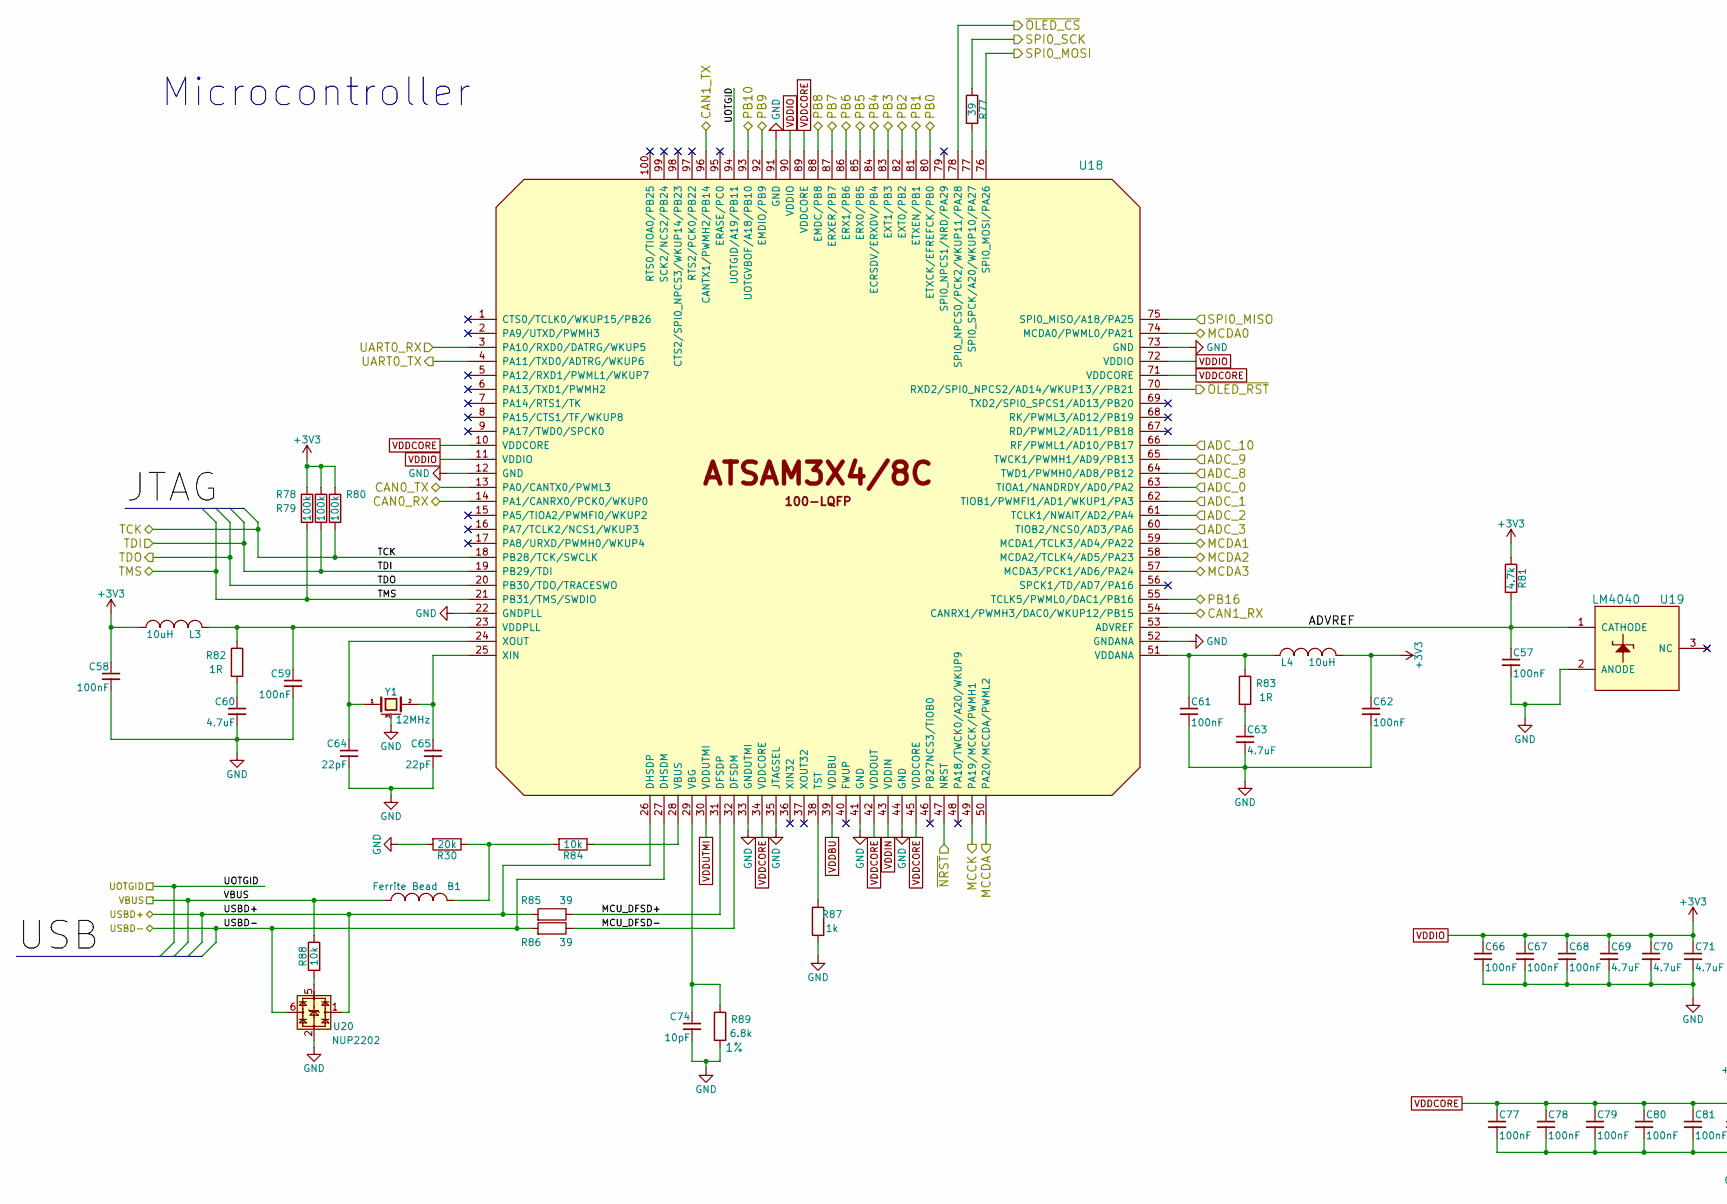
[picture p33: schematic MCU.sch, part in row 1, column 1]

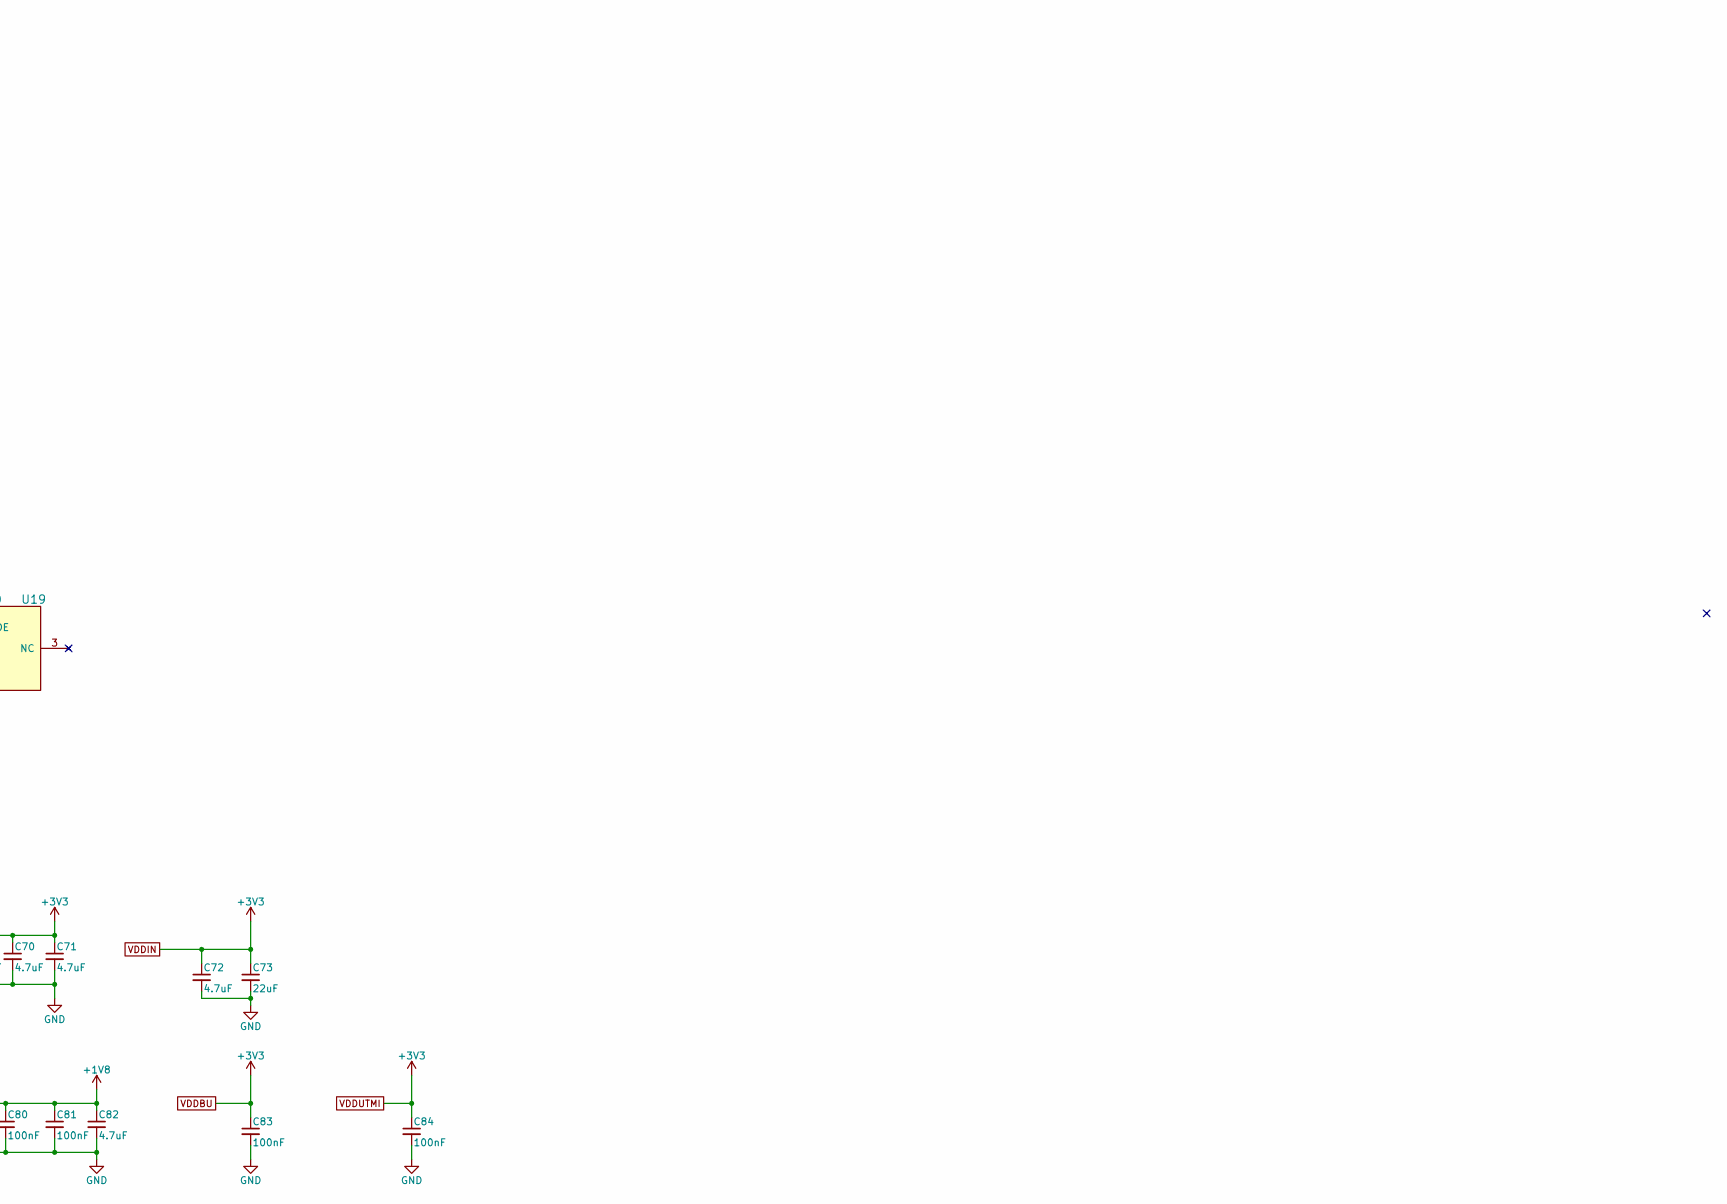
[picture p34: schematic MCU.sch, part in row 1, column 2]

Parts:
B1: Ferrite Bead; C_0805_OUTLINE
C57, C58, C59, C61, C62, C66, C67, C68, C77, C78, C79, C80, C81, C83, C84: 100nF; C_0603_OUTLINE
C60, C63, C69, C70, C71, C72, C82: 4.7uF; C_0805_OUTLINE
C64, C65: 22pF; C_0603_OUTLINE
C73: 22uF; C_1206_OUTLINE
C74: 10pF; C_0603_OUTLINE
L3, L4: 10uH; C_1210_OUTLINE
R30: 20k; R_0603_OUTLINE
R77, R85, R86: 39; R_0603_OUTLINE
R78, R79, R80: 100k; R_0603_OUTLINE
R81: 4.7k; R_0603_OUTLINE
R82, R83: 1R; R_0603_OUTLINE
R84, R88: 10k; R_0603_OUTLINE
R87: 1k; R_0603_OUTLINE
R89: 6.8k; R_0603_OUTLINE; Tolerance 1%
U18: SAM3X4/8C-100LQFP; LQFP-100_14x14mm_Pitch0.5mm
U19: LM4040; SOT-23
U20: NUP2202; SC-70-6
Y1: 12MHz; crystal_FA238-TSX3225

Connections:
/Contact_Drivers/ASTR_CONT_LOGIC: U18.88 (EMDC/PB8); also elsewhere on the board
/Contact_Drivers/BSTR_CONT_LOGIC: U18.92 (EMDIO/PB9); also elsewhere on the board
/Contact_Drivers/MAIN_1_CONT_LOGIC: U18.86 (ERX1/PB6); also elsewhere on the board
/Contact_Drivers/MAIN_2_CONT_LOGIC: U18.93 (UOTGVBOF/A18/PB10); also elsewhere on the board
/DAQ/INJECT_LOGIC: U18.55 (TCLK5/PWML0/DAC1/PB16); also elsewhere on the board
/Interface/BUZZ_GATE_DRIVE: U18.80 (ETXCK/EFREFCK/PB0); also elsewhere on the board
/Interface/OLED_DOWN: U18.85 (ERX0/PB5); also elsewhere on the board
/Interface/OLED_SCK: R77.1; also elsewhere on the board
/Interface/OLED_SDI: U18.76 (SPI0_MOSI/PA26); also elsewhere on the board
/Interface/OLED_SDO: U18.75 (SPI0_MISO/A18/PA25); also elsewhere on the board
/Interface/OLED_UP: U18.84 (ECRSDV/ERXDV/PB4); also elsewhere on the board
/Interface/~OLED_CS: U18.78 (SPI0_NPCS0/PCK2/WKUP11/PA28); also elsewhere on the board
/Interface/~OLED_RST: U18.70 (RXD2/SPI0_NPCS2/AD14/WKUP13//PB21); also elsewhere on the board
/MCU/ADC_0: U18.63 (TIOA1/NANDRDY/AD0/PA2); also elsewhere on the board
/MCU/ADC_1: U18.62 (TIOB1/PWMFI1/AD1/WKUP1/PA3); also elsewhere on the board
/MCU/ADC_2: U18.61 (TCLK1/NWAIT/AD2/PA4); also elsewhere on the board
/MCU/ADC_3: U18.60 (TIOB2/NCS0/AD3/PA6); also elsewhere on the board
/MCU/ADC_8: U18.64 (TWD1/PWMH0/AD8/PB12); also elsewhere on the board
/MCU/ADC_9: U18.65 (TWCK1/PWMH1/AD9/PB13); also elsewhere on the board
/MCU/ADC_10: U18.66 (RF/PWML1/AD10/PB17); also elsewhere on the board
/MCU/ADVREF: C57.1, R81.2, U18.53 (ADVREF), U19.1 (CATHODE)
/MCU/CAN0_RX: U18.14 (PA1/CANRX0/PCK0/WKUP0); also elsewhere on the board
/MCU/CAN0_TX: U18.13 (PA0/CANTX0/PWML3); also elsewhere on the board
/MCU/CAN1_RX: U18.54 (CANRX1/PWMH3/DAC0/WKUP12/PB15); also elsewhere on the board
/MCU/CAN1_TX: U18.96 (CANTX1/PWMH2/PB14); also elsewhere on the board
/MCU/MCCDA: U18.50 (PA20/MCCDA/PWML2); also elsewhere on the board
/MCU/MCCK: U18.49 (PA19/MCCK/PWMH1); also elsewhere on the board
/MCU/MCDA0: U18.74 (MCDA0/PWML0/PA21); also elsewhere on the board
/MCU/MCDA1: U18.59 (MCDA1/TCLK3/AD4/PA22); also elsewhere on the board
/MCU/MCDA2: U18.58 (MCDA2/TCLK4/AD5/PA23); also elsewhere on the board
/MCU/MCDA3: U18.57 (MCDA3/PCK1/AD6/PA24); also elsewhere on the board
/MCU/MCU_DFSD+: R85.1, U18.31 (DFSDP)
/MCU/MCU_DFSD-: R86.1, U18.32 (DFSDM)
/MCU/PB1: U18.81 (ETXEN/PB1); also elsewhere on the board
/MCU/PB2: U18.82 (EXT0/PB2); also elsewhere on the board
/MCU/PB3: U18.83 (EXT1/PB3); also elsewhere on the board
/MCU/PB7: U18.87 (ERXER/PB7); also elsewhere on the board
/MCU/TCK: R80.1, U18.18 (PB28/TCK/SWCLK); also elsewhere on the board
/MCU/TDI: R79.1, U18.19 (PB29/TDI); also elsewhere on the board
/MCU/TDO: U18.20 (PB30/TDO/TRACESWO); also elsewhere on the board
/MCU/TMS: R78.1, U18.21 (PB31/TMS/SWDIO); also elsewhere on the board
/MCU/UART0_RX: U18.3 (PA10/RXD0/DATRG/WKUP5); also elsewhere on the board
/MCU/UART0_TX: U18.4 (PA11/TXD0/ADTRG/WKUP6); also elsewhere on the board
/MCU/UOTGID: U18.94 (UOTGID/A19/PB11); also elsewhere on the board
/MCU/USBD+: R85.2, U18.26 (DHSDP), U20.1; also elsewhere on the board
/MCU/USBD-: R86.2, U18.27 (DHSDM), U20.6; also elsewhere on the board
/MCU/VBUS: B1.2, R88.1; also elsewhere on the board
/MCU/~NRST: U18.47 (NRST); also elsewhere on the board
GND: C57.2, C58.2, C59.2, C60.2, C61.2, C62.2, C63.2, C64.2, C65.2, C66.2, C67.2, C68.2, C69.2, C70.2, C71.2, C72.2, C73.2, C74.2, C77.2, C78.2, C79.2, C80.2, C81.2, C82.2, C83.2, C84.2, R30.2, R87.2, R89.2, U18.12 (GND), U18.22 (GNDPLL), U18.33 (GNDUTMI), U18.35 (JTAGSEL), U18.41 (GND), U18.44 (GND), U18.52 (GNDANA), U18.73 (GND), U18.91 (GND), U19.2 (ANODE), U20.2, Y1.3 (case); also elsewhere on the board
unnamed: B1.1, R30.1, R84.2
unnamed: C59.1, L3.1, R82.1, U18.23 (VDDPLL)
unnamed: C60.1, R82.2
unnamed: C61.1, L4.1, R83.1, U18.51 (VDDANA)
unnamed: C63.1, R83.2
unnamed: C64.1, U18.24 (XOUT), Y1.1
unnamed: C65.1, U18.25 (XIN), Y1.2
unnamed: C74.1, R89.1, U18.29 (VBG)
unnamed: R77.2, U18.77 (SPI0_SPCK/A20/WKUP10/PA27)
unnamed: R84.1, U18.28 (VBUS)
unnamed: R87.1, U18.38 (TST)
unnamed: R88.2, U20.5
VDDBU: C58.1, C62.1, C66.1, C67.1, C68.1, C69.1, C70.1, C71.1, C72.1, C73.1, C83.1, C84.1, L3.2, L4.2, R78.2, R79.2, R80.2, R81.1, U18.11 (VDDIO), U18.30 (VDDUTMI), U18.39 (VDDBU), U18.43 (VDDIN), U18.72 (VDDIO), U18.90 (VDDIO); also elsewhere on the board
VDDCORE: C77.1, C78.1, C79.1, C80.1, C81.1, C82.1, U18.10 (VDDCORE), U18.34 (VDDCORE), U18.42 (VDDOUT), U18.45 (VDDCORE), U18.71 (VDDCORE), U18.89 (VDDCORE)

Notes on the sheet:
Microcontroller

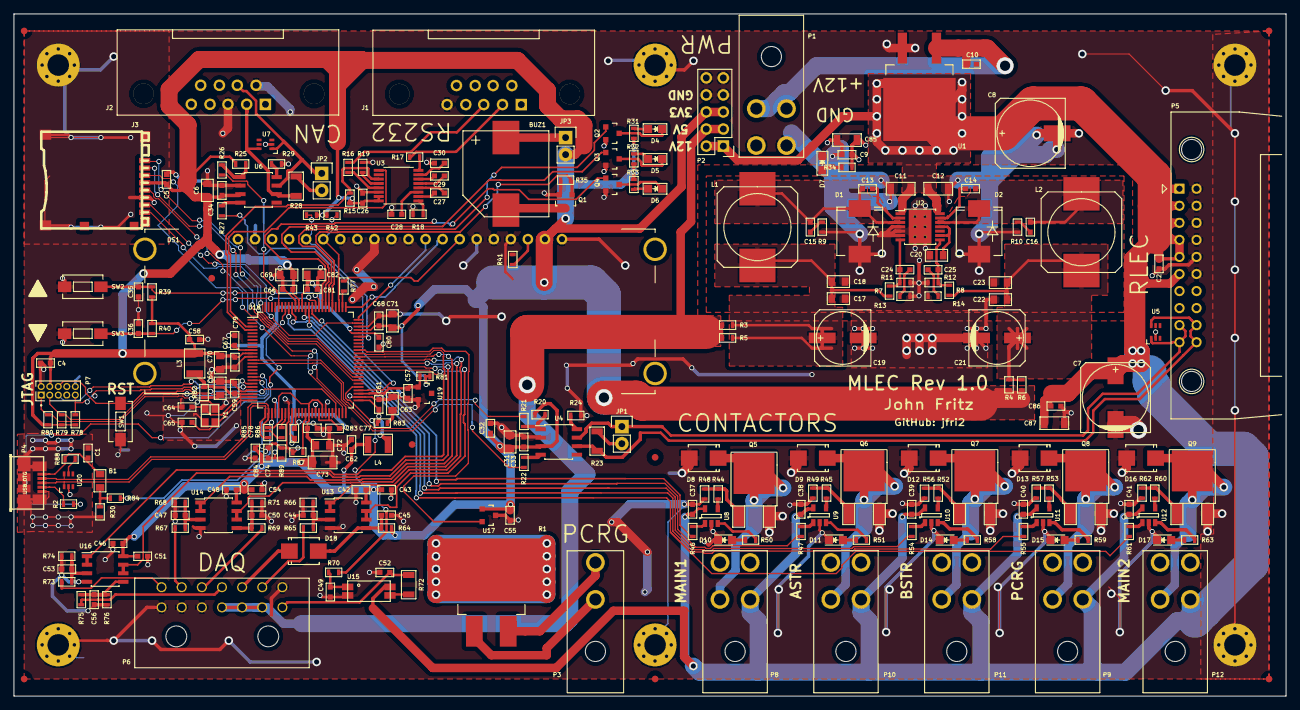
[picture p35: board ATSAM_Based_Battery_Management_System.kicad_pcb from above]

Board: 2 copper layers, 189.5 x 101.6 mm, 259 parts (0 on the bottom side), 161 nets.
