jfri2/Purdue_MLEC/Software/CANBusMonitor/CANBusMonitor/CANBusMonitor/uart.c

//******************************************************************************
//! @file $RCSfile: uart.c,v $
//!
//! Please read file license.txt for copyright notice.
//!
//! @brief This file contains the function definitions for uart.
//!			- LINDAT register is uart data register.
//!			- LINCR register is lin/uart control register
//!			- LINSIR register is LIN status and interrupt register
//!			- LINENIR register is LIN enable interrupt register
//!			- LINERR register is LIN error register
//!			- LINBTR is LIN bit timing register
//!			- LINBRR is lin baud rate register
//!
//!
//! This file can be parsed by Doxygen for automatic documentation generation.
//!
//! @version $Revision: 0.00 $ $Name: John Fritz (jfri2) $
//!
//! @todo	Add function def doc, more other doc, add more fns if necessary
//! @bug
//******************************************************************************
#ifndef _UART_C_
#define _UART_C_

#include "uart.h"
#include "gpio.c"

static FILE avrStdOut = FDEV_SETUP_STREAM(uart_SendByteStream, uart_GetByteStream, _FDEV_SETUP_RW);

void uart_init(uint16_t baudRate) {
	/* set uart no parity, 8 data bits, 1 stop bit */
	/* enable lin/uart */
	/* UART Rx and Tx Byte Enable */
	LINCR = 0b00001111;
		
	/* Enable error, transmit performed, receive performed interrupts */
	//LINENIR |= (1<<LENERR)|(1<<LENTXOK)|(1<<LENRXOK);
		
	/* set baud rate in LINBRR register */	
	/* baud rate is scaled clk / value */
	//baudDivider = (uint16_t)((F_CPU / ((LINBTR & 0b00011111) * baudRate )) - 1);
	LINBRRH = (((F_CPU/baudRate)/32)-1)>>8;
	LINBRRL = (((F_CPU/baudRate)/32)-1);
	
	stdout = &avrStdOut;	//define output stream
	stdin = &avrStdOut;		//define input stream
}

uint8_t uart_checkErrorRegister(void) {
	/* Bitmask error register to get specific error
	 * 
	 * No errors: returns 0
	 * Bit7: Abort Flag
	 * Bit6: Frame_time_out error flag
	 * Bit5: Overrun error flag
	 * Bit4: Framing error flag
	 * Bit3: Sync error flag
	 * Bit2: Parity error flag
	 * Bit1: Checksum error flag
	 * Bit0: Bit error flag
	 */
	return LINERR;
}

void uart_SendByte(uint8_t data) {
	while((LINSIR & (1<<LBUSY)) != 0);	// wait until uart is not busy
	LINDAT = data;	// put data into register to be sent out
}

uint8_t uart_GetByte(void) {
	while((LINSIR & (1<<LBUSY)) != 0);	// wait until uart is not busy
	return(LINDAT);	// return data from LINDAT register
}

void uart_SendByteStream(uint8_t data, FILE *stream) {
	while((LINSIR & (1<<LBUSY)) != 0);	// wait until uart is not busy
	LINDAT = data;	// put data into register to be sent out
}

uint8_t uart_GetByteStream(FILE *stream) {
	while((LINSIR & (1<<LBUSY)) != 0);	// wait until uart is not busy
	return(LINDAT);	// return data from LINDAT register	s
}

#endif
