jfri2/Purdue_MLEC/Software/MLEC/ATSAM3X8C_TEST/src/config/conf_board.h

/**
 * \file
 *
 * \brief User board configuration template
 *
 */
/*
 * Support and FAQ: visit <a href="http://www.atmel.com/design-support/">Atmel Support</a>
 */

#ifndef CONF_BOARD_H
#define CONF_BOARD_H

/* These definitions enable various peripherals */
#define CONF_BOARD_CONTACTORS
#define CONF_BOARD_UI
#define CONF_BOARD_USART_CONSOLE
#define CONF_BOARD_OLED_SPI
#define CONF_BOARD_V_CAN
#define CONF_BOARD_RLEC_CAN


#endif // CONF_BOARD_H
