jfri2/Purdue_MLEC/Software/MLEC/ATSAM3X8C_TEST/src/config/conf_usart.h

/*
 * conf_usart.h
 *
 * Created: 5/9/2016 2:12:55 PM
 *  Author: John
 */ 


#ifndef CONF_USART_H_
#define CONF_USART_H_

/* USART0 Configuration Definitions */
#define USART0_ID			ID_USART0
#define USART0_BAUD			115200
#define USART0_CHMODE		US_MR_CHMODE_NORMAL
#define USART0_CHARLEN		US_MR_CHRL_8_BIT
#define USART0_PARITY		US_MR_PAR_NO
#define USART0_STOPBITS		US_MR_NBSTOP_1_BIT


#endif /* CONF_USART_H_ */
