jfri2/Purdue_MLEC/(commit log)

2016-05-09 Initial Commit
    Hardware v1.0
    Software still in dev
    [430451401.stp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]
2016-05-21 Removed USB, and SPI. Fixed hard fault issue
    Never use pio_set_pin_high or pio_set_pin_low functions - was
    hardfaulting when those were active
    [430451401.stp]
